forth32/dvk-fpga/board/tang/pict/ioboardb.png

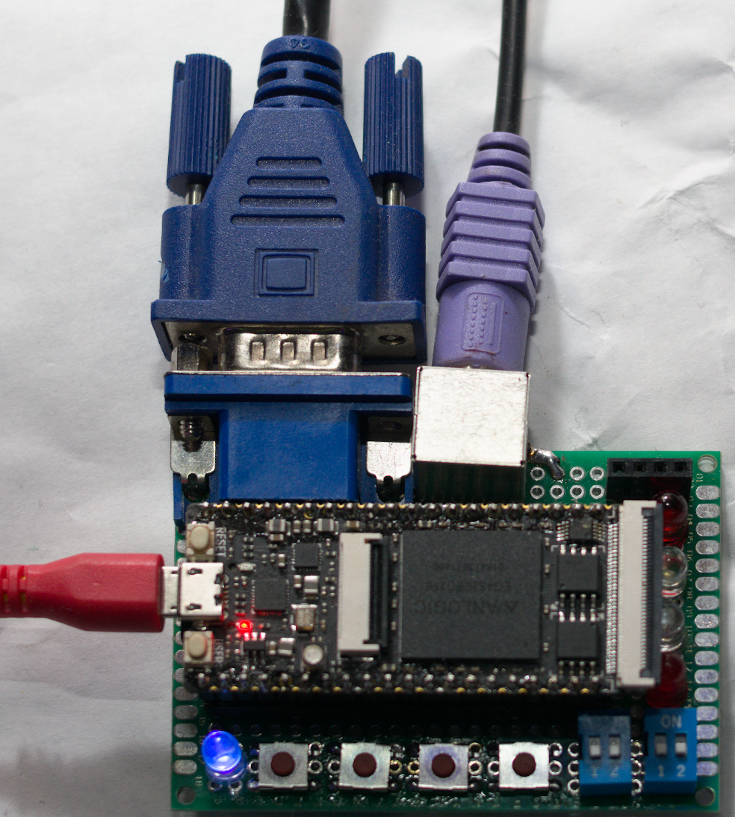
board/tang/pict/ioboardb.png
