forth32/dvk-fpga/board/tang/pict/ioboards.png

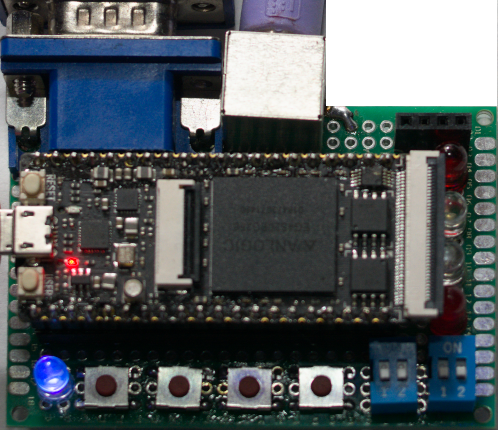
board/tang/pict/ioboards.png
