forth32/dvk-fpga/board/tang/pinout.ods

Led[0] | RK | R2
Led[1] | DW | P2
Led[2] | MY | N5
Led[3] | DX | C9
Led[4] | Timer | L12
sw[0] | disk0 | A4
sw[1] | disk1 | A3
sw[2] | console | C5
sw[3] | cpu speed | B6
bt[0] | reset | B10
bt[1] | halt | B15
bt[2] | term_rst | E16
bt[3] | timer | J11
 | PS2 Clk | T7
 | PS2 Data | R7
 | VGA R | M12
 | VGA G | R16
 | VGA B | N12
 | VGA HS | P12
 | VGA VS | N11
