forth32/dvk-fpga/board/QMTECH-E55/pinout.ods

QMTECH EP55 pinout
SDRAM
A0 | V2 |  | DQ0 | AA10
A1 | V1 |  | DQ1 | AB9
A2 | U2 |  | DQ2 | AA9
A3 | U1 |  | DQ3 | AB8
A4 | V3 |  | DQ4 | AA8
A5 | V4 |  | DQ5 | AB7
A6 | Y2 |  | DQ6 | AA7
A7 | AA1 |  | DQ7 | AB5
A8 | Y3 |  | DQ8 | Y7
A9 | V5 |  | DQ9 | W8
A10 | W1 |  | DQ10 | Y8
A11 | Y4 |  | DQ11 | V9
A12 | V6 |  | DQ12 | V10
BA0 | Y1 |  | DQ13 | Y10
BA1 | W2 |  | DQ14 | W10
CKE | W6 |  | DQ15 | V11
CLK | Y6 |  | CS | AA3
LDQM | AA5 |  | WE | AB4
UDQM | W7 |  | RAS | AB3
 |  |  | CAS | AA4
SD card
SD | SPI
DAT2 |  | AB16
DAT3 | CS | AA16
CMD | DI (MOSI) | AB15
CLK | SCLK | AA15
DAT0 | DO (MISO) | AB14
DAT1 |  | AA14
CD |  | AB13
UART
RxD | J2
TxD | J1
LED-дисплей
col0 | B5 |  | seg_A | C4
col1 | B3 |  | seg_B | B2
col2 | B6 |  | seg_C | A3
 |  |  | seg_D | C3
 |  |  | seg_E | A5
 |  |  | seg_F | B4
 |  |  | seg_G | B1
 |  |  | DP | A4
VGA
R0 | N20 |  | G0 | D22
R1 | B21 |  | G1 | E21
R2 | M20 |  | G2 | C22
R3 | N19 |  | G3 | D21
R4 | M19 |  | G4 | C21
B0 | H21 |  | G5 | B22
B1 | H22
B2 | F21 |  | HS | J21
B3 | F22 |  | VS | J22
B4 | E22
Кнопки
SW1 | AA13 |  | key0 | W13
SW2 | A10 |  | key1 | Y13
SW3 | B10
SW4 | A9
SW5 | B9
Светодиоды
LED1 | A8 |  | LED0 | E4
LED2 | B8
LED3 | A7
LED4 | B7
LED5 | A6
Тактовый генератор
clk50 | T2
