forth32/dvk-fpga/board/tang/pict/ioboard-rs232.png

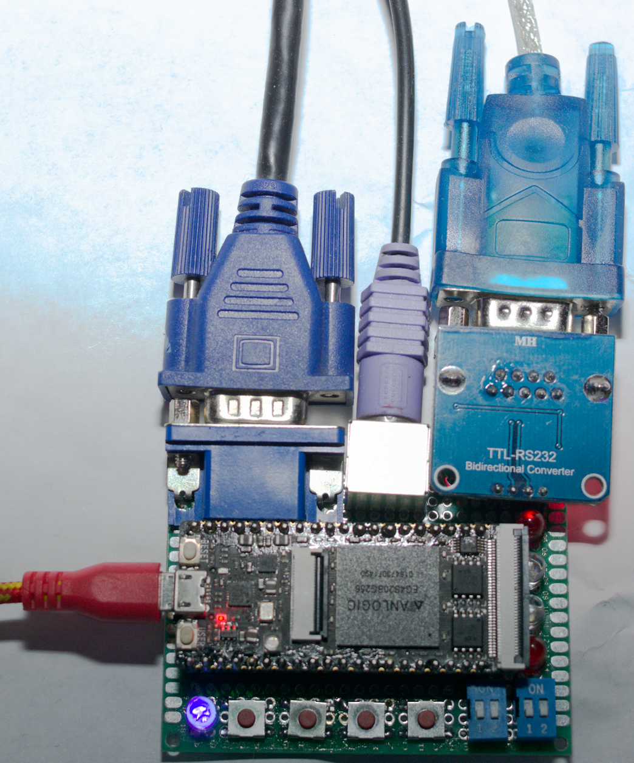
board/tang/pict/ioboard-rs232.png
