forth32/dvk-fpga/board/tang/pict/tang.jpg

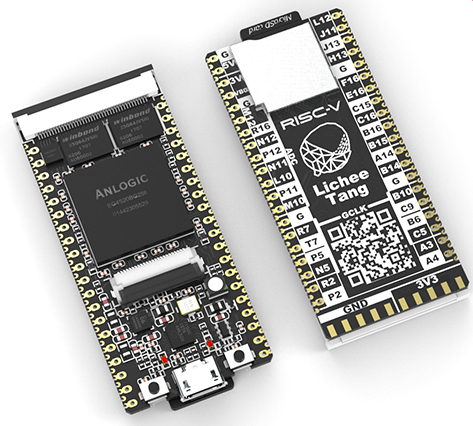
board/tang/pict/tang.jpg
