forth32/dvk-fpga/screenshot/basic.png

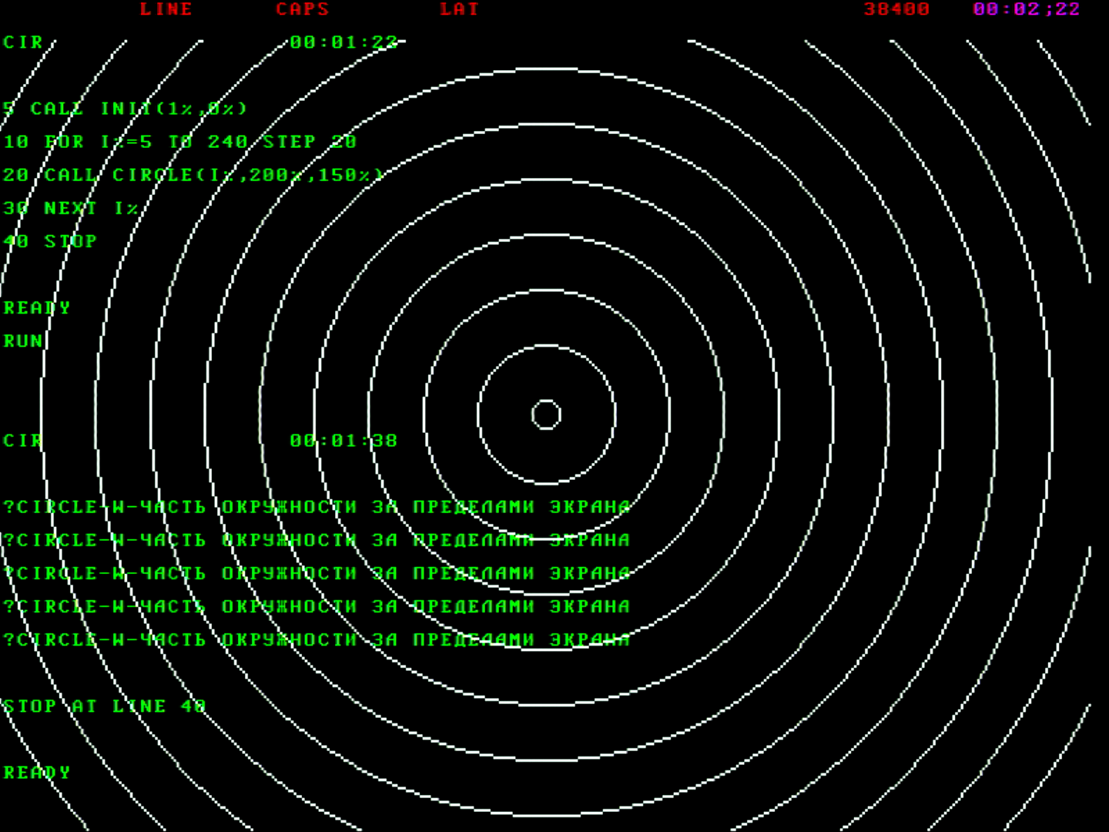
screenshot/basic.png
