forth32/dvk-fpga/screenshot/clock.png

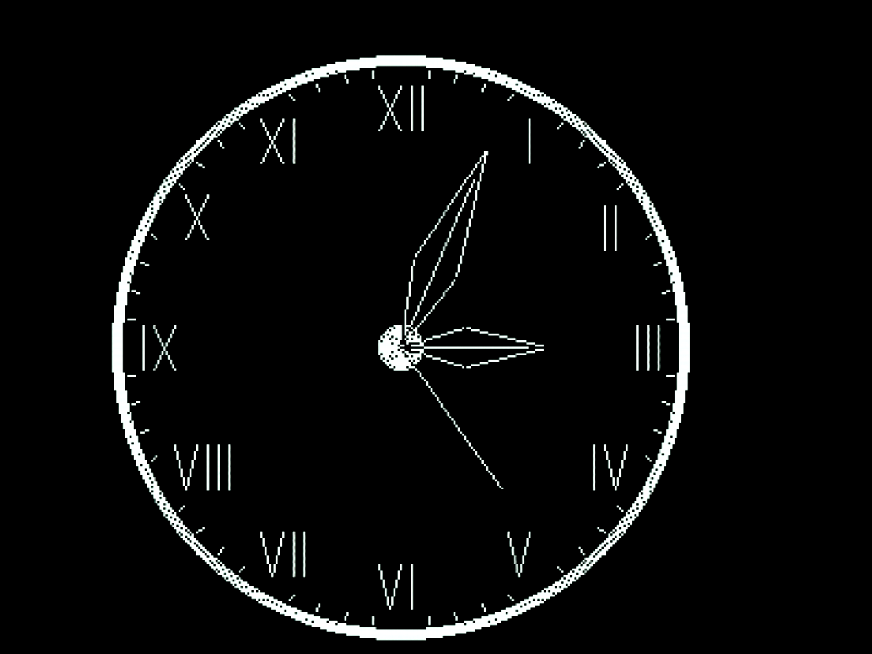
screenshot/clock.png
