forth32/dvk-fpga/screenshot/diger.png

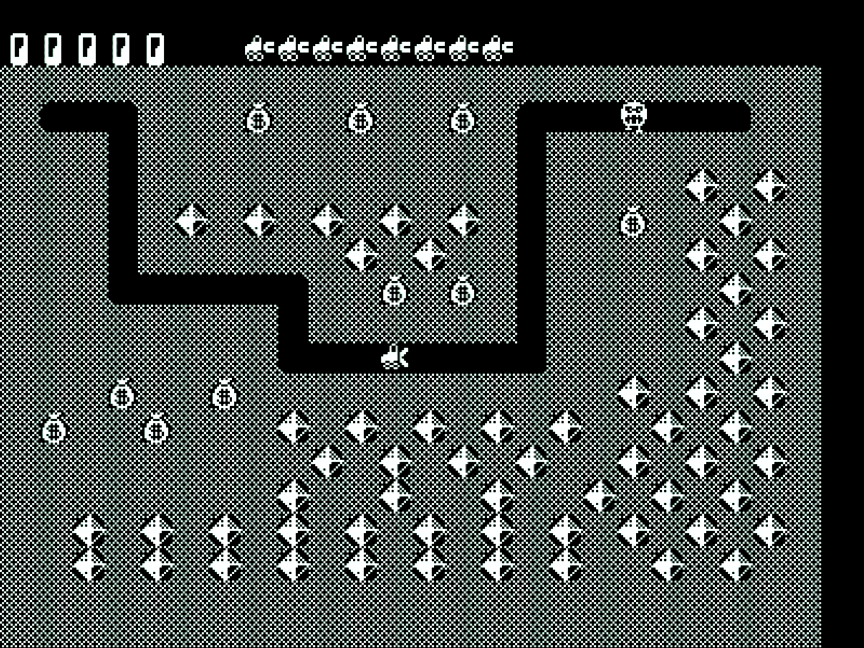
screenshot/diger.png
