forth32/dvk-fpga/screenshot/fmg.png

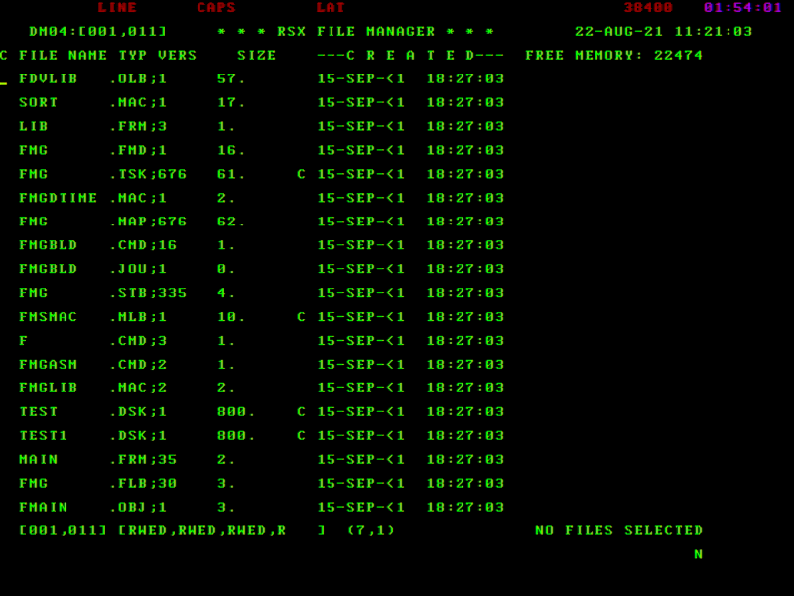
screenshot/fmg.png
