forth32/dvk-fpga/screenshot/ksmfont-rt11.png

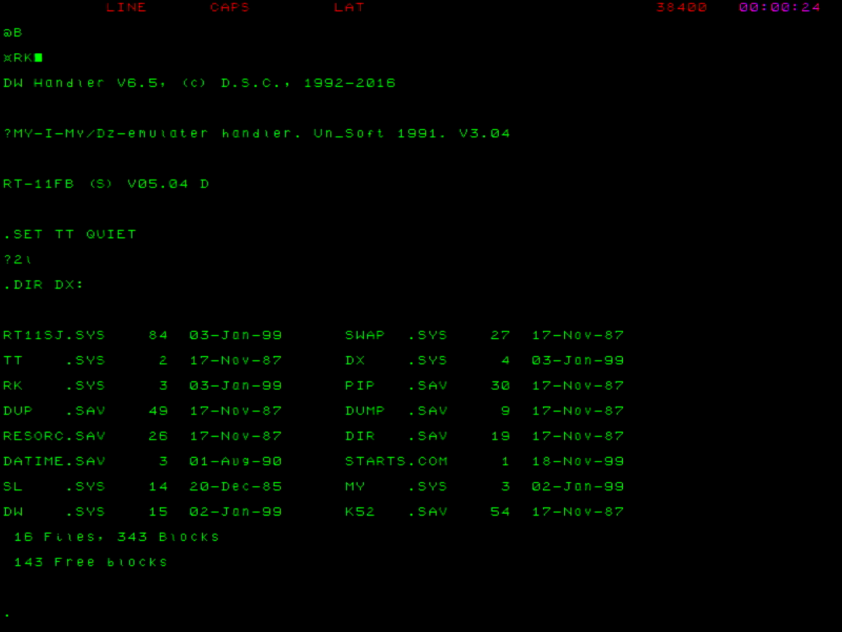
screenshot/ksmfont-rt11.png
