forth32/dvk-fpga/screenshot/land.png

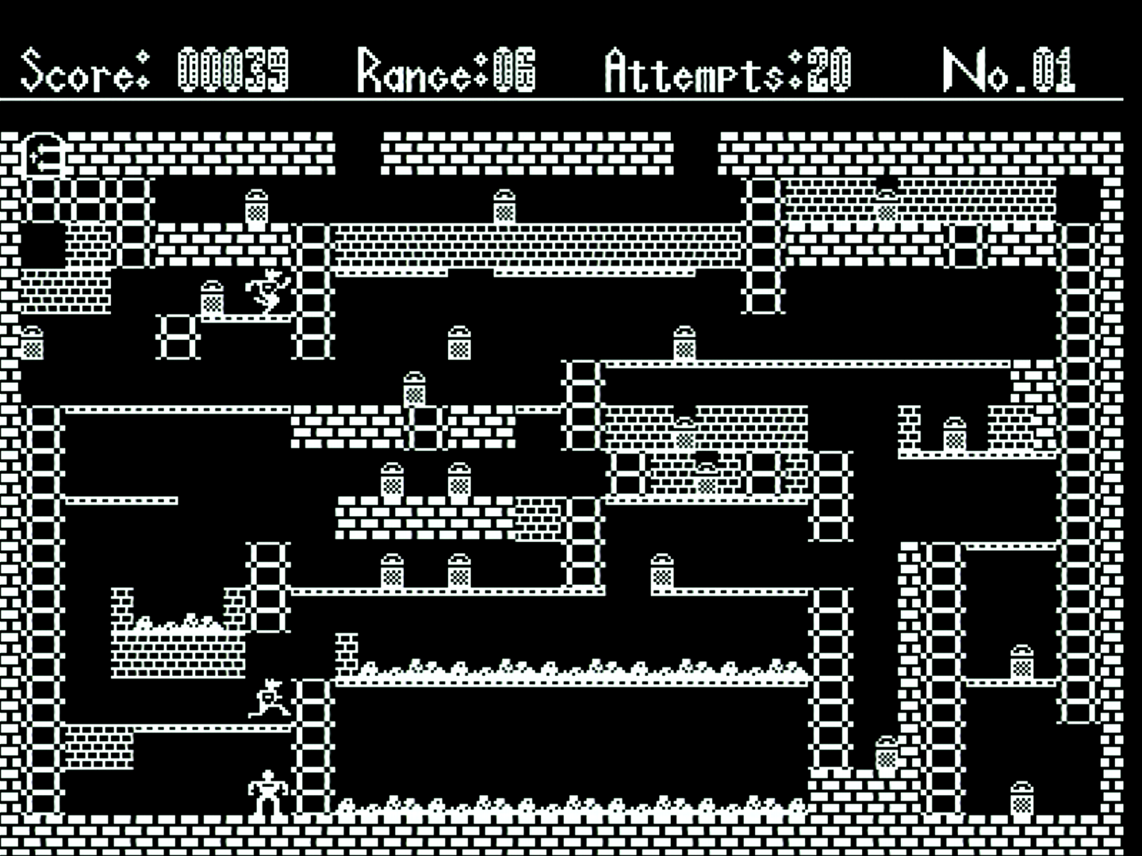
screenshot/land.png
