forth32/dvk-fpga/screenshot/ramtest.png

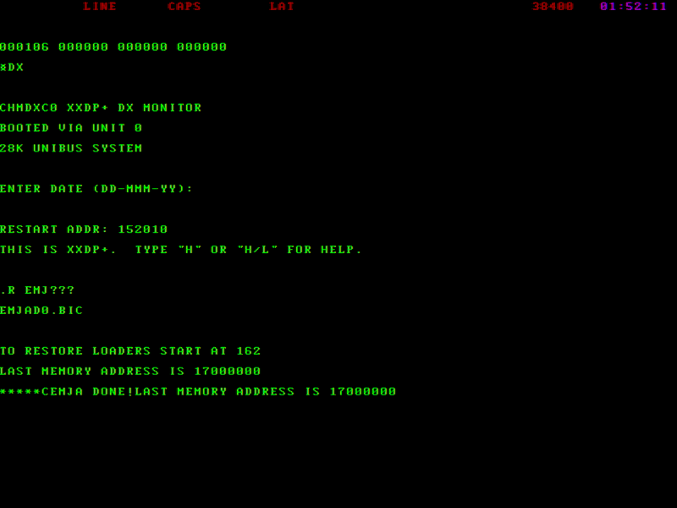
screenshot/ramtest.png
