forth32/dvk-fpga/screenshot/rsts10-mon1.png

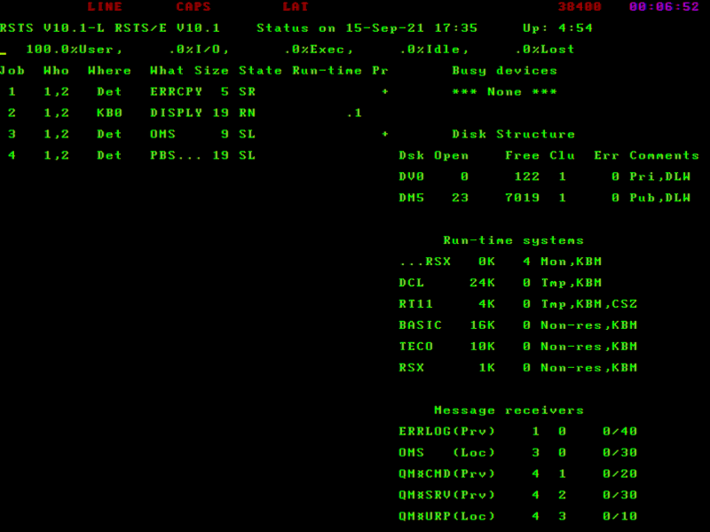
screenshot/rsts10-mon1.png
