forth32/dvk-fpga/screenshot/rsts10-mon2.png

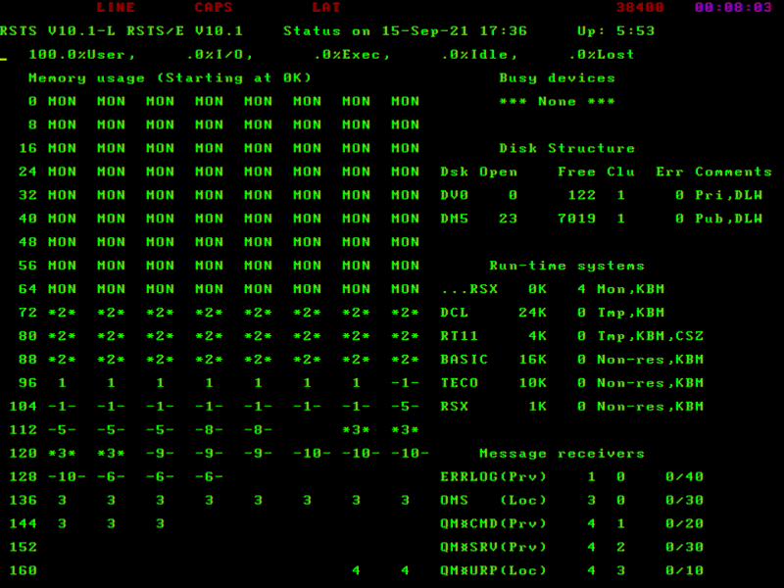
screenshot/rsts10-mon2.png
