forth32/dvk-fpga/screenshot/rsts-boot.png

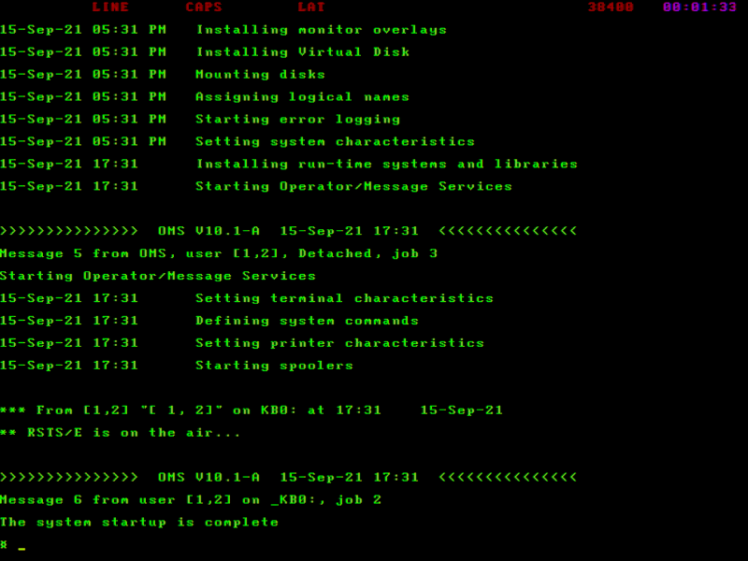
screenshot/rsts-boot.png
