forth32/dvk-fpga/screenshot/rsx11m-boot.png

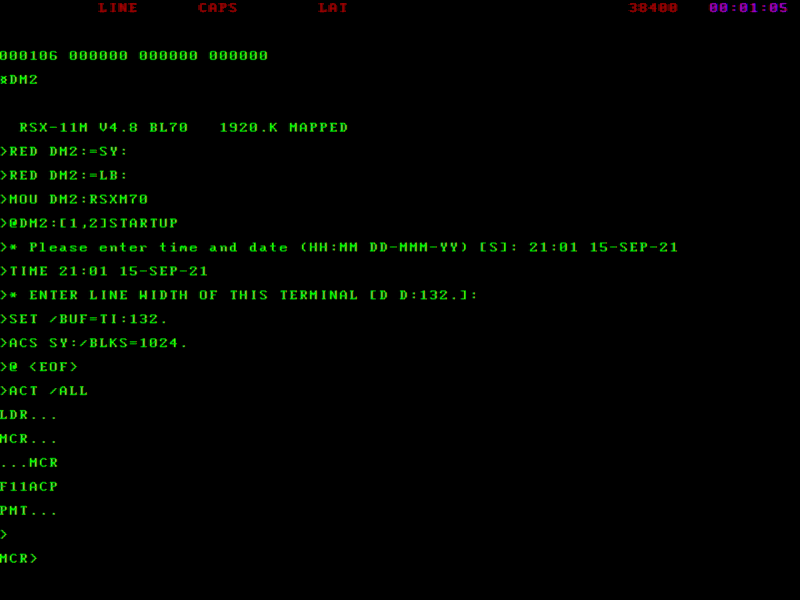
screenshot/rsx11m-boot.png
