forth32/dvk-fpga/screenshot/rsx11m-plus-boot.png

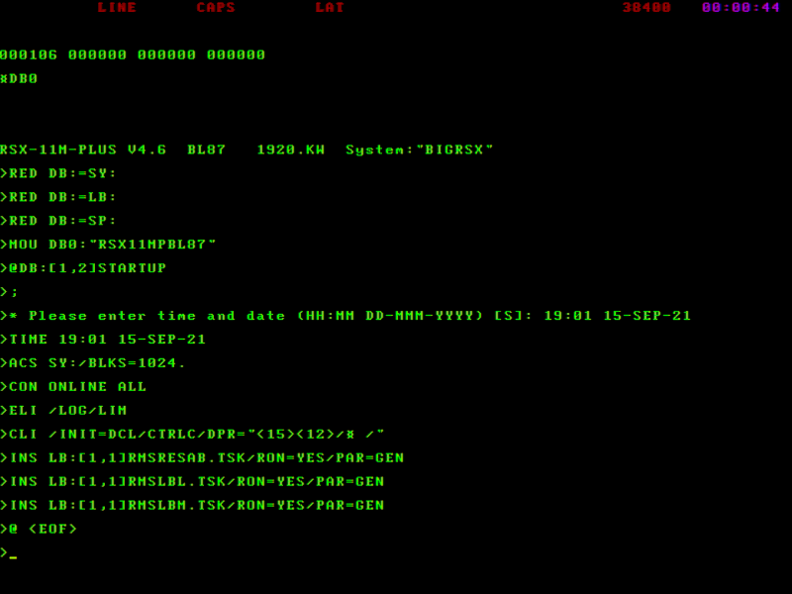
screenshot/rsx11m-plus-boot.png
