forth32/dvk-fpga/screenshot/rsx11m-plus-rmd.png

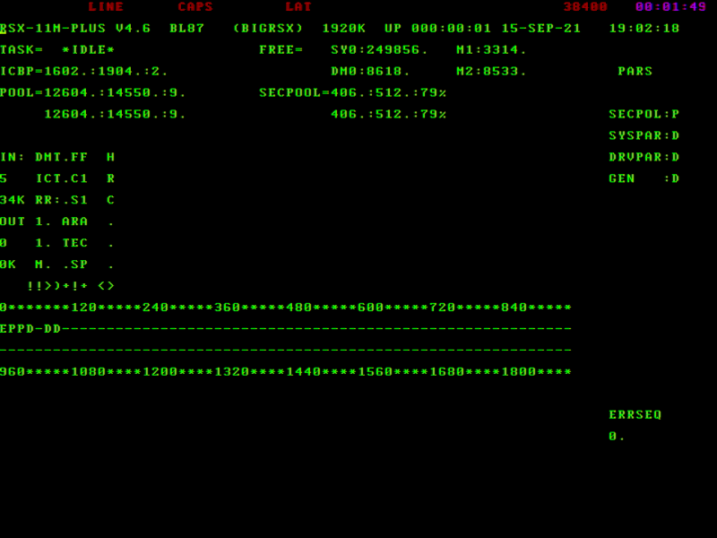
screenshot/rsx11m-plus-rmd.png
