forth32/dvk-fpga/screenshot/statusline.png

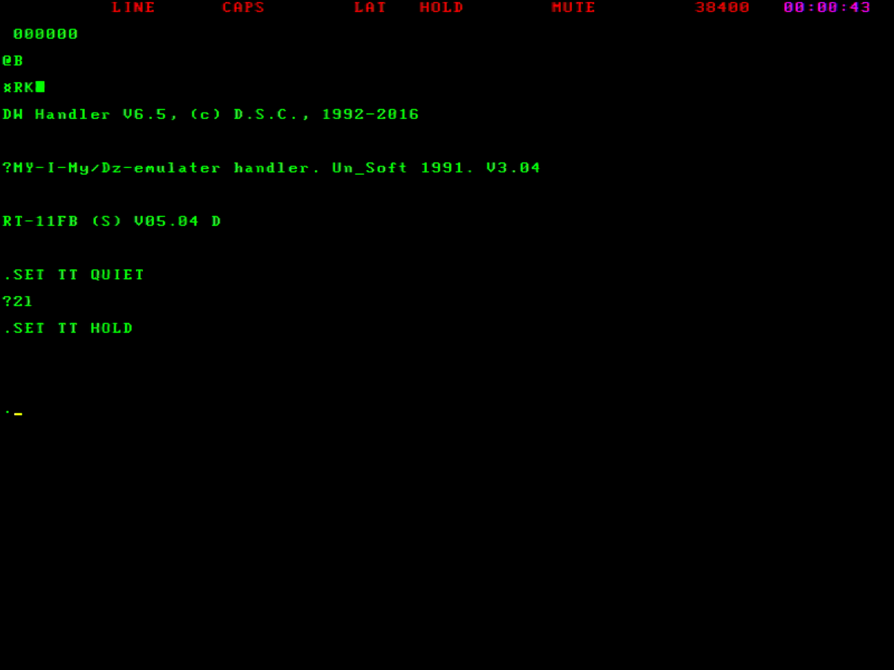
screenshot/statusline.png
