forth32/dvk-fpga/screenshot/ted.png

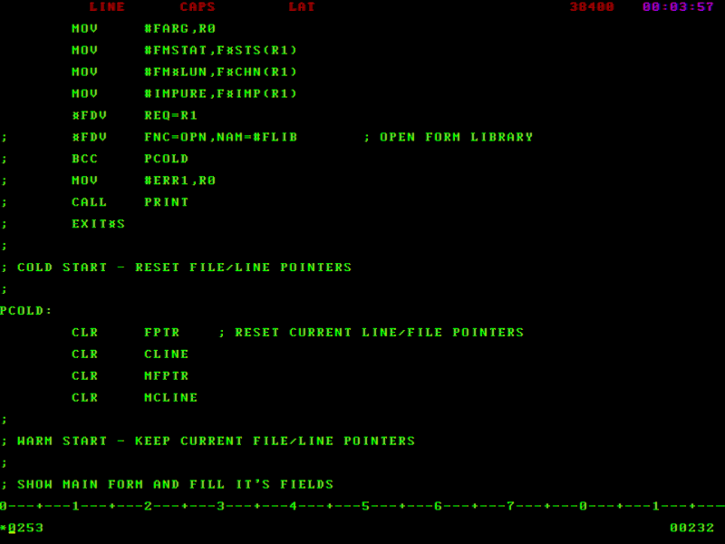
screenshot/ted.png
