forth32/dvk-fpga/screenshot/tmos1-ksmfont.png

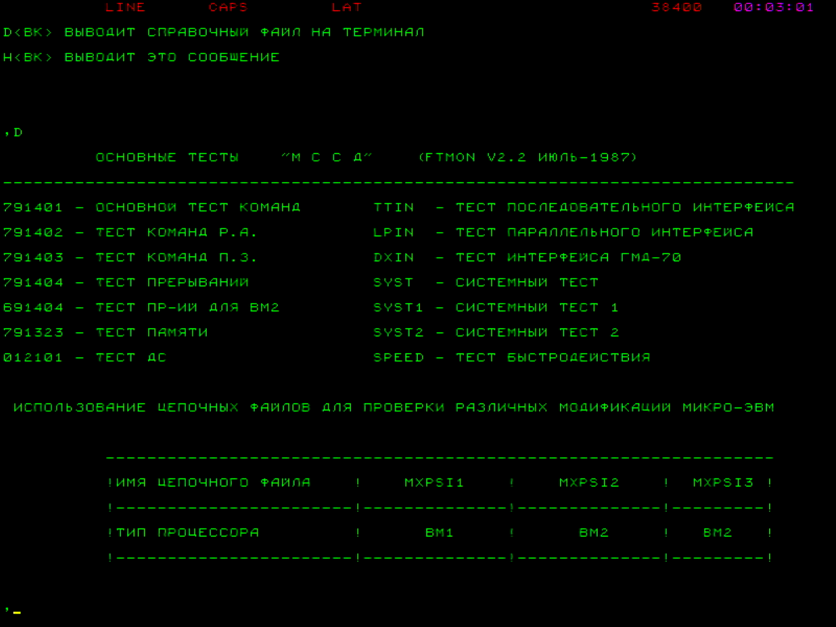
screenshot/tmos1-ksmfont.png
