forth32/dvk-fpga/screenshot/tmos.png

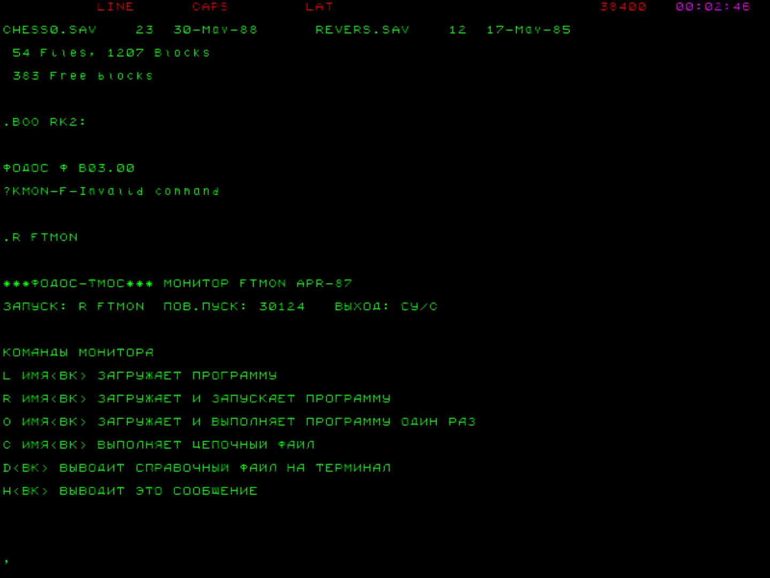
screenshot/tmos.png
