forth32/dvk-fpga/doc/main-manual.odt

FPGA-конструктор

советских ЭВМ

ДВК-1

ДВК-2

ДВК-3

ДВК-4

Электроника-60(-1)

Электроника-79

Описание проекта

# 1. Введение

Данная разработка является FPGA-конструктором, позволяющим из набора готовых модулей собрать FPGA-вариант старых советских pdp11-совместимых ЭВМ. Проект охватывает микро-ЭВМ серий ДВК-1, ДВК-2, ДВК-3, ДВК-4 и Электроника-60/60M, а также ЭВМ Электроника-79, являющихся архитектурными подобиями соответствующих ЭВМ серии pdp-11 фирмы DEC.

Изначально я был вынужден заняться этой разработкой для замены окончательно вышедшей из строя процессорной платы, стоящей в контроллере испытательного стенда в нашей лаборатории. Тут очень кстати великий VSLAV подарил миру FPGA-версию процессора 1801ВМ2, чем и спас наше оборудование. В процессе разработке оказалось проще сделать на FPGA весь контроллер, чем эмулировать асинхронную шину МПИ, в результате чего получилась ДВК-совместимая машина, управляющая нашим стендом. Эта разработка уже полгода работает у нас в лаборатории в достаточно напряженном режиме, и все явные баги более-менее выявлены и устранены.

Проект основан на всех процессорных ядрах, для которых VSLAV произвел реверс и создал рабочее HDL-описание, а также на универсальном синтетическом ядре PDP2011. Возможно, когда-нибудь список поддерживаемых процессоров будет расширен, все зависит от нашего великого цифрвого археолога.

# 2. Общая структура проекта

Все поддерживаемые проектом советские микро-ЭВМ были модульными, и представляли собой соединительную корзину, в которую устанавливались процессорная плата и несколько плат периферийных устройств. Данный проект имеет такую же структуру, содержит ряд готовых процессорных и периферийных плат, и позволяет добавлять также и пользовательские устройства. В этом проекте в качестве общей шины, вместо асинхронной МПИ, используется синхронная шина Wishbone.

В составе проекта имеются процессорные платы, основанных на имеющихся процессорных ядрах:

- К1801ВМ1
- К1801ВМ2
- К1801ВМ3
- М2 (LSI-11)
- М4 (LSI-11M)
- F11 (KDF11B)
- PDP2011 (pdp11/70)

Особенности этих плат рассматриваются в соответствующем разделе.

Также в проект входят модули периферийных устройств, из которых набирается конфигурация ЭВМ:

- Последовательный порт ИРПС, используемый для подключения консольного терминала (TT:), а также дополнительных терминалов, последовательных принтеров (LS:) и магистралей связи с другими ЭВМ (XL:). В конфигурацию по умолчанию входят два таких модуля.
- Параллельный порт ИРПР (LP:) для подключения параллельного принтера. Внешний интерфейс модуля использует протокол Centronics, поскольку настоящих ИРПР-принтеров уже не осталось в природе.
- Дисковый контроллер RK11 (RK:) с подключенными к нему 8 дисками RK05. Советский аналог — СМ5400.
- Дисковый контроллер RK611 (DM:) с подключенными к нему 8 дисками RK07. Советский аналог — СМ5408.
- Дисковый контроллер RH-11/RH-70 (DB:) с подключенными к нему 8 дисками RP06. Советский аналог — ЕС5067.
- Дисковый контроллер RX11 (DX:) с подключенными к нему двумя дисками RX01 (он же ГМД-70)
- Дисковый контроллер КМД (MY:) с подключенными к нему двумя дисководами НГМД-6121 (4 логических диска).
- Контроллер жесткого диска RD50C (DW:) с подключенным к нему HDD на 64М. Контроллер выполнен в стандарте ДВК, а не оригинальном дековском, и для работы требует драйвер DW именно от ДВК (штатный драйвер DW из поставки rt-11 работать не будет).
- Текстовый терминал КСМ (контроллер символьного монитора) с VGA-выходом, подключенный к консольному ИРПС. Скорости терминала и ИРПС аппаратно согласованы.
- Графический контроллер КГД (монхромный контроллер графического дисплея).
- Динамическая память SDRAM размером 4 Mбайт.
- ПЗУ размером 1К с эмулятором пульта и набором загрузчиков, соответствующий DEC M9312.
- Пользовательское ПЗУ размером 8К

Любой ненужный модуль можно легко выкинуть из конфигурации для экономии ресурсов FPGA. Некоторые модули могут работать только совместно (КГД не работает без КСМ). Кроме того, к общей шине можно подключать и другие самодельные модули, создавая нужную пользователю конфигурацию ЭВМ. Например, у меня в конфигурацию входят модули ЦАП, АЦП и дискретного ввода-вывода для подключения к стенду. Рекомендации по написанию таких модулей находятся в отдельном документе build-own-modules.

В полном составе плата является одноплатной версией соответствующей ЭВМ со встроенным терминалом. Вот пример экрана дисплея КСМ с загруженной RT-11:

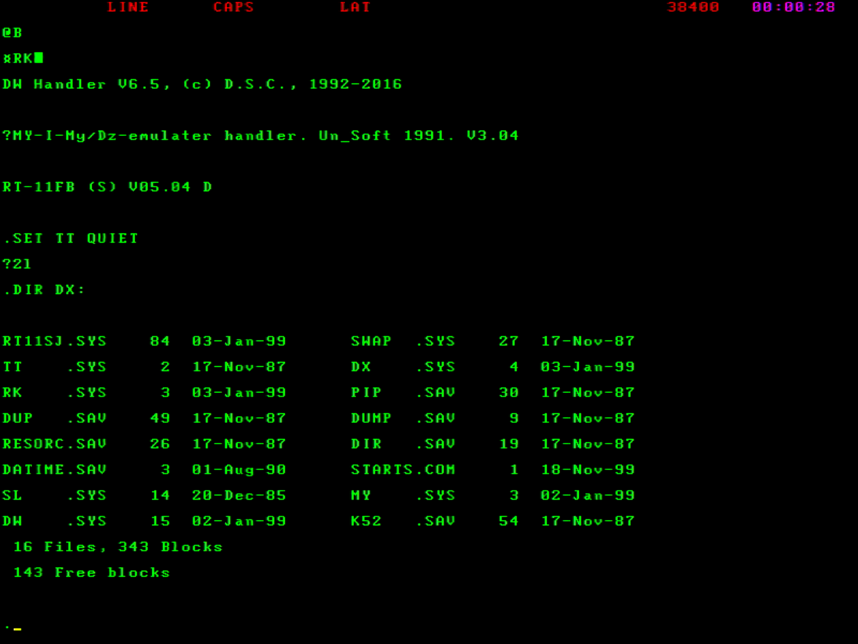
[picture p28: figure]

Поскольку быстродействие полученной ЭВМ гораздо выше прототипа, в схеме имеется возможность снизить тактовую частоту с помощью переключателя sw_cpuslow для работы с игрушками и другими интерактивными программами.

# 3. Используемые FPGA

Разработка сделана на основе FPGA серии Cyclone 4 фирмы Altera (увы, теперь это уже intel). В полном составе схема занимает чуть меньше 9000 ячеек и влезает в микросхему EP4CE10 при использовании процессоров с 16-битным адресом без MMU. Если выкинуть часть дисковых контроллеров и КГД, то схема поместится в самую младшую микросхему этой серии – EP4CE6. Варианты с MMU занимают более 15000 ячеек, и в младшие варианты Cyclone 4 уже не помещается.

Из аппаратных особенностей Cyclone в схеме используется только статическая память (altsyncram) и генератор тактовых сигналов PLL. Поэтому схема легко может быть портирована на Cyclone других серий и вообще куда угодно, лишь бы хватило ресурсов.

В проекте используются следующие модули статической памяти altsyncram:

- rom000 — ROM размером 4096*16 бит, предзагруженный ПЗУ 000 (rom/000.mif) — теневой монитор платы МС1201.01.
- rom055 — ROM размером 4096*16 бит, предзагруженный ПЗУ 055 (rom/055.mif) или 279 (rom/279.mif) — теневой монитор платы МС1201.02.
- rom134 — ROM размером 4096*16 бит, предзагруженный ПЗУ 134(rom/134.mif) - теневой монитор платы МС1201.03/04.
- boot_diag_rom - ROM размером 2048*16, предзагруженный ПЗУ загрузки/диагностики платы kdf11b (rom/f11/boot_diag_rom.mif).
- fontrom — ROM размером 32768*1 бит, предзагруженный файлом экранного шрифта ksm-firmware/font/font-main.mif или ksm-firmware/font/font-ksm.mif..
- vtmem — RAM размером 2048*16, предзагруженный терминальной микропрограммой ksm-firmware/terminal.mif
- kgdram — двухпортовая RAM размером 16384*8, являющаяся видеопамятью графического контроллера КГД. Второй порт этого модуля имеет 1-битную шину данных.
- sectorbuf — двухпортовая RAM размером 256*16, используется модулем SDSPI в качестве секторного буфера.
- bootrom — ROM размером 512*16 бит, содержащий эмулятор пульта и набор загрузчиков DEC M9312.
- userrom — ROM размером 4096*16 бит для хранения образа ПЗУ пользователя.

Если вы используете FPGA серии, отличный от Altera Cyclone, то описатели PLL и модулей памяти придется переделать или создать заново.

Для удобства все файлы, относящиеся к мегафункциям, помещены в каталог ip-components, отдельный для каждой FPGA-платы. При портировании проекта на другую плату эти мегафункции будут зависеть от конкретной примененной FPGA.

# 4. Структура дерева файлов проекта

В дереве проекта имеются следующие каталоги:

- boards/ - хранилище проектов для каждой поддерживаемой FPGA-платы.
- doc/ - документация проекта
- disk/ - утилиты для чтения-записи образов дисков и тестовый дисковый банк
- hdl/ - verilog-файлы основного проекта
- hdl/ksm/ - verilog-файлы модуля КСМ
- hdl/sdram_ip - контроллер SDRAM
- rom/ - файлы образов ПЗУ
- ksm-firmware/ - файлы, относящиеся к микропрограмме КСМ и экранные шрифты.
- screenshots/ - примеры текстовых и графических экранов

Головным модулем проекта является интерфейсный модуль, уникальный для каждой FPGA-платы. Этот модуль адаптирует ядро проекта к конкретной плате — определяет назначение переключателей и индикаторов, а также содержит в себе контроллер SDRAM, тактовый генератор PLL и схему управления VGA DAC.

Ниже интерфейсного модуля находится модуль topboard. Этот модуль является ядром проекта — соединительной корзиной, к которой подключается модуль процессора и набор периферийных устройств. Модуль представляет унифицированный внешний интерфейс, не зависящий от использованной платы FPGA. В проекте есть 2 варианта модуля — topboard16, для процессоров с 16-битной адресной шиной, и topboard22, для процессоров с 22-битной адресной шиной.

К внешним портам модуля подключаются:

- Тактовая частота - clk_p, clk_n, sdclk 12.5 МГц, clk50 50 МГц.
- Кнопки управления
- Переключатели конфигурации
- Индикаторные светодиоды
- Интерфейс для доступа к ОЗУ (SDRAM)
- SD-карта
- сигналы VGA-монитора
- PS/2 клавиатура
- BUZZER (пищалка)
- Линии дополнительного UART
- Линии Centronics для принтера

Конечно, далеко не все из этих портов обязательно куда-то подключать. Например, принтер вряд ли кто-то будет реально использовать. Конкретное подключение этих портов определяется интерфейсным модулем и зависит от примененной платы FPGA.

# 5. Настройка конфигурации создаваемой ЭВМ

В корне проекта лежит файл config.v, с помощью которого настраивается состав проекта. В конфигурацию включается одна из процессорных плат, а также набор необходимых периферийных устройств. Кроме того, с помощью файла конфигурации можно настроить параметры некоторых компонентов — начальные скорости последовательных портов, тип экранного шрифта, параметры видеосигнала и т.д. Более подробная информация содержится в описании соответствующих модулей, а также в комментариях внутри самого файла config.v.

Кроме глобальных настроек, можно также определять настройки конкретной процессорной платы — ее тактовую частоту, начальное состояние таймера, коэффициент замедления процессора, имя файла с образом ПЗУ, и т.д.

# 6. Внешние органы управления и индикации

К внешним портам схемы подключаются 4 кнопки, 3 переключателя и несколько светодиодов. В интерфейсе модуля topboard каждый из этих элементов имеет фиксированное символическое имя. Сопоставление их со светодиодами, кнопками и переключателями конкретной FPGA-платы производится на уровне интерфейсного модуля.

Назначение кнопок:

- bt_reset – кнопка общего сброса. Инициализирует все подсистемы, кроме терминального модуля.
- bt_halt – кнопка вызова пультового прерывания. При ее нажатии работа текущей программы прерывается, и ЭВМ переходит в пультовый режим. Вместо этой кнопки можно установить двухпозиционный переключатель (программа-пульт), как это сделано в оригинальных ЭВМ - тогда появится возможность пошагового прохождения программ. Для процессоров, не имеющих пультового режима, эта кнопка возобновляет работу программы после останова процессора по команде HALT. К таким на данный момент относится только процессор PDP2011.
- bt_terminal_rst – кнопка сброса терминального модуля, помогает при его зависании или просто для очистки экрана.
- bt_timer – включение-выключение таймерного прерывания. Каждое нажатие кнопки переключает режим таймера (вкл-выкл). Для конфигураций, в которых используется сетевой таймер KW-11L или LTC, эта кнопка не используется, а включение-выключение производится через регистр управления.

Назначение переключателей:

- sw_diskbank – эти переключатели выбирают дисковый банк на SD-карте (описан далее в разделе “дисковая подсистема”).
- sw_console – переназначение консольного порта. Если этот переключатель включен, то к консольному порту ИРПС 1 подключаются внешние линии (irps_txd, irps_rxd), а аппаратный терминал переключается на дополнительный порт ИРПС 2. Это может быть использовано, например, если нужно в качестве консоли использовать компьютер с запущенной на нем терминальной программой.
- sw_cpuslow — включение режима замедления процессора. При выключенном переключателе процессор работает на полной тактовой частоте. Если переключатель включен, то тактовая частота снижается до 4.5 МГц, что примерно соответствует тактовой частоте оригинальной платы. Этот режим необходим для игрушек и других слишком быстро работающих интерактивных программ. Плата МС1280 этот режим не поддерживает.

Назначение индикаторов:

- rk_led – обращение к диску RK
- dm_led - обращение к диску DM
- dw_led – обращение к диску DW
- dx_led – обращение к диску DX
- my_led – обращение к диску MY
- db_led – обращение к диску DB
- timer_led – индикация состояния таймера (светится – таймер вкл).

Для 22-битных процессорных плат добавляются еще 3 индикаторных линии - led1, led2, led3. Их назначение зависит от конкретной использованной процессорной платы и описывается в документации на нее.

В данном случае подразумевается, что:

- Кнопка в нажатом состоянии выдает 1, в отжатом 0
- Переключатель в отключенном положении выдает 0, во включенном – 1
- Светодиод светится при установке его порта в 0.

# 7. Интерфейсный модуль

Интерфейсный модуль производит адаптацию проекта к конкретной FPGA-плате. Он является посредником между соединительным модулем topboard и физическими портами FPGA. Кроме того, модуль содержит в себе PLL, контроллер SDRAM и схему управления цветовыми DAC интерфейса VGA.

Интерфейсный модуль разрабатывается индивидуально под каждую FPGA-плату. В дереве проекта уже имеются готовые модули для некоторых плат, их можно использовать как основу для создания собственного модуля при портировании на свою плату.

## 7.1. Контроллер SDRAM

Этот контроллер формирует блок оперативной памяти ЭВМ. Модуль должен обеспечивать 4 мегабайта ОЗУ, однако для полной реализации процессорных плат без диспетчера памяти достаточно 64К.

Реализация контроллера зависит от конкретной микросхемы SDRAM, стоящей на FPGA-плате. В проект входит один из вариантов контроллера, позволяющий работать с 16-битными микросхемами SDRAM емкостью до 16 МБ, организованными как 4 банка по 4Мб. Основной временной параметр — Cas Latency, установлен равным 2. Если SDRAM поддерживает только CL3, то следует исправить значение cas_latency в файле config.v. Но тогда на один цикл обращения к памяти будет уходить 12 тактов.

Если у вас на плате установлена микросхема SDRAM другого типа, например DDR2, то контроллер придется делать самостоятельно.

Модуль topboard обеспечивает унифицированный интерфейс для работы с памятью. Сигналы этого интерфейса в основном соответствуют стандартному набору сигналов wishbone-шины:

- sdram_reset — сигнал сброса. По этому сигналу контроллер производит реинициализацию микросхемы SDRAM
- sdram_stb — строб начала обмена с памятью
- sdram_we — высокий уровень этого сигнала сообщает контроллеру, что идет операция записи.
- sdram_sel[1:0] — маска, определяющая, какие именно байты (старший, младший или оба) будут записываться. При чтении эта маска игнорируется, читаются всегда оба байта.
- sdram_ack — ответ от контроллера (reply), подтверждающий окончание транзакции.
- sdram_adr[21:0] — шина адреса
- sdram_out[15:0] — входная шина данных (из хоста в память)
- sdram_dat[15:0] — выходная шина данных (из памяти к хосту)
- sdram_ready — выходной сигнал, формируемый контроллером по окончании процесса инициализации памяти.

Для всех контроллеров SDRAM, имеющихся в проекте, реализован режим удвоения тактовой частоты. Это означает, что тактовая частота памяти всегда ровно в 2 раза выше тактовой частоты процессора. Это позволяет увеличить производительность системы примерно на 80% без необходимости принятия мер по фильтрации сигналов от метастабильности.

## 7.2. Тактовый генератор PLL

PLL должна выдавать 4 тактовых сигнала:

1. clk_p прямая фаза (0°) - основной тактовый сигнал
2. clk_n инверсная фаза (180°) - дополнительный тактовый сигнал процессорного модуля.
3. sdclk 12.5 МГц прямая фаза (0°) - тактовый сигнал SD-контроллера и карты памяти.
4. sdram_clk прямая фаза (0°) - удвоенная частота сигнала clk_p.

Частота основного тактового сигнала зависит от процессорной платы и примененной FPGA, и задается в файле конфигурации. Соответственно, модуль PLL принимает 2 макроса — PLL_MUL и PLL_DIV, устанавливающих делитель и умножитель основной тактовой частоты. Для Cyclone 4 это делается так:

altpll_component.clk0_divide_by = `PLL_DIV,

altpll_component.clk0_duty_cycle = 50,

altpll_component.clk0_multiply_by = `PLL_MUL,

altpll_component.clk0_phase_shift = "0",

altpll_component.clk1_divide_by = `PLL_DIV,

altpll_component.clk1_duty_cycle = 50,

altpll_component.clk1_multiply_by = `PLL_MUL,

altpll_component.clk1_phase_shift = "5000",

altpll_component.clk2_divide_by = 4,

altpll_component.clk2_duty_cycle = 50,

altpll_component.clk2_multiply_by = 1,

altpll_component.clk2_phase_shift = "0"

Файл описания pll — ip-components/pll.v

Собственный генератор платы должен обеспечивать частоту 50 МГц, которая используется PLL для синтеза вышеуказанных трех сигналов, а также напрямую терминальным модулем КСМ для формирования видеосигнала VGA. Если ваша плата имеет генератор другой частоты, то 50 МГц также придется синтезировать с помощью PLL.

## 7.3. Схема управления цветами VGA DAC

Модуль topboard обеспечивает 3 однобитных сигнала, включающих соответствующий цвет: vgared, vgagreen, vgablue.

В зависимости от подключения разъема VGA на конкретной FPGA-плате требуется создание схемы, преобразующий эти однобитные цвета в многобитную шину, поступающую на вход каждого из видео-ЦАП, например:

// выбор яркости каждого цвета

assign vgag = (vgagreen == 1'b1) ? 6'b111111 : 6'b000000 ;

assign vgab = (vgablue == 1'b1) ? 5'b11111 : 5'b00000 ;

assign vgar = (vgared == 1'b1) ? 5'b11111 : 5'b00000 ;

Если на вашей плате разрядность ЦАП другая, эту схему необходимо поправить под ваши нужды. Если ЦАП вообще отсутствует и линии R, G, B разъема VGA подключены непосредственно к портам FPGA, то преобразователь вообще не требуется.

# 8. Соединительный модуль верхнего уровня.

Модуль topboard — это, по сути, соединительная панель (корзина), к которой подключаются остальные модули. Именно так были устроены и оригинальные ЭВМ — процессор и вся периферия находится на отдельных платах, а корзина обеспечивает их питанием и соединяет в общую шину МПИ.

В данном проекте соединительная плата topboard обеспечивает общую шину Wishbone, а также содержит ряд вспомогательных компонентов:

- Генератор системных сбросов (DCLO и ACLO)
- Схема формирования сигналов выбора каждого периферийного устройства (xxx_stb)
- Контролллер(ы) прерываний
- Арбитр DMA и коммутатор источника сигналов шины Wishbone.
- Арбитр доступа к SD-карте
- Формирователь сигналов управления видео-ЦАП VGA
- Коммутатор линий последовательных портов.
- ПЗУ с резидентной программой пользователя (отключаемое)

Состав включаемых в соединительную плату устройств определяется файлом конфигурации config.v. В конфигурацию обязательно включается одна (и только одна) процессорная плата и один последовательный порт (системная консоль). Все остальные компоненты являются необязательными и подключаются в схему при необходимости.

Соединительная плата обеспечивает унифицированный интерфейс, не зависящий от примененных FPGA. Согласованием с конкретной FPGA-платой занимается интерфейсный модуль, являющийся модулем верхнего уровня проекта.

## 8.1. ПЗУ пользователя.

Как и в оригинальных микро-ЭВМ, в этом проекте предусмотрено подключение ПЗУ пользователя в адресное пространство 140000-157777 вместо соответствующего банка ОЗУ. В ЭВМ ДВК-1 в этом ПЗУ штатно размещался интерпретатор бейсика или фокала, что позволяло использовать ЭВМ в полностью бездисковой конфигурации. В остальных машинах на процессорной плате предусмотрена пустая колодка для установки ПЗУ пользователя.

В этом проекте для фомирования этого ПЗУ предусмотрена мегафункция altsyncram с именем userrom. Для включения ПЗУ в конфигурацию в файле config.v надо раскомментировать строчку `define userrom, и указать имя mif-файла с загружаемым образом ПЗУ. В каталоге rom/ лежат готовые к использованию образы ПЗУ 013 (basic) и 058 (focal).

Возможность подключения ПЗУ пользователя доступна только для плат с 16-битным адресом.

## 8.2 Генератор сбросов

Этот модуль вырабатывает согласованную пару сигналов, предназначенных для сброса процессорного ядра — ACLO и DCLO. Входным сигналом, приводящим к сбросу, является кнопка сброса sw[0], а также сигнал готовности PLL и SDRAM — процессор запускается только после выхода PLL и динамической памяти в рабочий режим.

Кроме сигнала сброса процессора, модуль также формирует сигнал сброса динамической памяти. Этот сигнал формируется только на основе кнопки и готовности PLL.

## 8.3 Контроллер прерываний

Контроллер прерываний реализует механизм векторных прерываний процессора. По сигналу запроса IRQ, выданному одним из периферийных устройств, модуль выдает процессору сигнал векторного прерываний VM_VIRQ, затем выставляет на шину соответствующий устройству вектор прерывания, и передает прерывающему периферийному устройству сигнал подтверждения прерываний IACK.

Все адреса векторов передаются через входную шину IVEC, представляющую собой массив 16-разрядных чисел. В этот список можно дописывать и новые векторы, если в схему добавляются новые модули, требующие обслуживания прерывания. Параметр N модуля определяет количество обслуживаемых им векторов.

На плате topboard22 установлены 2 контроллера прерываний, поскольку процессоры с MMU поддерживают несколько входов прерываний разного приоритета. Используются прерывания приоритета 4 (менее приоритетный) для медленных устройств типа терминалов, и приоритета 5 для быстрых устройств типа дисков.

## 8.4. Арбитр DMA

Арбитр предназначен для обслуживания запросов прямого доступа к памяти (DMA), поступающих со стороны периферийных устройств.

Любое устройство на шине может взять управление шиной на себя, и производить обмен данными с памятью и другими периферийными устройствами без участия процессора. Для этого устройство выставляет запрос DMA_REQ. В ответ на это запрос арбитр дожидается окончания текущей транзакции на шине, после чего снимает сигнал CPU_GNT, запрещая тем самым процессору работать с шиной. Точнее говоря, этот сигнал отключает внутренний таймер шины в процессоре и бесконечно растягивает следующую транзакцию. После этого арбитр выдает запрашивающему устройству ответ DMA_ACK, по которому устройство берет на себя управление шиной. Шинные мультиплексоры отключают процессор от шины, и подключают вместо него запрашивающее устройство.

По окончании DMA-обмена устройство снимает сигнал DMA_REQ, процессор вновь подключается к шине и продолжает работу.

В схему арбитра также входит коммутатор сигналов шины Wishbone, подключающий шину к одному из устройств, запросивших DMA-обмен, или процессору, если нет запросов DMA.

Для 22-битных процессоров реализован режим Unibus Mapping, позволяющий unibus-устройствам, умеющим формировать только 18-битный DMA-адрес, работать с полной 22-битной адресной шиной. При этом адрес, а также строб доступа к памяти ram_stb, формируется модулем UMR, работающим в связке с диспетчером памяти процессора. Этот модуль, если он включен, транслирует 18-битный адрес, выставляемый на адресную шину устройством, в полный 22-битный адрес, на основе предварительно настроенных таблиц преобразования.

## 8.5 Арбитр SD-карты.

Арбитр SD-карты позволяет всем дисковым контроллерам использовать одну и ту же SD-карту для хранения дисковых массивов. При этом каждому контроллеру выделяется отдельный участок в пространстве блоков SD-карты.

Дисковый контроллер, желающий получить доступ к карте, выставляет запрос SDREQ. Арбитр проверяет, не занята ли карта обменом с другим контроллером, и, если карта свободна, подключает ее к запрашивающему доступ контроллеру, и сигнализирует об этом ответом SDACK. По окончании работы с картой контроллер снимает запрос SDREQ, арбитр отключает карту от контроллера и переходит в состояние ожидания очередного запроса. Если на момент поступления запроса карта занята другим контроллером, запрос ставится в очередь и будет обслужен сразу после освобождения карты.

В схеме существует один дисковый контроллер, к которому карта подключается по умолчанию, если нет других активных запросов. Этот контроллер производит инициализацию карты. Таким контроллером по умолчанию может быть объявлен любой из дисковых контроллеров.

## 8.6. Формирователь сигналов управления видео-ЦАП VGA

Как правило, на отладочных FPGA-платах, имеющих VGA-разъем, установлен ЦАП для каждого из цветовых сигналов. Обычно такой ЦАП имеет 4-5 разрядов, и нужен для управления яркостью каждого из цветов. Поскольку в данном проекте видеосигналы не используют градации яркости, на видео-ЦАП подаются фиксированные значения — 0 для темной точки и некоторая величина (обычно — максимальная, типа 5'b11111) для светлой точки.

Схема формирователя зависит от разрядности ЦАП на конкретной плате и может потребовать коррекции при адаптации проекта. Вот пример формирователя для 6-битного зеленого и 5-битных красного и синего сигналов:

assign vgag = (vgagreen == 1'b1) ? 6'b111111 : 6'b000000 ;

assign vgab = (vgablue == 1'b1) ? 5'b11111 : 5'b00000 ;

assign vgar = (vgared == 1'b1) ? 5'b11110 : 5'b00000 ;

Шины vgar, vgag, vgab — это выходные порты модуля topboard, подключаемые к видео-ЦАП на плате.

## 8.7. Коммутатор линий последовательных портов.

Это устройство управляет подключением выходных линий модулей ИРПС1 и ИРПС2. По умолчанию, ИРПС1 подключен к терминальному модулю КСМ, а ИРПС2 — к выходным портам платы irps_txd и irps_rxd. С помощью переключаетя sw_console есть возможность поменять эти сигналы местами — тогда ИРПС2 подключается к терминалу, а ИРПС1 — к внешним портам. Это нужно, например, для вывода консольного терминала на последовательный порт PC, чтобы использовать в качестве консоли запущенную на PC терминальную программу.

Кроме этого, данное устройство управляет скоростью последовательных портов. Скорость ИРПС, подключенной к терминалу КСМ, определяется самим модулем КСМ (и может изменяться кнопками F5/F6 клавиатуры КСМ). Скорость другого порта ИРПС фиксирована и задается в файле конфигурации config.v.

## 8.8. Особенности 22-битной соединительной платы.

Плата topboard22 предназначена для подключения процессоров, имеющих в своем составе диспетчер памяти MMU. При этом адресное пространство увеличивается до 4Мбайт, и распределяется следующим образом:

00000000 — 16777777 = ОЗУ

17000000 — 17757777 = область Unibus Mapping

17760000 — 17777777 = страница ввода-вывода

При отключенном MMU распределение адресного пространства такое же, как и у 16-битных процессоров: до 175777 ОЗУ, 176000-177777 страница ввода-вывода.

В отличие от 16-битных процессоров, здесь на шине формируются 2 отдельных строба — ram_stb для доступа к ОЗУ и bus_stb для доступа к странице ввода-вывода. Эти же сигналы формируют периферийные устройства, поддерживающие 22-битный DMA. Остальные устройства используют для этой цели механизм Unibus Mapping.

22-битная соединительная плата формирует дополнительные сигналы индикации — led1, led2, led3. Их назначение определяется конкретной исползуемой процессорной платой.

# 9. Процессорные платы.

В состав проекта включены процессорные платы:

Плата | Процессор | ЭВМ | Шина адреса, бит | EIS | FIS | FPP | MMU
МС1201.01 | К1801ВМ1 | ДВК-1, ДВК-2 | 16 | MUL
МС1201.02 | К1801ВМ2 | ДВК-3 | 16 | + | +
МС1201.03 | К1801ВМ3 | ДВК-3М,4 | 22 | + | | | +
МС1201.04 | К1801ВМ3 | ДВК-4 | 22 | + | | | +
МС1260 | М2 (LSI-11) | Электроника-60 | 16 | + | +
МС1280 | М4 (LSI-11M) | | 16 | + | +
KDF11B | F11 | Электроника-60-1, PDP11/23 | 22 | + | | + | +
PDP2011 | PDP 11/70 | Электроника-79, PDP11/70 | 22 | + | | + | +

В схему может быть включена только одна плата из всех возможных. Тип соединительной платы (16 или 22) в зависимости от типа процессора выбирается автоматически.

Каждая процессорная плата, кроме собственно процессорного ядра, также содержит некоторые вспомогательные компоненты:

- Интервальный таймер, вызывающий прерывания процессора с частотой 50 Гц.
- Схему управления таймером.
- Схему замедления процессора, позволяющую снизить производительность процессора до уровня оригинальной платы, не изменяя тактовую частоту общей шины.
- Теневое ПЗУ с отладочным монитором и набором загрузчиков.
- ПЗУ консольного пульта с набором загрузчиков.

Интервальный таймер генерирует импульс шириной в один период тактовой частоты шины, повторяющийся с частотой 50 Гц. Этот сигнал подается на вход таймерного прерывания процессора и используется для организации системных часов. Схема управления таймером позволяет включать и выключать эти прерывания кнопкой bt_timer (как и в оригинальных микроЭВМ — переключатель или кнопка «таймер»).

Для 22-битных процессоров на процессорной плате установлен полноценный сетевой таймер KW-11L или LTC, вызывающий прерывание приоритета 6. При этом кнопка ручного включения таймера не используется.

Кроме таймерного прерывания, предусмотрено прерывание пультового режима, вызываемое по кнопке bt_halt. В оригинальных микро-ЭВМ эту функцию выполнял переключатель «программа-пульт». По этому прерыванию прекращается работа основной программы, и управление передается встроенному в ПЗУ или микрокод процессора монитору-отладчику. Для плат, не имеющих пультового режима, эта кнопка возобновляет работу процессора после останова по инструкции HALT.

## 9.1. Плата МС1201.01

Эта плата основана на процессоре КР1801ВМ1. Процессор не поддерживает команд FIS, а из EIS поддерживает только команду MUL, из-за чего RT-11 ошибочно полагает наличие полной поддержки EIS.

Плата содержит 64Кб ОЗУ, разбитых на 8 банков, причем банк 7 исключен из адресного пространства пользователя (на его месте находится страница ввода-вывода)

На плате имеется специальный регистр начального пуска, содержимое младших двух бит которого определяет режим запуска ЭВМ. Возможен запуск с выходом в монитор-отладчик, автозагрузка с гибкого диска, или запуск программы из ПЗУ пользователя. Другие биты этого регистра управляют картой адресного пространства, и определяют начальный адрес запуска (адрес расположения ПЗУ монитора в адресном пространстве).

По умолчанию, после включения питания, прерывания от таймера разрешены, и нажатие кнопки сброса не изменяет состояние таймера.

ПЗУ монитора содержит единственный загрузчик с гибких дисков DX (ГМД-70). Загрузка возможна с любого из дисков DX0 или DX1 и производится командами D0 и D1. Загрузиться с остальных типов дисков можно только из-под уже загруженной с DX операционной системы, или введя загрузчик в память командами монитора.

На этой плате основывались микроЭВМ ДВК-1 и ДВК-2. В качестве ПЗУ с монитором использовалось ПЗУ 1801РЕ2-000. ДВК-1 штатно комплектовались дополнительным пользовательским ПЗУ с Бейсиком (1801РЕ2-013) или Фокалом (1801РЕ2-057). Образы всех этих ПЗУ лежат в каталоге rom/.

В отличие от ДВК-3, машины ДВК-1 или ДВК-2 комплектовались не контроллером КСМ, а аппаратным фрязинским терминалом 15ИЭ-00-013. Однако и КСМ, и фрязинский дисплей полностью совместимы с DEC VT52, и именно в этом режиме эксплуатировалось подавляющее большинство программного обеспечения. Те, кому нужен именно фрязинский дисплей, могут заменить контроллер КСМ на аппратный терминал https://github.com/forth32/vt52. При этом потеряется возможность использовать графический модуль КГД.

## 9.2. Плата МС1201.02

Эта плата основана на процессоре КР1801ВМ2. Процессор полностью поддерживает набор команд EIS, а команды FIS эмулирует с помощью подпрограмм теневого ПЗУ.

Как и предыдущая, эта плата содержит 64Кб ОЗУ, из которых пользователю доступны 56К.

Также имеется регистр начального пуска, но режим запуска определяется уже тремя битами, и, соответственно, имеется 8 режимов запуска. Процессор 1801ВМ2 имеет полноценную аппаратную поддержку теневого режима, поэтому специальных регистров для управления картой памяти не требуется. Режим процессора определяется сигналом SEL, в wishbone-ядре представленным в виде дополнительной адресной линии wb_adr[16].

По умолчанию, после включения питания, прерывания от таймера разрешены, и нажатие кнопки сброса не изменяет состояние таймера.

На плате штатно устанавливалось ПЗУ 1801РЕ2-055. Существует также обновленная версия этого ПЗУ — 279, имеющая расширенный набор команд и дополнительные загрузчики. Каждое из этих ПЗУ имеет в себе богатый набор загрузчиков и поддерживает загрузку с любого из имеющихся в проекте дисков (за исключением загрузчика MY, имеющегося только в ПЗУ 279). Загрузка системы производится командой B, в ответ на приглашение «¤» следует набрать имя и номер загружаемого устройства.

В обоих версиях ПЗУ содержится ошибка, в результате которой загрузка с диска RK становится невозможной. Суть этой ошибки в неправильной длине области, читаемой с диска при начальной загрузке. Когда вводится команда монтиора B RK, монитор копирует код начальной загрузки в память по адресу 1000 и передает туда управление. Этот загрузочный код запускает чтение диска RK, начиная с сектора 0, но читает не один 512-байтовый блок, а два — в этом и заключается ошибка. В результате код загрузчика, начиная с адрес 1000, затирается в режиме DMA данными сектора 1, и по окончании обмена с диском управление получает мусор вместо загрузочного кода. Я внес исправления в обе версии ПЗУ, и в каталоге rom лежат уже исправленные версии.

На этой плате основана микро-ЭВМ ДВК-3.

## 9.3. Плата МС1260

Эта плата основана на секционном процессоре М2 (его прототип — DEC LSI-11). Процессор этот имеет внешнее ПЗУ микрокода, и позволяет подключать дополнительный пользовательский микрокод. Монитор-отладчик также реализован на уровне микрокода, и дополнительные ПЗУ в адресном пространстве отсутствуют. Соответственно, нет ни теневого режима процессора, ни каких-либо переключений карты памяти. Процессор аппаратно поддерживает наборы команд EIS и FIS.

Как и на всех других платах, нижние 56Кб адресного пространства заняты модулем динамической памяти, а выше находится страница ввода-вывода.

Плата имеет 4 режима пуска, из которых практическую пользу имеет только один режим — запуск монитора-отладчика.

По умолчанию, после включения питания, прерывания от таймера запрещены, и нажатие кнопки сброса запрещает прерывания от таймера. Это сделано потому, что разрешенные таймерные прерывания вызывают сбой в загрузке операционной системы. Таймер можно включить после окончания загрузки ОС для работы системных часов.

Встроенный в микрокод монитор не имеет каких-либо загрузчиков, кроме перфоленточного, и загрузку с диска можно произвести только введя в память дамп загрузчика, используя команды монитора, или включив в конфигурацию ПЗУ эмулятора пульта/загрузчик М9312.

На этой плате основана микро-ЭВМ Электроника-60, которая, в основном, использовалась в различных управляющих системах. В качестве полноценной настольной ЭВМ она использовалась крайне редко, если вообще когда-либо использовалась.

## 9.4. Плата МС1280

Эта плата основана на секционном процессоре М4 (прототип — DEC LSI-11M). В отличие от всех предыдущих плат, это процессорное ядро работает на более низкой тактовой частоте — для Cyclone 4 не выше 50 Мгц. В остальном эта плата схемотехнически аналогична МС1260.

Какие ЭВМ собирались на этой плате — мне неизвестно.

## 9.5. Платы PDP2011, KDF11B, МС1201.03/04

Эти платы описываются в отдельных документах, лежащих в каталоге doc дерева проекта.

## 9.6. Загрузчик/консольный пульт М9312

Поскольку большинство процессорных плат в своем ПЗУ/микрокоде содержат достаточно убогий набор дисковых загрузчиков (или вообще их не имеют), в проект добавлено ПЗУ «загрузчик/консольный пульт». Такое ПЗУ встречается на очень многих машинах фирмы DEC, и на всех наших СМ ЭВМ. ПЗУ состоит из двух частей — эмулятор пульта по адресу 165000, и набор начальных загрузчиков по адресу 173000. Образы этих ПЗУ объединены в единый файл bootrom.mif.

В больших ЭВМ PDP-11 (и СМ ЭВМ) это ПЗУ получает управление сразу после запуска процессора (при нажатии кнопки ПУСК на пульте процессора). Так ведет себя процессор PDP2011.

В остальных случаях при старте процессора запускается теневой или микропрограммный монитор, а запуск эмулятора пульта делается вручную, передачей управления на адрес 165020:

@165020G

140001 141432 000776 137652

$

В ответ на приглашение «$» можно ввести одну из следующих команд:

L addr | Установить текущий адрес addr
E<пробел> | Вывести на экран значение ячейки по текущему адресу
D val | Записать значение val по текущему адресу

Практической пользы от этих команд немного, поскольку гораздо удобнее воспользоваться командами теневого/микропрограммного монитора. Но, кроме этих команд, эмулятор позволяет производить загрузку операционной системы со многих типов устройств. Для этого в ответ на приглашение «$» следует ввести имя и номер устройства, например:

@165020G

140001 130050 000776 000000

$DM3

?MY-I-My/Dz-emulater handler. Un_Soft 1991. V3.04

DW Handler V6.5, (c) D.S.C., 1992-2016

RT-11FB (S) V05.04 D

.SET TT QUIET

В данное время загрузчик поддерживает устройства DK, DM, DP, DB, DT, DX. Обратите внимание, что устройство RK05 здесь называется DK, а не RK, как в RT-11.

В отличие от теневого загрузчика платы МС1201.02, данный загрузчик позволяет производить загрузку с любого из 8 устройств, подключенных к контроллеру. Устройства DW и MY не поддерживаются, поскольку не входят в список стандартных устройств фирмы DEC.

ПЗУ М9312 работает только при отключенном таймере. Если в момент запуска консольного пульта таймер будет включен, то произойдет незапланированное прерывание по двойной ошибке шины.

Исходные тексты текущей версии эмулятора/загрузчика лежат в каталоге rom/m9312.

# 10. Дисковая подсистема

Все дисковые контроллеры хранят свои данные на SD-карте. Поддерживаются только SDHC-карты объемом до 64Гб. Карты SDSC для упрощения схемы не поддерживаются – таких карт теперь уже не делают и достать их проблематично. Следует учесть, что многие дешевые китайские SDHC-карты (продающиеся на алиэкспрессе за копейки) некорректно работают в режиме SPI. Некорректность выражается в полном зависании карты при первой же команде записи. Карта перестает реагировать на входящие команды, и вывести ее из этого состояния можно только снятием питания. При этом чтение с карты работает без всяких проблем. Фирменные карты – transcend, kingston, samsung итд, такого бага не имеют.

## 10.1. Распределение адресов на SD-карте

Карта распределения адресов блоков SD-карты под образы дисков, используемая в данном проекте, описана в файле card-layout.ods.

Все дисковые контроллеры разделяют одну и ту же карту. Набор из 8 дисков RK, одного диска DW, двух дисков DX, 4 дисков MY, 8 дисков DB и 8 дисков DM образует дисковый банк размером 2 Гб. Часть этого пространства для дисков не используется и пропадает ради упрощения формирователей адресов. Поскольку такой объем – мизер для современных карт, то дисковых банков на карте можно разместить несколько. В данной схеме поддерживаются 16 банков, переключаемые с помощью 4-битного переключателя sw_diskbank. Все 16 банков занимают 32Гб на карте. Разумеется, необязательно выводить все 4 бит на физический переключатель. Обычно достаточно 2 бит, что дает 4 банка. Но часть битов sw_diskbank можно использовать для задания смещения начала дискового массива на SD-карте, для случая, если на карте хранится какая-либо дополнительная информация.

Каждый модуль дискового контроллера имеет входную шину «start_offset», которая определяет, с какого абсолютного номера блока начинаются образы дисков данного типа. Изменяя это значение, можно перемещать массив дисков в любое место SD-карты. Можно сделать переключаемые банки для каждого типа дисков отдельно, можно даже вынести любой тип диска на отдельную SD-карту. Все определяется вашими потребностями. Главное не забывать, что начальный адрес массива дисков должен быть кратен сумме размеров образов дисков всех устройств, подключенных к данному контроллеру. Например, образ диска MY занимает на карте 2048 блоков, следовательно размер 4 дисков будет равен 8192 блока. Начальный адрес дискового массива должен быть кратен 8192.

Для записи образов дисков на SD-карту используется программа sd-store, а для извлечения образов с карты – программа sd-extract. Обе программы используют контейнеры DSK (посекторные образы дисков), которые распознаются эмулятором simh. Исходные тексты этих программ лежат в каталоге disk/. Карта распределения адресов блоков хранится в файле devtable.h.

Также, для облегчения начального запуска проекта, в каталоге disk лежит полный образ дискового банка в файле initdisk.img. Этот образ содержит в себе следующие ОС:

DM0 | RT-11 V5.5 полный дистрибутив
DM1 | XXDP V2.5
DM2 | RSX-11M V4.8 полный дистрибутив
DM3 | RSTS/E V10.1
DB0 | RSX-11M-PLUS V4.6 полный дистрибутив
DX0 | XXDP с базовым набором тестов PDP11/70
DX1 | RT-11 V5.04 минимальная
MY0 | RT-11 V5.01 с набором игр от ДВК
DK0 | RT-11 V5.04
DK1 | ФОДОС-ТМОС с набором тестов
DK2 | RAFOS+ v2.1
DW0 | RT-11 V5.04 D полный дистрибутив

В преставленных выше системах RT-11 имеется вариант драйвера DW, разбивающий HDD на 4 одинаковых диска по 16 Мб (можно при желании переразбить диск командой set dw part). На дисках RK0, DM0 и DW0 лежат исходные тексты драйвера DW.MAC и командный файл DWBLD.COM для сборки драйвера под конкретную систему. Также а этих дисках лежат исходные тексты драйвера MY. Системы RSX и RSTS/E не поддерживают устройства DW и MY.

Стартовый набор initdisk.img можно прямо записать на SD-карту с нулевого блока командой

dd if=initdisk.img of=/dev/sdx

где sdx – имя устройства SD-карты, например /dev/sdc. Установив записанную карту в плату, можно произвести загрузку системы c любого вышеперечисленного диска.

## 10.2. SDSPI

Для работы с картой памяти используется модуль SDSPI – контроллер SD-карты. За его основу взят одноименный модуль из проекта pdp2011, переписан с мерзкого VHDL на кошерный verilog и переделан под мои потребности. Модуль содержит в себе двухпортовый секторный буфер размером 512 байт с организацией 256*16, и умеет производить 2 простейших операции – прочитать блок с карты в буфер и записать блок из буфера на карту. Работа с буфером происходит на полной скорости общей шины (wb_clk), а операции ввода-вывода на SD-карту вообще шину не занимают и выполняются асинхронно по отношению к процессору. Это позволяет совместить ввод-вывод и работу основной программы, как и в реальной ДВК.

Модуль может работать в двух режимах — ведущего и ведомого. Ведущий контроллер получает доступ к карте по умолчанию, сразу после запуска. Он производит первичную инициализацию SD-карты. Ведущий SDSPI подключается только к одному дисковому контроллеру из всех. К остальным дисковым контроллерам подключается SDSPI в режиме ведомого — в этом режиме инициализация карты не производится. Режим работы sdspi каждого дискового контроллера задается через порт sdmode (0 — ведомый, 1 — ведущий).

Любой из дисков RK, DX, MY или DW также можно вынести на отдельную SD-карту. Для этого порту sdmode контроллера следует присвоить значение 1, а порты sdcard_cs, sdcard_mosi, sdcard_miso, sdcard_sclk подключить к соответствующим выводам отдельной sd-карты. Линии sdreq (запрос доступа к карте) и sdack (подтверждение доступа) в этом случае надо просто замкнуть друг на друга, оключив их от арбитра SD-карты, поскольку контроллер в этом случае управляет картой монопольно.

## 10.3. Модули дисковых контроллеров.

Каждый дисковый контроллер представлен отдельным модулем, подключаемым к общей шине wishbone и диспетчеру SD-карты (или реальной карте). Имеются следующие дисковые модули:

- rk11.v — контроллер дисков RK11 (RK:)
- rx01.v — контроллер 8-дюймового дисковода RX01 (DX:)
- fdd-my.v — контроллер 5-дюймового дисковода (MY:)
- dw.v — контроллер жесткого диска RD50C (DW:)
- rk611.v — контроллер дисков RK611 (DM:)
- rh70.v — контроллер дисков RH-11/RH-70 (DB:)

Любой из этих контроллеров можно безболезненно выкинуть из схемы за ненадобностью.

Сводная таблица дисковых контроллеров

| RK | DX | MY | DW | DM | DB
Емкость, блоков | 4872 | 475 | 1600 | 131072 | 53790 | 341088
Емкость, KB | 2436 | 237 | 800 | 65536 | 26895 | 170544
Размер на SD | 6144 | 4096 | 2048 | 131072 | 65536 | 393216
Число приводов | 8 | 2 | 4 | 1 | 8 | 8
Address | 177400-177416 | 177170-177172 | 172140-172142 | 174000-174026 | 177440-177476 | 176700-176776
Vector | 220 | 264 | 170 | 300 | 210 | 254
DMA | 18 | - | 22 | - | 18 | 18/22
CYL | 312 | 76 | 80 | 1024 | 815 | 815
HD | 2 | 1 | 2 | 8 | 3 | 19
SPT | 10 | 25 | 10 | 16 | 22 | 22
Размер сектора | 512 | 128 | 512 | 512 | 512 | 512

Пояснение к таблице.

- Емкость — это сколько логических блоков по 512 байт влезает на устройство
- Размер на SD — сколько виртуальный образ занимает места на SD-карте. Часть этого пространства может не использоваться и содержать мусор.
- Число приводов — сколько виртуальных приводов подключено к контроллеру.
- DMA — разрядность адреса DMA
- CYL — число цилиндров эмулируемого привода
- HD — число головок
- SPT — количество секторов на одну дорожку
- Размер сектора — размер физического сектора, обрабатываемого данным контроллером. Параметр SPT отражает количество на дорожку секторов именно этого размера. Операционные системы всегда используют логические блоки размером 512 байт, и именно в блоках такого размера вычисляется первый параметр, емкость диска.

Далее подробно описаны каждый из дисковых модулей.

### 10.3.1. Контроллер RK11/RK05 (RK/DK)

Этот модуль реализует контроллер DEC RK11 (RK: в rt-11), с подключенными к нему 8 дисками RK05 объемом 3 Мб. Советским аналогом данного устройства является СМ-5400. Данный дисковый контроллер является одним из самых быстрых – он использует DMA для чтения-записи дисковых буферов. Контроллер этот был реализован самым первым, и уже полгода трудится в нашей лаборатории в качестве рабочего диска.

Размер дискового блока RK05 – 512 байт, что прекрасно соответствует размеру блока SD-карты. Поэтому дисковые образы на SD-карте представляют собой посекторную копию реального диска – каждый логический номер блока LBN совпадает с физическим номером блока от начала образа. Эти образы можно напрямую использовать в simh, установив формат RAW (командой set RKn format=raw).

В реальной жизни диски СМ-5300 крайне редко подключали к ДВК и другим настольным компьютерам — чаще они встречались в составе больших ЭВМ, например СМ-4. Но этот диск — быстрый и удобный для реальной работы. Скорость обмена с этим диском такая же, как у дискеты MY (в данной реализации, конечно), а емкость — гораздо больше.

### 10.3.2. Контроллер RD50C (DW)

Контроллер RD50C (DW: в RT-11) обеспечивает интерфейс с жесткому диску объемом 64М – это максимальный объем, поддерживаемый драйвером DW. Оригинальный контроллер RD50C фирмы DEC был предназначен для работы в машинах DECpro-350, и использовал специфическую для этой машины систему прерываний. В варианте ДВК контроллер работает с обычной системой векторных прерываний, как все другие устройства, и именно в этом варианте реализован данный модуль. Поэтому фирменный драйвер DW.SYS из комплекта RT-11 не будет работать с этим контроллером – требуется драйвер, написанный именно под ДВК. Их много разных вариантов, можно использовать любой из них. Но следует учесть, что максимальный объем диска, поддерживаемого файловой системой RT-11 – 32Мб, поэтому все 64Мб виртуального жесткого диска можно использовать только если драйвер умеет разбивать диск на несколько разделов. Я использовал драйвер, который называет себя “DW Handler V6.5, (c) D.S.C” - он умеет разбивать HDD на 4 логических диска.

Обратите внимание, что с образом жесткого диска будет корректно работать только тот драйвер, под управлением которого жесткий диск был разбит на разделы. В отличие от мира IBM PC, здесь нет стандартных форматов разбивки диска, и таблица разделов чаще всего хранится не на диске, а в самом драйвере. При использовании чужого драйвера (или родного, но с другой настройкой разделов) результат непредсказуем — от потери доступа к данным и невозможности загрузки ОС до полного разрушения информации на диске. Поскольку на имеющихся в сети образах дискет часто попадается драйвер DW.SYS, будьте внимательны при загрузке с таких дискет.

В отличие от RK11, этот контроллер не умеет работать через DMA – чтение/запись буферов производится программно, по одному слову. Поэтому контроллер DW существенно медленнее контроллера RK. В нашем стенде диск DW используется только как общая свалка файлов, а вся основная работа идет только c дисками RK.

Размер сектора HDD – 512 байт, как и у сд-карты. Как и в случае RK11, логический номер блока виртуального HDD соответствует абсолютному номер блока от начала образа диска. Тем не менее, если диск разбит на несколько разделов, то работать в simh можно только с самым первым разделом диска – остальные будут недоступны, ибо ДВКшный драйвер DW.SYS не будет работать в simh. Под simh надо монтировать образ как MSCP-диск DU:, не забыв указать format=raw.

### 10.3.3. Контроллер RX11/RX01 (DX)

Модуль реализует контроллер RX11 с подключенными к нему двумя дисководами RX01. Нашим аналогом такого дисковода является ГМД-70. Конечно, времена 8-дюймовых дискет прошли уже четверть века назад, и дискет таких уже, наверное, в природе почти не осталось. Но этот контроллер был встроен в плату МС1201.02, и для полноты картины я реализовал и его. Практической пользы от него совсем немного, в основном он нужен для работы с попадающимися в сети образами DХ-дискет.

Контроллер этот так же как и DW не умеет работать через DMA. Что еще хуже, он не поддерживает словный обмен по шине – передача данных в/из буфера происходит побайтно, что в два раза замедляет процесс загрузки-выгрузки буфера. Размер сектора этого диска всего 128 байт, и логический блок RT-11 соответствует 4 секторам дискеты. Общий размер диска – 251 Кб, но дорожка 0 не используется системой для хранения данных.

Для упрощения схемы и экономии ресурсов FPGA я не стал уплотнять данные, и образ диска DX на SD-карте занимает 4Мб. При этом данные хранятся только в младших байтах блока SD-карты, и используется только половина каждого блока (128 слов, каждое из которых хранит 1 байт данных и 1 байт мусора). Геометрия диска – 76 дорожек и 25 секторов на дорожку, причем сектора имеют номер 1-26, а сектора 0 не существует. Но поскольку под хранение номера цилиндра отводится 7 бит, а номера сектора – 5 бит, то образ, лежащий на SD-карте, содержит 128 цилиндров и 32 дорожки. Неиспользуемые поля данных могут содержать что угодно – контроллер эту информацию игнорирует.

Поскольку образ диска на SD-карте лежит в довольно извратном формате, для извлечения посекторных образов DX-дисков и записи их обратно на карту в утилиты sd-store и sd-extract введено преобразование форматов. Утилита sd-extract выдает на выходе образ, подходящий для монтирования в simh к устройству rx. Утилита sd-store записывает такой образ на карту в формате, пригодном для использования контроллером.

### 10.3.4. Контроллер НГМД MY

Это, наверное, самый сложный и развитый контроллер флоппи-дисков из всех, применявшихся в ДВК. Это чисто советская разработка, не имеющая DEC-аналога. В фирменной документации контроллер называется громоздкой аббревиатурой «ЩИ3.057.136», но мне не припоминается, чтобы кто-нибудь в реальной жизни его так называл, все его называют просто MY по имени обслуживающего его драйвера MY.SYS.

Контроллер рассчитан на работу с двумя дисководами НГМД-6022 или 6121. Каждый дисковод — двухдисковый, 6022 поддерживает 40 дорожек (емкость дискеты 400 Кб), а 6121 — 80 дорожек (800 Кб). Дисковод имеет 2 головки. Для передачи данных контроллер использует DMA, что дает производительность не хуже чем у RK11. Контроллер MY формирует полный 22-битный адрес в режиме DMA и не требует поддержки Unibus Mapping со стороны процессора.

Оригинальный контроллер может работать с секторами размером 256, 512 и 1024 байта. Формат конкретного сектора хранится в его заголовке, записанным на дорожку дискеты перед полем данных. Поскольку никакой служебной инофрмации в DSK-контейнере не имеется, то данная реализация контроллера поддерживает только 512-байтные сектора (10 секторов на дорожку), чего более чем достаточно для работы с образами дискет от ДВК. Также имеются следующие функциональные отличия от реального контроллера:

- Команды «форматирование» и «чтение заголовков» не поддерживаются. Для виртуального диска на SD-карте эти операции не имеют смысла.
- Команды «чтение с меткой» и «запись с меткой» работают как обычные команды чтения-записи. Метки хранить негде, и вообще мне как-то не встречался софт, использующий работу с помеченными секторами.
- Контроллер эмулирует только 80-дорожечный дисковод. При этом образы 40-дорожечных дискет, записанные на SD-карту, будут корректно читаться и записываться, но создать пустой образ 40-дорожечной дискеты средствами контроллера нельзя.

В остальном поведение контроллера более-менее соответствует его реальному прототипу. Проблем с чтением, записью файлов, созданием файловой системы и загрузкой ОС не выявлено.

### 10.3.5. Контроллер RK611/RK07 (DM)

Контроллер RK611 (советский аналог — СМ5408) никогда не применялся в составе персональных dec-совместимых ЭВМ. Такой контроллер с дисками RK06/RK07 устанавливался на большие СМ ЭВМ — мне такой встречался на СМ-1600 и СМ-1420. Тем не менее, я включил этот контроллер в состав проекта. Из официально поддерживаемых системой RT-11 дисков RK07 самый большой — 53790 блоков (более 26 Мбайт). Диск DW, который формально может быть размером 64 Мб, официально RT-11 не поддерживается и требует отдельной сборки драйвера (которых много разных и несовместимых друг с другом). Поскольку размер устройства в RT-11 не может превышать 32Мб, то 8 дисков размером 26 Мб каждый является хорошим подспорьем для хранения файлопомойки.

В операционных системах эти диски называются DM:. Они поддерживаются практически всеми операционными системами, что позволяет, наконец, начать развлекаться с ОС RSX-11M. Существует 2 типа дисков — RK06 и RK07. Они отличаются только числом дорожек — у RK06 их в два раза меньше. Поэтому я не стал реализовывать поддержку RK06 — смысла нет реализовывать устройство с меньшей емкостью. Таким образом, мы имеем контроллер RK611 и 8 подключенных к нему дисков RK07.

В оригинальном RK611 имеется мощная встроенная диагностическая подсистема, позволяющая программно эмулировать работу дискового устройства, и даже тактирование контроллера формировать программно. Я, естественно, не стал все это реализовывать — это увеличило бы объем схемы раза в 3 без улучшения функциональности — этот диагностический режим используют только тестовые программы. Кроме того, я не стал реализовывать команды чтения/записи заголовков. Это потребовало бы аппаратной реализации буфера SILO, что бессмысленно — функции SILO выполняет секторный буфер SDSPI. Таким образом, форматирование дисков DM невозможно (не будут работать утилиты FORMAT.SAV и FMT.TSK), но оно и не требуется — у нас ведь не магнитный диск, а SD-карта.

Поскольку размер сектора диска — 512 байт, образ диска отлично ложится на SD-карту. Можно без всяких изменений использовать образы дисков от эмулятора simh.

### 10.3.6. Контроллер RH70/RH-11 + RP06 (DB)

Этот контроллер может быть представлен в двух вариантах — RH-11 и RH-70. Какой из вариантов будет включен в схему, определяется наличием конфигурационной переменной massbus в файле config.v. Если переменная определена, то включается вариант RH-70, если не определена - то RH-11.

RH-11 рассчитан на подключение к общей шине UNIBUS/QBUS, умеет работать только с 18-битным адресом, и для работы в системах, имеющих больше 256М ОЗУ, требует наличие аппаратуры UNIBUS Mappng.

RH-70 представляет реализацию шины MASSBUS, появившейся в PDP11/70, и поддерживает полный 22-битный адрес. Формально, в режиме massbus контроллер можно включать только с процессорной платой PDP2011, однако в реальной жизни системы RSX-11M(+) и RSTS/E корректно работают с контроллером RH-70 в любой процессорной конфигурации.

К контроллеру подключены 8 дисков RP06. Это самые большие пакетные диски из всей номенклатуры дисковых устройств, они имеют емкость чуть больше 160 Мб. Советским аналогом таких дисков были устройства ЕС-5067. В прошлой жизни мне такие вживую не попадались, самые большие диски из виденных мной были ЕС-5066 емкостью 100 МБ (это аналоги DEC RP05 и IBM 3330). Пакет таких дисков состоял из 12 блинов, и требовал немалой физической силы для его установки на привод. В перестроечные годы из таких дисков делали неплохие дециметровые антенны.

В операционных системах диски RP06 называются DB:. RT-11 не имеет драйверов для этого типа дисков, поэтому в 16-битные конфигурации включать этот контроллер бессмысленно. Остальные ОС прекрасно поддерживают эти диски, а емкости в 160Мб вполне достаточно для размещения даже самой прожорливой ОС RSX-11M-PLUS вместе с библиотекой DECUS. При желании, можно доработать контроллер для подержки дисков RP03/04 (DP:), которые поддерживаются и в RT-11, но смысла в этом особого нет.

Поскольку размер сектора диска — 512 байт, образ диска отлично ложится на SD-карту. Можно без всяких изменений использовать образы дисков от эмулятора simh.

## 10.4. Ручная загрузка операционной системы с дисков

Не все платы содержат в себе загрузчики со всех имеющихся дисковых устройств. Полный набор загрузчиков есть только в мониторе 279 платы МС1201.02. Монитор платы МС1201.01 умеет загружать систему только с дисков DX, а платы МС1260 и МС1280 вообще не содержат ни одного загрузчика.

Для загрузки с большинства дисков можно использовать эмулятор пульта/загрузчик М9312. Тем не менее можно, как в старые добрые времена, произвести загрузку с любого диска с помощью команд монитора, работающих с ячейками памяти. Для устройств, работающих в режиме DMA, достаточно ввести код команды в регистр CSR и параметры команды в некоторые другие регистры. Для устройств, использующих программный обмен, в ОЗУ вводится программа начальной загрузки и запускается на выполнение.

### 10.4.1 Загрузка с RK

Команды для загрузки с диска RK0:

@177406/000000 177400^

177404/000200 5 <CR>

@0G

Первая команда записывает счетчик слов. 177400 — это 1 сектор диска. Вторая команда запускает процесс чтения. Сектор читается с диска и размещается в ОЗУ с адреса 0. Третья команда передает туда управление.

### 10.4.2. Загрузка с диска MY

Дисковый контроллер MY имеет специализированную команду для загрузки ОС. Процесс загрузки:

@172140/000040 37 <LF>

172142/000000 <CR>

@0G

Первая команда переводит контроллер в режим загрузки, вторая — устанавливает номер загрузочного дисковода — 0. После выполнения этих двух команд в память с адреса 0 считывается загрузочный сектор. Третья команда передает туда управление.

# 11. Контроллер ИРПС

Контроллеры ИРПС реализуют линию связи в последовательном коде со скоростью от 1200 до 115200 бит/с. В проект входят два контроллера:

ИРПС1, по адресу 177560, является консольным терминалом, через который монитор и операционная система общаются с пользователем. Этот порт обязательно должен присутствовать в схеме. В данном проекте порт состыкован с терминалом КСМ, но это не обязательно — можно вывести его сигналы наружу и пользоваться внешним терминалом. Скорость порта ИРПС1 управляется модулем КСМ (если он есть), начальная скорость задается параметром TERMINAL_SPEED в файле конфигурации.

ИРПС2, по адресу 176500 — это дополнительный последовательный интерфейс, который можно использовать для многих целей. Можно подключить к нему дополнительный терминал (RT-11 умеет работать в многотерминальной конфигурации). Можно подключить принтер с последовательным портом — это гораздо проще, чем делать интерфейсный адаптер для centronics. В этом случае принтер будет работать через устройство LS: в RT-11. Также можно его использовать для передачи файлов между ЭВМ. В данной схеме этот интерфейс использует нестандартный вектор прерывания — 330-334 вместо 300-304. Это связано с тем, что вектор 300 занят контроллером HDD DW:. При генерации системы следует указать правильный адрес вектора для устройств LS, XL и дополнительного терминала.

Скорость ИРПС2 фиксирована и определяется параметром UART2SPEED в файле конфигурации.

Есть возможность поменять местами оба порта с помощью переключателя sw_console. Тогда ИРПС2 подключается к модулю КСМ, сигналы ИРПС1 выводятся наружу, а скорость ИРПС1 фиксируется.

# 12. Контроллер ИРПР

Этот модуль реализует половину интерфейса ИРПР – только передатчик. Оригинальный ИРПР, стоящий на плате МС1201, умеет еще и вводить данные по 16-битной шине, но я ни разу не видел, чтобы хоть кто-то этим пользовался. У всех этот порт использовался исключительно для подключения принтеров. В RT-11 порт обслуживается драйвером LP:.

Поскольку настоящие ИРПР-принтеры на сегодня вымерли как динозавры, внешний интерфейс модуля реализует протокол centronics, что в принципе позволяет подключить любой писюшный принтер с параллельным интерфейсом. Естественно, придется делать интерфейсную схему, преобразующую уровни FPGA 3.3v в стандартный для centronics 5V, и буферирующую выходные линии данных. Я глубоко сомневаюсь, что кто-то реально захочет подключить физический принтер, но модуль вполне работоспособен и пусть остается в проекте. Кому он не нужен – могут выкинуть его из схемы и сэкономить примерно 50 ячеек FPGA.

# 13. Терминальная подсистема

Набор видеоконтроллеров ЭВМ ДВК-3 представляет собой забавную смесь совсем древних и более современных технологий. Набор состоит из двух плат – текстового терминала КСМ и графического видеоконтроллера КГД. В данном проекте реализованы оба контроллера.

В оригинальной ЭВМ для отображения информации использовался монохромный видеомонитор МС6105, а для ввода – клавиатура МС7004. В данном проекте для отображения используется любой монитор с VGA-входом, для ввода – клавиатура PS/2. Контроллер использует видеорежим 800*600*75 Гц. Этот режим в обязательном порядке поддерживают все мониторы, и ЭЛТ, и современные LCD, даже 4К мониторы могут такое отобразить. Если у монитора нет VGA-входа, можно воспользоваться переходником VGA2HDMI – проверено, работает. Для мониторов, некорректно размещающих на экране картинку (сдвиг изображения за левый край) предусмотрена коррекция фазы строчного синхроимпульса, задаваемая в файле конфигурации.

## 13.1. Контроллер КСМ

Этот контроллер представляет собой полноценный алфавитно-цифровой терминал, примерно совместимый с DEC VT52. Контроллер устанавливается в корзину ДВК в виде полноразмерной платы, однако не использует шину МПИ – от корзины он получает только питание. Передача данных производится через последовательный порт, подключаемый перемычкой к разъему ИРПС платы МС1201. Такой способ подключения консоли оператора к ЭВМ использовался еще во времена телетайпов и пишущих машинок, и более характерен для больших ЭВМ, а не персональных. Плата КСМ поддерживает скорости обмена от 75 до 9600 бод. В данном проекте диапазон поддерживаемых скоростей изменен – поддерживаются скорости от 1200 до 115200 бод. Скорости ниже 1200 не имеют практического смысла, а скорости выше 9600 оригинальный контроллер, видимо, не мог поддерживать в силу низкой производительности.

Экран терминала состоит из 25 строк по 80 символов. Верхняя строка – служебная, туда выводится информация о настройках и режимах работы терминала. Остальные 24 строки содержат пользовательские данные. Это соответствует терминалу DEC VT52 – там тоже использовался экран 80*24.

### 13.1.1. Внутреннее устройство контроллера

Контроллер представляет собой полноценное микропроцессорное устройство. Оригинальный КСМ был построен на процессоре К580ВМ80А и нескольких БИС из серии 580. В контроллере имеется блок статической рабочей памяти емкостью 1К, ПЗУ с управляющей программой емкостью 2К, ПЗУ знакогенератора емкостью 2К и видеопамять емкостью 16К, выполненная на микросхемах DRAM К565РУ6. Видеопамять используется довольно бездарно – половина ее предназначена только для хранения признака наличия курсора в данном знакоместе. В остальной части видеопамяти организован буфер для хранения 2 страниц текста – 48 строк по 80 символов.

В данном проекте контроллер построен на процессорном ядре К1801ВМ2 от уважаемого VSLAV. Писать управляющую программу под систему команд PDP-11, да еще и с EIS, гораздо приятнее и проще, чем под убогий Intel 8080. Кроме процессорного ядра, в контроллер входит модуль RAM размером 4К, предназначенный для хранения управляющей программы и рабочих переменных, модуль ROM размером 4К для хранения шрифтов и двухпортовый модуль RAM размером 2К в качестве видеопамяти. Таким образом, общий размер используемой памяти существенно сокращен по сравнению с оригиналом.

### 13.1.2. Поддерживаемые режимы работы

Управляющая программа полностью поддерживает систему команд оригинального контроллера, в том числе режим HOLD SCREEN и нестандартные ESC-последовательности “раздвижка строки” и “раздвижка страницы”.

Поддерживается псевдографика, причем она отличается от оригинальной псевдографики DEC VT52 как по форме знаков, так и по их кодам (100-137 вместо 137-177).

Реализован автономный режим работы (локальная петля), включающийся кнопкой F10. В этом режиме вводимые с клавиатуры символы и команды сразу попадают на экран, а обмен по интерфейсу не производится. Этот режим можно использовать для проверки и отладки клавиатуры и дисплейного модуля. Такой режим имеется и у оригинального КСМ.

Реализована поддержка звукового сигнала (пищалки), как во всех терминалах DEC, а также в 15ИЭ-00-013. На плате КСМ пищалки нет, но многие программы, и сама ОС RT-11, пользуются звуковым сигналом (передавая код 007), а реализовать эту возможность совсем нетрудно. В управляющую программу добавлена возможность отключения звука кнопкой F9. Ну а кому звук совсем не нужен – просто никуда не подключайте порт buzzer.

Полудуплексный режим (локальное эхо) не реализован в силу полной бесполезности. Не реализована и смена формата кадра последовательного интерфейса – передача всегда идет в режиме 8 бит без контроля четности.

Так же не реализован режим автоматического переноса курсора на следующую строку. Этого режима нет в DEC VT52, и практической пользы от него мало. Наоборот, в этом режиме нарушается работа полноэкранных текстовых редакторов и других подобных программ. Но, при желании, доделать этот режим в управляющую программу совсем не сложно.

### 13.1.3. Кодировка символов.

Терминал работает в 7-битном режиме. Формат кадра последовательного порта 8-битный (8-N-1), но старший бит байта игнорируется. Поддерживаются 2 набора кодировок символов — КОИ7 Н0/1, и КОИ7 Н2.

В режиме КОИ7 Н0 (режим по умолчанию) терминал работает со стандартной таблицей ASCII, в точности как оригинальный VT52. При этом отображаются малые и большие латинские буквы. Из кодировки Н0 (LAT) можно переключиться в кодировку Н1 (RUS), при этом терминал отображает малые русские буквы вместо больших латинских, и большие русские вместо малых латинских. На экране может отображаться смесь символов обоих кодировок. Переключение между кодировками производится управляющими кодами 016 и 017.

В режиме КОИ7 Н2 терминал отображает только большие латинские и русские буквы, при этом русские буквы занимают место малых латинских стандартной таблицы ASCII. Такой режим использовали терминалы, эксплуатировавшиеся совместно с СМ ЭВМ, например СМ7209 или ВТА-2000-3. Переключение в этот режим и обрано в режим Н0/Н1 производится клавишей F11.

В режиме Н2 эксплуатация оригинальных ОС от DEC невозможна, ибо все сообщения выводятся в искаженном виде (знаменитое IНЖАЛИД ДЕЖИЦЕ). Но в этом режиме корректно будут работать адаптированные в СССР системы (РАФОС, например), а также многие написанные в те времена программы, использовавшие русский язык, к примеру, экранный редактор USED.

Неотображаемые символы из диапазона 00-37, не распознанные терминалом как управляющие команды, отображаются на экране в виде символов латинского алфавита с кодом 100-137, мигающих с частотой около 3 Гц. Эта особенность отображения имеется не только в оригинальном модуле КСМ, но и во многих терминалах, например 15ИЭ-00-013 и СМ7209. В оригинальном DEC VT52 этой особенности нет, и все нераспознанные управляющие коды игнорируются.

### 13.1.4. Формат экрана

Дисплейный блок КСМ работает в стандартном для всех таких терминалов разрешении 24 пользовательских строки по 80 символов. Самая верхняя строка экрана терминала — служебная строка. В эту строку выводятся буквенные индикаторы режимов работы красного цвета:

LINE | режим связи с ЭВМ.
LOCAL | автономный режим (локальная петля)
CAPS | включен CAPS LOCK.
ALT | включен альтернативный режим дополнительной клавиатуры.
KOI7 | включена кодировка КОИ7 Н2
LAT | включена кодировка Н0
RUS | включена кодировка Н1
HOLD | включен режим HOLD SCREEN
WAIT | терминал ждет команды Scroll для продолжения вывода
MUTE | звуковой сигнал отключен.

У правого края служебной строки отображается текущая скорость последовательного интерфейса, а также время, прошедшее с момента включения дисплея.

Строка состояния данного контроллера отличается внешним видом от соответствующей строки оригинального КСМ. В оригинале ключевые слова выводились русскими буквами, причем часть аббревиатур была малопонятна (типа ЗВЫВ или ДКЛ). Некоторые параметры отображались в виде еще более малопонятных битовых полей. Я считаю, что, например, HOLD выглядит более понятно, чем ЗВЫВ. Однако, если кому-то хочется поностальгировать именно со старым внешним видом строки, то исправить надписи в тексте управляющей программы совсем несложно.

Со строки 2 начинается собственно экран терминала. Пользовательские данные выводятся зеленым цветом. Выглядит все это так:


Модуль поддерживает 2 типа курсора — подчеркивание и блок размером со знакоместо. Форма курсора переключается клавишей F8. В случае блочного курсора символ, под которым он стоит, отображается инвертированным. Также курсор может быть мигающим или немигающим, этот режим переключается клавишей F7.

Курсор отображается желтым цветом.

### 13.1.5. Клавиатура.

Алфавитно-цифровое поле клавиатуры используется для ввода букв, цифр и символов. Раскладка букв и символов во всех режимах примерно соответствует стандартной раскладке АТ-клавиатуры (qwerty/йцукен) с небольшими отличиями, которые легко выявить опытным путем (лень рисовать картинку с раскладкой).

Поле цифровой дополнительной клавиатуры используется в точности так же, как на клавиатуре МС7004 — в стандартном режиме вводятся цифры, в альтернативном — управляющие коды. Клавиши - и + соответствуют стрелкам вверх-вниз. Клавиши Numlock, /, * соответствуют кодам PF1, PF2 и PF3 стандартной клавиатуры VT52 (и расположены в тех же местах). Отсутствующие клавиши влево-вправо перенесены на поле управления курсором, там же продублированы стрелки вверх-вниз.

Управляющие клавиши АТ-клавиатуры имеют следующие значения:

F5 | Уменьшение на одну ступень скорости последовательного интерфейса
F6 | Увеличение на одну ступень скорости последовательного интерфейса
F7 | Переключение формы курсора - блок/подчеркивание
F8 | Включение-отключение мигания курсора
F9 | Отключение-включение звукового сигнала.
F10 | Переключение режимов Line (связь с ЭВМ)/Local (автономный режим)
F11 | Включение/отключение кодировки КОИ7 Н2 (все большие буквы)
L-ALT | Переключение кодировки RUS (Н1) / LAT (Н0)
R-ALT | Ввод кода LF (ПС) — переход на новую строку
Scrollock | Вывод следующей строки в режиме HoldScreen (с shift - вывод страницы)
PgDn | Раздвижка экрана вниз
PgUp | Раздвижка экрана вверх
Home | Установка курсора в начало экрана
Ins | Раздвижка строки вправо

### 13.1.6. Шрифт.

Оригинальный контроллер КСМ отображает знакоместа формата 8*8. В данной разработке знакоместа имеют размер 8*12, что позволяет использовать более четкий и разборчивый шрифт.

В схему входит ROM размером 4К (созданный в статической памяти FPGA) с образом шрифта знакогенератора. Исходные образы шрифта лежат в ksm-firmware/font/font-*.bin. Раскладка кодов символов внутри файла шрифта:

00-1f (000-037) большие латинские буквы (для индикации управляющих кодов)

20-3f (040-077) цифры и обычные символы

40-5f (100-137) большие латинские буквы

60-7f (140-177) малые латинские буквы

80-9f (200-237) псевдографика

a0-bf (240-277) не используется

c0-df (300-337) малые русские буквы

e0-ff (340-377) большие русские буквы

К проекту приложены 2 шрифтовых файла.

font-main.bin — основной шрифт 8*12, в основном выдранный из какого-то древнего досовского русификатора. Большинство линий символов имеет толщину в 2 пикселя, и шрифт смотрится вполне достойно на современных TFT-мониторах.

font-ksm.bin — шрифт 8*8, выдранный из знакогенератора платы КСМ (терминал 15ИЭ использует такой же шрифт). При использовании этого шрифта экран выглядит в точности таким же, как экран КСМ. Этот шрифт я приложил для ностальгирующих по старым временам, а также для наглядного сравнения корявых древних шрифтов с современными.

Вот пример изображения, формируемого шрифтом КСМ:


Используемый шрифт подключается к мегафункции fontrom. Выбор шрифта производится в файле конфигурации config.v.

Также в каталоге ksm-firmware/font лежат некоторые утилиты для обработки шрифтовых файлов:

font2mif — преобразователь файл шрифта (bin) в формат mif для загрузки в FPGA.

fontlist — выводит на экран изображения всех шрифтов указанного bin-файла

fontextract — извлекает шрифт указанного или всех символов из bin-файла

fontreplace — заменяет указанный символ в bin-файле.

Извлеченный из двоичного файла образ символа представляет собой текстовый прямоугольник размеров 8*12 знаков, в котором пикселя, формирующие изображение, обозначаются символом O, остальные — точкой:

..OOO...

.OO.OO..

OO...OO.

OO...OO.

OO...OO.

OOOOOOO.

OO...OO.

OO...OO.

OO...OO.

Такая форма удобна для редактирования изображения символа. 2 нижние строки лучше не использовать для размещения изображения, поскольку на этих строках размещается курсор в режиме подчеркивания.

## 13.2. Контроллер КГД

КГД (Контроллер Грфического Дисплея) — это монохромный графический контроллер, выводящий на экран изображение размером 400*286. Контроллер подключается прямо к шине МПИ и представлен на ней четырьмя регистрами. Такой подход является более современным по сравнению с подключением через последовательный порт.

КГД не является полноценным видеоконтроллером — он не умеет формировать полный набор видеосигналов, и работает только в паре с модулем КСМ. Поскольку КСМ формирует изображение 800*600, то каждый графический пиксель занимает 2 точки по горизонтали и вертикали. При этом в верхней части экрана остается темное поле высотой в 28 точек. Видеоданные, формируемые текстовым и графическим контроллером, могут выводиться на экран одновременно, накладываясь друг на друга. Также, используя регистры КГД, можно запретить вывод текстовой или графической информации.

Контроллер содержит в себе двухпортовую видеопамять размером 16К, которая доступна через регистры адреса и данных. Видеопамять формируется как мегафункция 2-port altsyncram из внутренней памяти FPGA. Это накладывает серьезные ограничения на тип применяемой FPGA — младшая из серии Cyclone 4 микросхема EP4CE6 не содержит достаточного количества памяти.

Обратите внимание, что контроллер КГД занимает адреса памяти, зарезервированные по стандарту DEC для одного из локальных последовательных портов DL11. Поэтому при загрузке ос RSTS/E, в процессе начальной инициализации оборудования, ошибочно отключается текстовый экран и изображение пропадает. Поэтому для конфигураций, предусматривающих загрузку RSTS/E, контроллер КГД надо исключить из схемы.

## 13.3. Аппаратные особенности терминальной подсистемы

Модуль КСМ умеет управлять звуковым сигналом по коду 007 — этой возможности не было в оригинальном контроллере. Сигнал передается через порт buzzer и принимает значение 1, когда надо включить звук. Его можно прямо подавать на пъезопищалку со встроенным генератором звука. Либо создать таймер/делитель на частоту около 400 Гц и использовать его для генерации звука. Или вообще обойтись без звука, как в настоящем КСМ.

На экране изображение имеет следующие цвета:

- Строка состояния — красный цвет
- Часы — фиолетовый цвет
- Данные пользователя — зеленый цвет
- Графика КГД — белый цвет
- Курсор — желтый цвет.

Если вы хотите получить полностью монохромное изображение, как на древних мониторах, то сигналы vgared, vgagreen, vgablue, выходящие из модуля КСМ, а также сигнал vgavideo, выходящий из модуля КГД, надо объединить по схеме ИЛИ и подать на все 3 видео-ЦАП, настроив эти ЦАП на формирование нужного оттенка изображения. Так можно получить черно-зеленое, черно-желтое, черно-белое и любое другое монохромное изображение.

Линии клавиатуры PS/2 Clock и Data должны быть подтянуты к питанию 3.3v. Для этого можно включить внутренние подтягивающие резисторы в FPGA (опция weak pull-up resistor в assignments editor), или подпаять внешние резисторы 2-5к между каждой линией и 3.3v, если их нет на вашей плате.

Некоторые мониторы и устройства видеозахвата некорректно отображают картинку — она частично уходит за левый край экрана. В этом случае следует произвести коррекцию фазы строчного синхроимпульса. В файле config.v надо раскомментировать строчку

`define hsync_shift 11'd27

и указать, на сколько пикселей следует сдвинуть картинку (в этом примере — 27).
