forth32/dvk-fpga/(threads)

Thread 5 (2025-03-24):

Странное поведение КСМ

merclangrat, 2025-03-24:
Установил проект на плату AX4010 со следующими настройками: mc1201_02, KSM (KGD выключен, он по-моему не влезает в эту плату), скорость 9600. Остальные настройки по умолчанию.

Включаю, всё работает в целом очень хорошо. Но есть особенности, которые, похоже, ещё и зависят от версии RT-11 и/или её настроек (SET TT). Пока не разобрался, хотел поделиться, не баг ли.

- не всегда работает переключение RUS/LAT левым Alt. В разных системах:  где-то просто пищит, где-то выдаёт '^N', где-то нужно нажать L-Alt, потом Backspace. В последнем случае при переключении обратно на латиницу, левый Alt выдаёт в консоль "чо" - L-Alt потом Backspace переключает.
- отображение тоже "глючит", иногда появляются мигающие буквы при выводе на экран (при этом в эмуляторе Патрона всё нормально, почему я и подумал, баг это или что), строки переносятся.

Например, Тетрис в версиях RT-11 5.7 и 5.4 выглядит по-разному - в 5.4 часть строк почему-то перенесено (прикладываю фото). Это один и тот же Тетрис, запущенный с одного и того же диска (первая картинка - RT-11 5.7, вторая - 5.4)

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

Если запустить игру XONIX, там вообще на экране что-то странное, и у меня две версии игры. Обе показывают странное, а одна ещё требует нажать LAT чтобы начать игру. Понятно, что случай довольно особый - но похоже никак невозможно нажать "LAT", если включен латинский регистр.

Я могу попробовать сам переназначить RUS/LAT на две разные кнопки, но если это переключение само по себе не всегда работает...

PS: Вообще, не всегда понятно, какие кнопки каким соответствуют, всё же нужна, наверное, картинка с клавиатурой...

Maverick-Shark, 2025-04-07:
Hi,
It seems a RT-11 5.4 issue, not a core issue.

Regards,
Shark
