forth32/dvk-fpga/board/tang/sipeed-tang-primer-pins.pdf

1

# Sipeed Tang Primer pins

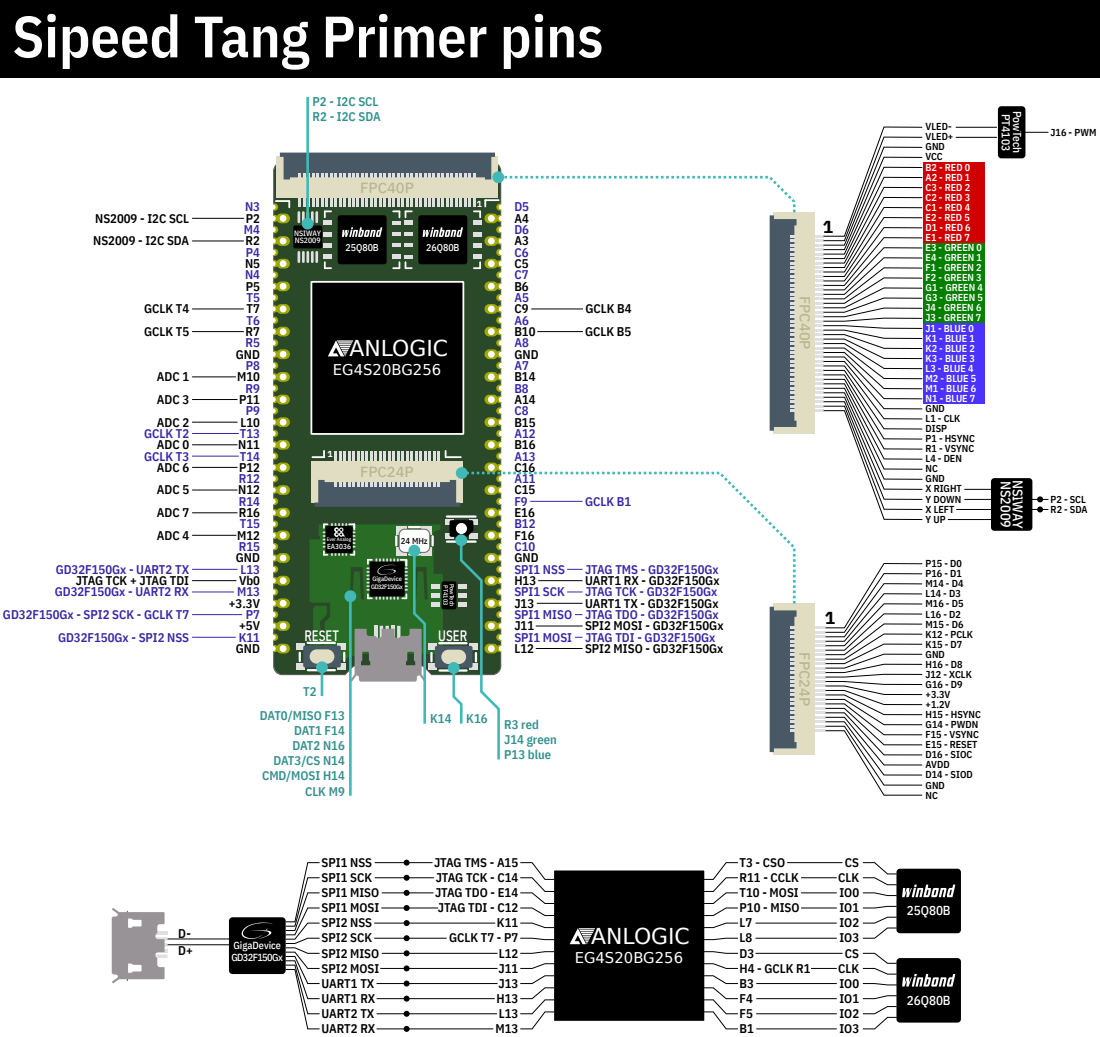
[picture p29: page 1]

GD32F150Gx - UART2 TX
JTAG TCK + JTAG TDI
GD32F150Gx - UART2 RX
