forth32/dvk-fpga/board/AX4010/config.v

//
//  Файл конфигурации собираемой ЭВМ
//
//======================================================================================================
// Тип процессорной платы. 
//
//  Плата       Процессор     ЭВМ              Эмулируемая шина
//-------------------------------------------------------------
//  МС1201.01   К1801ВМ1     ДВК-1,ДВК-2        QBUS/МПИ
//  МС1201.02   К1801ВМ2     ДВК-3              QBUS/МПИ
//  МС1201.04   К1801ВМ3     ДВК-4              QBUS/МПИ
//  МС1260      М2 (LSI-11)  Электроника-60     QBUS/МПИ
//  МС1280      М4 (LSI-11M)                    QBUS/МПИ
//  KDF-11      F-11         PDP11/23, Эл.60М   QBUS/МПИ
//  PDP2011     PDP-11/70    Электроника-79     UNIBUS
//------------------------------------------------------------
// Раскомментируйте одну из строк для включения выбранной платы в схему

//`define mc1201_01_board
`define mc1201_02_board
//`define mc1201_04_board
//`define mc1260_board
//`define mc1280_board
//`define kdf11_board
//`define pdp2011_board
 
//======================================================================================================
//
//  Включаемые компоненты
//  Закомментируйте ненужные модули, если хотите исключить их из схемы.
//

//`define KSM_module        // текстовый контроллер КСМ
//`define KGD_module        // графический контроллер КГД
//`define IRPS2_module      // второй последовательный порт ИРПС
//`define IRPR_module       // параллельный порт ИРПР
`define RK_module         // диск RK-11/RK05
`define DM_module         // диск RK611/RK07
//`define DB_module         // диск RH70/RP06
`define DX_module         // гибкий диск RX01
`define DW_module         // жесткий диск DW
`define MY_module         // гибкий диск двойной плотности MY
//`define bootrom_module    // монитор-загрузчик M9312. Для PDP11/70 включается в конфигурацию всегда.

//======================================================================================================
//
// Пзу пользователя в пространстве 140000-157776
// Доступно только для 16-битных процессорных модулей.
// Для включения ПЗУ в схему раскомментируйте строку, и укажите имя mif-файла, загружаемого в ПЗУ.
// Размер загружаемого дампа не должен превышать 8Кб
// Возможность включения ПЗУ доступна только для 16-битных процессоров без MMU.

//`define userrom "../../rom/013-basic.mif"
//`define userrom "../../rom/058-focal.mif"

//======================================================================================================
//
// Выбор файла шрифта текстового терминала КСМ
// Раскомментируйте одну из строк, указывающих на нужный файл шрифта

//   * font-main - шрифт 8*12, ровный и хорошо читаемый на LCD-мониторах
`define fontrom_file "../../ksm-firmware/font/font-main.mif"

//   * font-ksm - шрифт 8*8, из ПЗУ знакогенератора КСМ. С ним экран будет выглядеть в точности как оригинальный КСМ.
//     Шрифт довольно корявый, интересный только с исторической точки зрения.
//`define fontrom_file "../../ksm-firmware/font/font-ksm.mif"

//======================================================================================================
// Выбор начальных скоростей последовательных портов
// 
//  Индексы скорости последовательного порта:
//  0 - 1200
//  1 - 2400
//  2 - 4800
//  3 - 9600
//  4 - 19200
//  5 - 38400
//  6 - 57600
//  7 - 115200
// начальная скорость терминала
`define TERMINAL_SPEED 3'd5

// скорость второго последовательного интерфейса
`define UART2SPEED 3'd5

//======================================================================================================
//
//  Сдвиг фазы строчного синхроимпульса, выдаваемого модулем КСМ на VGA.
//  Если на вашем мониторе или устройстве видеозахвата картинка уезжает за левый край экрана, то раскомментируйте эту строку и
//  укажите величину горизонтального сдвига в пикселях.
//  Если картинка выглядит нормально без коррекции, оставьте строку закомметированной.
//
`define hsync_shift 11'd15

//======================================================================================================
//
// DRAM CAS Latency
// Этот параметр может принимать значение 2 или 3. 
// При CL=2 обмен идет быстрее, но не все типы DRAM его поддерживают.
`define cas_latency 2

//======================================================================================================
//
// Индивидуальные настройки процессорных плат
//--------------------------------------------------

`ifdef mc1280_board
//****************************************
//*   МС1280
//****************************************
 `define BOARD mc1280        // имя подключаемого модуля процессорной платы
 `define PLL_MUL 1           // умножитель PLL
 `define PLL_DIV 1           // делитель PLL
 
//-------------------------------------------------- 
`elsif mc1260_board
//****************************************
//*   МС1260
//****************************************
 `define BOARD mc1260        // имя подключаемого модуля процессорной платы
 `define PLL_MUL 1           // умножитель PLL
 `define PLL_DIV 1           // делитель PLL
 `define CPUSLOW 15          // число тактов, пропускаемых процессором в режиме замедления
 
//--------------------------------------------------
`elsif mc1201_02_board
//****************************************
//*   МС1201.02
//****************************************
 `define BOARD mc1201_02    // имя подключаемого модуля процессорной платы
 `define PLL_MUL 1         // умножитель PLL
 `define PLL_DIV 1         // делитель PLL
 `define CPUSLOW 15         // число тактов, пропускаемых процессором в режиме замедления
 `define timer_init 1'b1    // Начальное состояние таймера: 0 - выключен, 1 - включен

  // Выбор версии теневого ПЗУ - 055 или 279
  
  //`define mc1201_02_rom "../../rom/055.mif"
 `define mc1201_02_rom "../../rom/279.mif"

//--------------------------------------------------
`elsif mc1201_01_board
//****************************************
//*   МС1201.01
//****************************************
 `define BOARD mc1201_01     // имя подключаемого модуля процессорной платы
 `define PLL_MUL 3           // умножитель PLL
 `define PLL_DIV 2           // делитель PLL
 `define CPUSLOW 15          // число тактов, пропускаемых процессором в режиме замедления
 `define timer_init 1'b1     // Начальное состояние таймера: 0 - выключен, 1 - включен 

`elsif mc1201_04_board
//****************************************
//*  MC1201.04
//****************************************
 `define BOARD mc1201_04    // имя подключаемого модуля процессорной платы
 `define adr22              // признак 22-битной процессорной платы
 `define PLL_MUL 1          // умножитель PLL
 `define PLL_DIV 1          // делитель PLL
 `define CPUSLOW 125        // число тактов, пропускаемых процессором в режиме замедления
// `define massbus            // признак наличия шины MASSBUS с 22-битной адресацией DMA
 `define LTC                // признак наличия подсистемы управления таймером Line Time Clock (LTC)
 `define UMAP               // признак наличия подсистемы Unibus mapping.
                            // В режиме 256К ОЗУ подсистема отключается автоматически
// Определение объема памяти платы.
// Если закомментировать обе переменных, то включается полный объем 4М.
// `define RAM256              // ограничение объема памяти до 256К (18-битный адрес) МС1201.03
 `define RAM1M               // ограничение объема памяти до 1M (20-битный адрес) МС1201.04 
 
 // выбор версии теневого ПЗУ - 134 или 377. 
// `define vm3_rom "../../rom/377.mif"  
 `define vm3_rom "../../rom/134.mif" 
 
//--------------------------------------------------
`elsif kdf11_board
//****************************************
//*  KDF11
//****************************************
 `define BOARD kdf11         // имя подключаемого модуля процессорной платы
 `define adr22               // признак 22-битной процессорной платы
 `define PLL_MUL 1           // умножитель PLL
 `define PLL_DIV 1           // делитель PLL
 `define CPUSLOW 125         // число тактов, пропускаемых процессором в режиме замедления
 `define fpu_present 1'b1    // признак наличия FPP: 0-нет, 1-есть
// `define RAM256              // ограничение объема памяти до 256К (18-битный адрес)
 
//--------------------------------------------------
`elsif pdp2011_board
//****************************************
//*  PDP2011
//****************************************
 `define BOARD pdp2011       // имя подключаемого модуля процессорной платы
 `define adr22               // признак 22-битной процессорной платы
 `define PLL_MUL 1           // умножитель PLL
 `define PLL_DIV 1           // делитель PLL
 `define CPUSLOW 125         // число тактов, пропускаемых процессором в режиме замедления
 `define fpu_present 1'b1    // признак наличия FPP: 0-нет, 1-есть
 `define massbus             // признак наличия шины MASSBUS с 22-битной адресацией DMA
 
`endif  


//==========================================================================================================================================
//------------------ конец списка настраиваемых параметров -------------------------------------------------------------
//==========================================================================================================================================

// Далее подключаем файл вспомогательных определений
`include "../../hdl/common-config.v"
