forth32/dvk-fpga/hdl/pdp2011/wb_cpu2011.v

//======================================================================================================
//   Ядро процессора PDP2011
//======================================================================================================

// длительность программного сброса командой reset в тактах
`define initcycles_reset 100
// Время ожидание ответа шины в тактах
`define busdelay 50

module cpu2011 (

   // общая шина
   output reg [15:0] wbm_adr_o,   // шина виртуального адреса
   input      [15:0] wbm_dat_i,   // входная шина данных (bus -> cpu)
   output reg [15:0] wbm_dat_o,   // выходная шина данных (cpu -> bus)
   output reg        wbm_we_o,    // признак цикла записи на шину
   output reg [1:0]  wbm_sel_o,   // выбор байтов для записи
   output reg        wbm_stb_o,   // строб обмена по шине
   input             wbm_ack_i,   // подтверждение транзакции (REPLY)
   input clk,                     // тактовый синхросигнал
   input reset,                   // сброс процессора
   output reg init,               // выход сброса для всей периферии на шине

   // Информация от типе цикла шины   
   output reg cp,                 // 1 - обмен по шине происходит в предыдущем режиме процессора
   output reg ifetch,             // признак выборки инструкции
   output reg id,                 // 1 - обращение к данным

   // Векторные прерывания
   input [7:4]       virq,       // линии запросов прерываний
   input [8:0]       vector,     // ввод адреса вектора
   output reg [7:4]  vstb,       // строб запроса вектора 
   input             vack,       // подтверждение приема вектора
   input[15:0]       pirq,       // Регистр PIRQ, формирователь программных прерываний
    
    // линии прерываний от MMU
   input mmutrap,                // запрос прерывания от MMU по окончании обработки текущей инструкции
   output reg ack_mmutrap,       // подтверждение прерывания от MMU
   input mmuabort,               // запрос от MMU на отмену обработки текущей инструкции
   output reg ack_mmuabort,      // подтверждение отмены обработки инструкции

   // Индикаторы состояния процессора 
   output reg iwait,             // 1 - процессор стоит на команде wait и ждет прерывания
   output reg run,               // индикатор работы процессора
   
   // Сигналы ручного управления
   input  sw_cont,               // кнопка выхода из состояния HALT
   input cpuslow,                // Включение замедленного режима процессора
   
   // DMA
   input npr,                    // запрос DMA
   output reg npg,               // подтверждение DMA
   output oddabort,              // признак словного обращения по нечетному адресу
   
   // Флаги ошибок
   output reg illhalt,           // признак недопустимости инструкции HALT в текущем режиме процессора
   output     bus_timeout,       // флаг таймаута шины
   output ysv,                   // желтое состояние стека
   output rsv,                   // красное состояние стека
   input[15:0] cpu_stack_limit,  // значение нижней границы стека 
   output reg sr0_ic,            // sr0/mmr0 - флаг завершения декодирования инструкции
   output[15:0] sr1,             // sr1/mmr1 - адрес текущей инструкции
   output reg[15:0] sr2,         // sr2/MMR2 - информация об автоинкременте и автодекременте
   output reg dstfreference,     // 1 - финальная адресация приемника
   output dw8,                   // признак байтового обмена 
   
   // PSW
   input[15:0] psw_in,           // Ввод PSW , записываемого под адресу 177776
   input psw_in_we_even,         // Разрешение записи младшего байта PSW
   input psw_in_we_odd,          // Разрешение записи старшего байта PSW
   output[15:0] psw_out,         // Вывод PSW , читаемого под адресу 177776

   // конфигурация 
   input fpu_enable,             // Признак наличия FPU в схеме процессора
   input[15:0] startup_adr,      // Адрес старта по сбросу
   input[15:0] startup_psw       // Стартовое PSW
);
//*********************************************************
//*   Состояния секвенсора
//*********************************************************
parameter[7:0] sq_init = 0 ;
parameter[7:0] sq_ifetch = 1 ;
parameter[7:0] sq_idecode = 2 ;
parameter[7:0] sq_src0 = 3 ;
parameter[7:0] sq_src1 = 4 ;
parameter[7:0] sq_src1l = 5 ;
parameter[7:0] sq_src2 = 6 ;
parameter[7:0] sq_src2l = 7 ;
parameter[7:0] sq_src2w = 8 ;
parameter[7:0] sq_src3 = 9 ;
parameter[7:0] sq_src3l = 10 ;
parameter[7:0] sq_src3a = 11 ;
parameter[7:0] sq_src3al = 12 ;
parameter[7:0] sq_src4 = 13 ;
parameter[7:0] sq_src4l = 14 ;
parameter[7:0] sq_src4w = 15 ;
parameter[7:0] sq_src5 = 16 ;
parameter[7:0] sq_src5l = 17 ;
parameter[7:0] sq_src5a = 18 ;
parameter[7:0] sq_src5al = 19 ;
parameter[7:0] sq_src6 = 20 ;
parameter[7:0] sq_src6l = 21 ;
parameter[7:0] sq_src6a = 22 ;
parameter[7:0] sq_src6al = 23 ;
parameter[7:0] sq_src7 = 24 ;
parameter[7:0] sq_src7l = 25 ;
parameter[7:0] sq_src7a = 26 ;
parameter[7:0] sq_src7al = 27 ;
parameter[7:0] sq_src7b = 28 ;
parameter[7:0] sq_src7bl = 29 ;
parameter[7:0] sq_dst0 = 30 ;
parameter[7:0] sq_dst1 = 31 ;
parameter[7:0] sq_dst1l = 32 ;
parameter[7:0] sq_dst2 = 33 ;
parameter[7:0] sq_dst2l = 34 ;
parameter[7:0] sq_dst3 = 35 ;
parameter[7:0] sq_dst3l = 36 ;
parameter[7:0] sq_dst3a = 37 ;
parameter[7:0] sq_dst3al = 38 ;
parameter[7:0] sq_dst4 = 39 ;
parameter[7:0] sq_dst4l = 40 ;
parameter[7:0] sq_dst5 = 41 ;
parameter[7:0] sq_dst5l = 42 ;
parameter[7:0] sq_dst5a = 43 ;
parameter[7:0] sq_dst5al = 44 ;
parameter[7:0] sq_dst6 = 45 ;
parameter[7:0] sq_dst6l = 46 ;
parameter[7:0] sq_dst6a = 47 ;
parameter[7:0] sq_dst6al = 48 ;
parameter[7:0] sq_dst7 = 49 ;
parameter[7:0] sq_dst7l = 50 ;
parameter[7:0] sq_dst7a = 51 ;
parameter[7:0] sq_dst7al = 52 ;
parameter[7:0] sq_dst7b = 53 ;
parameter[7:0] sq_dst7bl = 54 ;
parameter[7:0] sq_sob = 55 ;
parameter[7:0] sq_jmp = 56 ;
parameter[7:0] sq_jsr = 57 ;
parameter[7:0] sq_jsra = 58 ;
parameter[7:0] sq_jsrb = 59 ;
parameter[7:0] sq_jsrc = 60 ;
parameter[7:0] sq_rts = 61 ;
parameter[7:0] sq_rtsa = 62 ;
parameter[7:0] sq_rtsal = 63 ;
parameter[7:0] sq_mark = 64 ;
parameter[7:0] sq_marka = 65 ;
parameter[7:0] sq_markb = 66 ;
parameter[7:0] sq_markbl = 67 ;
parameter[7:0] sq_mfp = 68 ;
parameter[7:0] sq_mfpa = 69 ;
parameter[7:0] sq_mtp = 70 ;
parameter[7:0] sq_mtpl = 71 ;
parameter[7:0] sq_mtpa = 72 ;
parameter[7:0] sq_dopr = 73 ;
parameter[7:0] sq_dopra = 74 ;
parameter[7:0] sq_doprb = 75 ;
parameter[7:0] sq_mul = 76 ;
parameter[7:0] sq_mula = 77 ;
parameter[7:0] sq_mulb = 78 ;
parameter[7:0] sq_div = 79 ;
parameter[7:0] sq_diva = 80 ;
parameter[7:0] sq_divb = 81 ;
parameter[7:0] sq_ash = 82 ;
parameter[7:0] sq_ashb = 83 ;
parameter[7:0] sq_ashc = 84 ;
parameter[7:0] sq_ashd = 85 ;
parameter[7:0] sq_ashe = 86 ;
parameter[7:0] sq_xor = 87 ;
parameter[7:0] sq_ldfps = 88 ;
parameter[7:0] sq_halt = 89 ;
parameter[7:0] sq_fptrap = 90 ;
parameter[7:0] sq_fpao = 91 ;
parameter[7:0] sq_fpso2 = 92 ;
parameter[7:0] sq_fpwr = 93 ;
parameter[7:0] sq_fpwr1 = 94 ;
parameter[7:0] sq_fpwr2 = 95 ;
parameter[7:0] sq_fpd0 = 96 ;
parameter[7:0] sq_fpir1 = 97 ;
parameter[7:0] sq_fpir2 = 98 ;
parameter[7:0] sq_fpiwr = 99 ;
parameter[7:0] sq_fpiww = 100 ;
parameter[7:0] sq_fpiw1 = 101 ;
parameter[7:0] sq_fpiw2 = 102 ;
parameter[7:0] sq_fpr1 = 103 ;
parameter[7:0] sq_fpr2 = 104 ;
parameter[7:0] sq_fpr3 = 105 ;
parameter[7:0] sq_fpr4 = 106 ;
parameter[7:0] sq_fpww = 107 ;
parameter[7:0] sq_fpw1 = 108 ;
parameter[7:0] sq_fpw2 = 109 ;
parameter[7:0] sq_fpw3 = 110 ;
parameter[7:0] sq_fpw4 = 111 ;
parameter[7:0] sq_fprun = 112 ;
parameter[7:0] sq_fprunao = 113 ;
parameter[7:0] sq_tstset = 114 ;
parameter[7:0] sq_wrtlck = 115 ;
parameter[7:0] sq_wrtlcka = 116 ;
parameter[7:0] sq_rsv = 117 ;
parameter[7:0] sq_trap = 118 ;
parameter[7:0] sq_trapa = 119 ;
parameter[7:0] sq_trapal = 120 ;
parameter[7:0] sq_trapb = 121 ;
parameter[7:0] sq_trapc = 122 ;
parameter[7:0] sq_trapw = 123 ;
parameter[7:0] sq_trapd = 124 ;
parameter[7:0] sq_trape = 125 ;
parameter[7:0] sq_trapf = 126 ;
parameter[7:0] sq_trapfl = 127 ;
parameter[7:0] sq_rti = 128 ;
parameter[7:0] sq_rtia = 129 ;
parameter[7:0] sq_rtial = 130 ;
parameter[7:0] sq_rtib = 131 ;
parameter[7:0] sq_rtibl = 132 ;
parameter[7:0] sq_illegalop = 133 ;
parameter[7:0] sq_mmuabort = 134 ;
parameter[7:0] sq_mmutrap = 135 ;
parameter[7:0] sq_stststore = 136 ;
parameter[7:0] sq_edf = 137 ;
parameter[7:0] sq_virq7 = 138 ;
parameter[7:0] sq_virq6 = 139 ;
parameter[7:0] sq_virq5 = 140 ;
parameter[7:0] sq_virq4 = 141 ;
parameter[7:0] sq_store_alu_p = 142 ;
parameter[7:0] sq_store_alu_w = 143 ;
parameter[7:0] sq_store_alu_r = 144 ;
parameter[7:0] sq_dma = 145 ;
parameter[7:0] sq_wbread = 146 ;
parameter[7:0] sq_wbread_wait = 147 ;
parameter[7:0] sq_wbwrite = 148 ;
parameter[7:0] sq_wbwrite_wait = 149 ;
parameter[7:0] sq_nxmabort = 150 ;
parameter[7:0] sq_fpir1l = 151;
parameter[7:0] sq_fpir2l = 152;
parameter[7:0] sq_fpr1l = 153;
parameter[7:0] sq_fpr2l = 154;
parameter[7:0] sq_fpr3l = 155;
parameter[7:0] sq_fpr4l = 156;
parameter[7:0] sq_fpiw1l = 157;
parameter[7:0] sq_fpw1l = 158;
parameter[7:0] sq_fpw2l = 159;
parameter[7:0] sq_fpw3l = 160;
parameter[7:0] sq_rsv1 = 161;

reg [15:0] datain;

// Регистры  состояния секвенсера   
reg[7:0] state;      // текущее состояние
reg[7:0] nextstate;  // состояние для возврата из субблока   
reg[7:0] dst_mode_processor; // обработчик режима адресации приемника
reg[7:0] src_mode_processor; // обработчик режима адресации источника


reg[15:0] ir;       // хранит очередную инструкцию, выбранную декодером из памяти
reg[15:0] ir_addr;  // адрес выбранной декодером инструкции
   
reg trap_flag;   
   
// Флажки характеристик декодируемой инструкции   

reg ir_sop;      // однооперандная инструкция
reg ir_dop;      // двухоперандная инструкция
reg ir_jmp;      // инструкция JMP
reg ir_jsr;      // инструкция JSR
reg ir_mfpi;     // инструкция MFPI
reg ir_mfpd;     // инструкция MFPD 
wire ir_mf;      // MFPI/MFPD
reg ir_mtpi;     // инструкция MTPI 
reg ir_mtpd;     // инструкция MTPD 
wire ir_mt;      // MTPI/MTPD
reg ir_rtt;      // инструкция RTT
reg ir_dopr;     // инструкция регистр-регистр
reg ir_fpsop1;   // однооперандная инструкция FPU типа 1
reg ir_fpsop2;   // однооперандная инструкция FPU типа 2 
reg ir_fpao;     // инструкция FPU  аккумулятор-операнд
reg ir_facdst;   // инструкция FPU  аккумулятор-операнд с передачией в CPU
reg ir_facsrc;   // инструкция FPU  аккумулятор-операнд с передачией из CPU 
reg ir_facfdst;  // инструкция FPU  аккумулятор-операнд с передачией в FPU
reg ir_facfsrc;  // инструкция FPU  аккумулятор-операнд с передачией из FPU 
wire ir_fpma48; 
reg ir_fpmai;    // инструкция FPU, формат данных- integer
reg ir_fpmaf;    // инструкция FPU, формат данных- float
reg ir_byte;     // признак байтового результата АЛУ
reg ir_store;    // Разрешение от АЛУ на запись результата
wire ir_srcr7;   // Истоник - регистр РС
wire ir_dstr7;   // Приемник - регистр РС
wire ir_dstm2r7; // Приемник или единстрвенный операнд - (R7)+
reg v_sop; 
reg v_dop; 
reg v_jmp; 
reg v_jsr; 
reg v_mfpi; 
reg v_mfpd; 
reg v_mtpi; 
reg v_mtpd; 
reg v_dopr; 
reg v_fpsop1; 
reg v_fpsop2; 
reg v_fpao; 

// хранилище вектора текущего прерывания
reg[8:0] trap_vector; 

// psw
reg[15:0] temp_psw; 
reg[15:0] psw; 
wire[15:8] pswmf; 
reg[15:0] psw_delayedupdate; 
reg psw_delayedupdate_even; 
reg psw_delayedupdate_odd; 
reg spl_psw_update;
// pc
reg[15:0] r7; 

// Интерфейс к АЛУ
reg[15:0] alu_input;             // вход АЛУ для однооперандных инструкций или второй операнд двухоперандных инструкций
reg[15:0] alus_input;            // вход АЛУ для первого операнда двухоперандных инструкций
reg[15:0] alut_input;            // вход EIS АЛУ для второго операнда
reg[15:0] alu_output;            // выход АЛУ - результат обработки
wire[15:0] alu_output_signext;   // байтовый выход АЛУ с расширенным на старший байт знаком
reg[3:0] alu_psw;                // обновленное PSW после обработки операндов в АЛУ

// Шины регистрового файла
reg[5:0] rbus_waddr;           // адрес записи в регистровом файле
reg[15:0] rbus_d;              // входная шина регистрового файла   
wire[15:0] rbus_o;             // выходная шина регистрового файла
reg rbus_we;                   // разрешение записи в регистровый файл
reg[2:0] rbus_ix;              // регистр-источник текущей инструкции
reg[1:0] rbus_cpu_mode;        // текущий режим работы процессора
reg rbus_cpu_psw11;            // выбор набора регистров
wire[15:0] rbus_data;          // содержимое выбранного регистра
wire[15:0] rbus_data_m2; 
wire[15:0] rbus_data_mv;       // Содержимое регистра после автодекремента --
wire[15:0] rbus_data_pv;       // Содержимое регистра после автоинкремента ++
reg rsv_flag;
reg [15:0] prev_sp;

// SR1/MMR1
wire[7:0] sr1_dst;    // описатель приемника
wire[7:0] sr1_src;    // описатель источника
reg[4:0] sr1_dstd;    // размер автоинкремента приемника       
reg[4:0] sr1_srcd;    // размер автоинкремента источника
wire[4:0] sr1_p2;     // инкремент +2
wire[4:0] sr1_pv;     // инкремент, специфичный для инструкции
wire[4:0] sr1_m2;     // декремент -2
wire[4:0] sr1_mv;     // декремент, специфичный для инструкции

// Флаги текущего/предыдущего режима
wire cp_req; 
wire cp_mf; 
wire cp_mt; 
reg cp_latch;

// Признаки режима инструкций/данных
wire id_current;
reg id_latch;

// Элементы формирователя игнала чтения rd
wire rd_select;    // Сигнал RD, определяемый состоянием секвенсера
wire rs_mt;        // сигналы подавления чтения
wire rs_jj; 

// Вычисляемые адреса операндов
reg[15:0] dest_addr;        // вычисленный адрес записи результата
reg[15:0] addr_indirect;    // вычисленный адрес при косвенной адресации
reg finalreference; 

// Регистры АЛУ EIS-инструкций
reg[15:0] eis_output; 
reg[15:0] eis_output32; 
reg[15:0] eis_temp; 
reg[31:0] eis_temp1; 
reg[31:0] eis_temp2; 
reg[4:0] eis_sequencer; 
reg[3:0] eis_psw; 
reg eis_flag1; 
reg eis_flag2; 
integer initcycles; 

// Сигналы контроля уровня стека
reg yellow_stack_event; 
reg yellow_stack_latch; 
wire yellow_stack_event_trigger; 
wire yellow_stack_immediate_states; 
reg yellow_trap_inhibit; 
reg red_stack_trap; 
wire red_stack_trap_trigger; 
wire red_stack_immediate_states; 
wire stack_check_states; 

reg trap_force_kernel;

// Регистры АЛУ FPP
reg[15:0] fps; 
reg[3:0] fec; 
reg[15:0] fea; 

reg[63:0] falu_input; 
reg[63:0] falus_input; 
reg[63:0] falu_output; 
reg[63:0] falu_output2; 
reg[3:0] falu_fps; 
reg falu_load; 
reg falu_done; 
reg falu_flag1; 
reg[3:0] falu_fsm; 
reg[9:0] falu_ccw; 
reg[7:0] falu_state; 
reg[58:0] falu_work1; 
reg[58:0] falu_work2; 
reg falu_pending_clear; 
reg falu_pending_fic; 
reg falu_pending_fiu; 
reg falu_pending_fiv; 
reg falu_pending_divz; 

// Состоояния АЛУ плавающей точки
parameter[3:0] falu_idle = 0; 
parameter[3:0] falu_align = 1; 
parameter[3:0] falu_mult = 2; 
parameter[3:0] falu_div = 3; 
parameter[3:0] falu_addsub = 4; 
parameter[3:0] falu_shift = 5; 
parameter[3:0] falu_shift2 = 6; 
parameter[3:0] falu_shifte = 7; 
parameter[3:0] falu_norm = 8; 
parameter[3:0] falu_rt = 9; 
parameter[3:0] falu_rtc = 10; 
parameter[3:0] falu_sep = 11; 
parameter[3:0] falu_sep2 = 12; 
parameter[3:0] falu_sep3 = 13; 
parameter[3:0] falu_zres = 14; 
parameter[3:0] falu_res = 15; 

// Регистры блока FPU
reg[2:0] fbus_raddr; 
reg[2:0] fbus_waddr; 
reg[63:0] fbus_d; 
wire[63:0] fbus_o; 
reg fbus_we; 
reg fbus_fd; 

// флаги таймаута шины
reg nxmabort;
reg nxmabort_pend;
reg [5:0] bus_timer;  // таймер шинных транзакций

assign bus_timeout=nxmabort;

// Таймер замедления процессора
reg [6:0] cpudelay;
   
//********************************************************
//*   Блок регистров процессора , шина RBUS
//********************************************************
   cpuregs cpuregs0 (
      //       режим cpu      набор регистров   #регистра
      .raddr({rbus_cpu_mode, rbus_cpu_psw11,    rbus_ix}),  // адрес чтения 
      .waddr(rbus_waddr),  // адрес записи
      .d(rbus_d),          // данные для записи
      .o(rbus_o),          // выходные данные чтения
      .we(rbus_we),        // разрешение записи
      .clk(clk)            // тактовый сигнал
   ); 
   
//********************************************************
//*   Блок регистров FPU, шина FBUS
//********************************************************
   fpuregs fpuregs0 (
      .raddr(fbus_raddr),  // адрес чтения 
      .waddr(fbus_waddr),  // адрес записи
      .d(fbus_d),          // входная шина данных
      .o(fbus_o),          // выходная шина данных
      .fpmode(fbus_fd), 
      .we(fbus_we), 
      .clk(clk)
   );
   
//********************************************************
//*    Подсистема контроля границы стека
//********************************************************
   
//  Состояния, в которых желтая граница стека возникает по адресам 0-376
assign yellow_stack_immediate_states = (state == sq_dst4)     // -(R)
                                     | (state == sq_jsra)     // Запись в стек при вызове подпрограммы
                                     | (state == sq_trapc)    // Запись PSW при прерывании
                                     | (state == sq_trapd);   // Запись PC при прерывании

//  Состояния, в которых производится проверка желтой и красной границы через регистр SL
assign stack_check_states =             (state == sq_dst1)     // (R)
                                      | (state == sq_dst2)     // (R)+
                                      | (state == sq_dst4)     // -(R)
                                      | (state == sq_jsra)     //  JSR - запись SP в стек
                                      | (state == sq_trapc)    // прерывание, запись PSW в стек
                                      | (state == sq_trapd) ;  // прерывание, запись PC в стек

// Детектор желтой границы стека                                                                  
assign yellow_stack_event_trigger = 
            (rbus_ix == 3'b110)                    // адресация через SP 
            & (psw[15:14] == 2'b00)                // режим KERNEL
            & (yellow_trap_inhibit == 1'b0)        // предотвращение повторного прерывания
            & (red_stack_trap == 1'b0)             // красная граница не достигнута
            & (red_stack_trap_trigger == 1'b0) 
            &(
            // Стек попадает в область 0-377
             (yellow_stack_immediate_states & (rbus_data_m2[15:8] == 8'b00000000))    
            // Стек опустился ниже верхнего значения границы
          |  (stack_check_states & ({cpu_stack_limit[15:8], 8'b11111110} > rbus_data_m2)));
            
assign ysv = yellow_stack_event_trigger ;

// Состояния, в которых детектор срабатываеит при ошибках нечетной адресации или таймауте шины
// В этих состояниях регистр SL не учитывается и прерывание происходит всегда
assign red_stack_immediate_states = (state == sq_trapc)    // прерывание, запись PSW в стек
                                  | (state == sq_trapd);   // прерывание, запись PС в стек
                                              
assign red_stack_trap_trigger = 
                                // Ошибки записи в стек в момент входа в прерывание 
                                (red_stack_immediate_states & (oddabort | nxmabort)) |
                                // Уход стека ниже нижней границы SL
                                (stack_check_states   
                                & rbus_ix == 3'b110            // SP
                                & psw[15:14] == 2'b00          // KERNEL
                                & red_stack_trap == 1'b0       // прерывание еще не произошло
                                &  (oddabort | nxmabort |              // ошибки таймаута шины или нечетной адресации
                                   ({cpu_stack_limit[15:8], 8'b11100000} > (rbus_data_m2)) |   // стек уехал ниже нижней границы, определяемой SL
                                   (rbus_data[15:1] == 15'o77777)));   // стек уехал на страницу ввода-вывода

assign rsv = red_stack_trap_trigger ;

//-------------------------------------------------------------
// dw8 : признак байтового доступа к шине
assign dw8 = finalreference & ir_byte;
                     
// флаг CP - адрес относится к предыдущему режиму
  // mfpi/mfpd - чтение
assign cp_mf = finalreference & (state != sq_store_alu_w) & (ir_mfpi | ir_mfpd) ;
  // mtpi/mtpd - запись
assign cp_mt = (state == sq_store_alu_w) & (ir_mtpi | ir_mtpd );
assign cp_req = cp_mf | cp_mt ;

// rs - подавление строба чтения в некоторых состояниях:
assign rs_mt = ((ir_mtpi == 1'b1 | ir_mtpd == 1'b1) 
               & finalreference == 1'b1 
               & state != sq_store_alu_w)    // не в состоянии store_alu_w
               ? 1'b1 : 1'b0 ;
assign rs_jj = ((ir_jmp == 1'b1 | ir_jsr == 1'b1) // подавление в командах переходов
               & finalreference == 1'b1) 
               ? 1'b1 : 1'b0 ;
               
wire rd_inhibit = (rs_mt | rs_jj // подавление RD сигналами rs
                   | iwait);     // также в состоянии wait чтение не производится

// Формирования флагов - индикаторов использования R7 в качестве операнда
assign ir_dstm2r7 = (ir[5:0] == 6'b010111) ? 1'b0 : 1'b1 ;  // (R7)+
assign ir_srcr7 = (ir[8:6] == 3'b111) ? 1'b0 : 1'b1 ;       // R7 - источник
assign ir_dstr7 = (ir[2:0] == 3'b111) ? 1'b0 : 1'b1 ;       // R7 - приемник

// Формирование прзнака I/D текущей инструкции
assign id_current = (state == sq_idecode) ? 1'b0 : 
                   (state == sq_ifetch) ? 1'b0 : 
                   (state == sq_dst1) ? ir_dstr7 : 
                   (state == sq_dst2) ? ir_dstr7 : 
                   (state == sq_dst3) ? ir_dstr7 : 
                   (state == sq_dst3a) ? 1'b1 : 
                   (state == sq_dst4) ? ir_dstr7 : 
                   (state == sq_dst5) ? ir_dstr7 : 
                   (state == sq_dst5a) ? 1'b1 : 
                   (state == sq_dst6) ? 1'b0 : 
                   (state == sq_dst6a) ? 1'b1 : 
                   (state == sq_dst7) ? 1'b0 : 
                   (state == sq_dst7a) ? 1'b1 : 
                   (state == sq_dst7b) ? 1'b1 : 
                   (state == sq_src1) ? ir_srcr7 : 
                   (state == sq_src2) ? ir_srcr7 : 
                   (state == sq_src3) ? ir_srcr7 : 
                   (state == sq_src3a) ? 1'b1 : 
                   (state == sq_src4) ? ir_srcr7 : 
                   (state == sq_src5) ? ir_srcr7 : 
                   (state == sq_src5a) ? 1'b1 : 
                   (state == sq_src6) ? 1'b0 : 
                   (state == sq_src6a) ? 1'b1 : 
                   (state == sq_src7) ? 1'b0 : 
                   (state == sq_src7a) ? 1'b1 : 
                   (state == sq_src7b) ? 1'b1 : 
                   (state == sq_fpir1) ? ir_dstm2r7 : 
                   (state == sq_fpir2) ? 1'b1 : 
                   (state == sq_fpiw1) ? ir_dstm2r7 : 
                   (state == sq_fpiw2) ? 1'b1 : 
                   (state == sq_fpr1) ? ir_dstm2r7 : 
                   (state == sq_fpr2 || state == sq_fpr3 || state == sq_fpr4) ? 1'b1 : 
                   (state == sq_fpw1) ? ir_dstm2r7 : 
                   (state == sq_fpw2 || state == sq_fpw3 || state == sq_fpw4) ? 1'b1 : 
                   (state == sq_stststore) ? 1'b1 : 
                   (state == sq_mfpa) ? 1'b1 : 
                   (state == sq_mtp) ? 1'b1 : 
                   (state == sq_trapa) ? 1'b1 : 
                   (state == sq_trapb) ? 1'b1 : 
                   (state == sq_trapc) ? 1'b1 : 
                   (state == sq_trapw) ? 1'b1 : 
                   (state == sq_trapd) ? 1'b1 : 
                   (state == sq_trapf) ? 1'b1 : 
                   (state == sq_jsrb) ? 1'b1 : 
                   (state == sq_rtsa) ? 1'b1 : 
                   (state == sq_mark) ? 1'b0 : 
                   (state == sq_marka) ? 1'b0 : 
                   (state == sq_rtia) ? 1'b1 : 
                   (state == sq_rtib) ? 1'b1 : 
                   (state == sq_store_alu_w) ? ir_dstm2r7 : 
                                            1'b0 ; 

// выходное PSW - передается в блок MMU
assign psw_out = {rbus_cpu_mode, pswmf[13:8], psw[7:0]} ;
assign pswmf[15:11] = psw[15:11];
assign pswmf[10:8] = 3'b000 ;

// Выходная шина данных RBUS - интерфейс к регистровому файлу
assign rbus_data = (rbus_ix == 3'b111) ? r7 : rbus_o ; // R7 хранится в отдельном регистре, остальное - в регистровом файле

// Вычисление значений автоинкремента/автодекремента
assign ir_fpma48 = (((fps[7]) == 1'b1 & ir[11:8] != 4'b1111) | ((fps[7]) == 1'b0 & ir[11:8] == 4'b1111)) ? 1'b1 : 1'b0 ;
assign rbus_data_m2 = rbus_data - 16'd2 ;

// Содержимое регистра после автодекремента - с учетом разрядности обрабатываемых операндов
assign rbus_data_mv = (ir_fpmaf == 1'b1 & ir_fpma48 == 1'b1 & rbus_ix != 3'b111) ? rbus_data-16'd8 : 
                      (ir_fpmaf == 1'b1 & ir_fpma48 == 1'b0 & rbus_ix != 3'b111) ? rbus_data-16'd4 : 
                      (ir_fpmai == 1'b1 & (fps[6]) == 1'b1 & rbus_ix != 3'b111) ? rbus_data-16'd4 : 
                      (ir_byte == 1'b1 & rbus_ix[2:1] != 2'b11) ? rbus_data-16'd1 : 
                                                                            rbus_data-16'd2 ;

// Содержимое регистра после автоинкремента - с учетом разрядности обрабатываемых операндов
assign rbus_data_pv = (ir_fpmaf == 1'b1 & ir_fpma48 == 1'b1 & rbus_ix != 3'b111) ? rbus_data+16'd8 : 
                      (ir_fpmaf == 1'b1 & ir_fpma48 == 1'b0 & rbus_ix != 3'b111) ? rbus_data+16'd4 : 
                      (ir_fpmai == 1'b1 & (fps[6]) == 1'b1 & rbus_ix != 3'b111) ? rbus_data+16'd4 : 
                      (ir_byte == 1'b1 & rbus_ix[2:1] != 2'b11) ? rbus_data+16'd1 :       // байтовая адресация - кроме SP и РС
                                                                         rbus_data+16'd2 ;  // все остальные случаи - словная адресация
                                                                         
// Сборка регистра SR1/MMR1

assign ir_mf = ir_mfpi | ir_mfpd;    // инструкции чтения из пространства предыдущего режима
assign ir_mt = ir_mtpi | ir_mtpd;    // инструкции записи в пространство предыдущего режима

assign sr1_dst = ((sr1_dstd != 5'b00000)) ? {sr1_dstd, ir[2:0]} : 8'b00000000 ;

assign sr1_src = ((ir_mt | ir_mf | ir_jsr) & (sr1_srcd != 5'b00000)) ? {sr1_srcd, 3'b110} : 
                 ((sr1_srcd != 5'b00000) & & ir_dop) ? {sr1_srcd, ir[8:6]} : 
                                                                            8'b00000000 ;
                                                                                    
assign sr1 = ((ir_dop | ir_jsr) & sr1_srcd != 5'b00000) ? {sr1_dst, sr1_src} : 
             (sr1_dstd == 5'b00000) ? {sr1_dst, sr1_src} : 
                                      {sr1_src, sr1_dst} ;
                                     
assign sr1_p2 = 5'o2;   // добавка автоинкремента на 2
// вычисление значения автоинкремента в зависимости от формата инструкции   
assign sr1_pv = (ir_fpmaf & ir_fpma48 & (rbus_ix != 3'b111)) ? 5'd8 :  
                (ir_fpmaf & ir_fpma48 & (rbus_ix != 3'b111)) ? 5'd4 : 
                (ir_fpmai & (fps[6] == 1'b1) & (rbus_ix != 3'b111)) ? 5'd4 : 
                (ir_byte  & (rbus_ix[2:1] != 2'b11)) ? 5'o1 : 
                                                       5'o2 ;
                                                              
assign sr1_m2 = 5'b11110 ; // добавка автодекремента на 2

// вычисление значения автодекремента в зависимости от формата инструкции   
assign sr1_mv = (ir_fpmaf == 1'b1 & ir_fpma48 == 1'b1 & rbus_ix != 3'b111) ? 5'b11000 :   // -8
                (ir_fpmaf == 1'b1 & ir_fpma48 == 1'b0 & rbus_ix != 3'b111) ? 5'b11100 :   // -4
                (ir_fpmai == 1'b1 & (fps[6]) == 1'b1 & rbus_ix != 3'b111) ? 5'b11100 :    // -4
                (ir_byte == 1'b1 & rbus_ix[2:1] != 2'b11) ?                 5'b11111 :    // -1
                                                                               5'b11110 ;    // -2
// Признак нечетного адреса при словном обмене                    
assign oddabort = ~dw8 & wbm_adr_o[0] & wbm_stb_o; 
                                                                             
//*******************************************************                                                                           
//*  Потактовая обработка состояний процессора
//*******************************************************                                                                             
   always @(posedge clk)   begin
      if (reset == 1'b1) begin
      //*********************************************
      //*   Сброс системы
      //*********************************************
         r7 <= startup_adr ;                    // Засылаем стартовый адрес в R7
         psw <= startup_psw ;                  // Начальное PSW
         rbus_cpu_mode <= startup_psw[15:14] ; // Начальный режим работы процессора - psw[15:14]
         rbus_cpu_psw11 <= startup_psw[11] ;   // Начальный набор регистров - psw[11]
         ir_rtt <= 1'b0 ; 
         wbm_stb_o <= 1'b0;
         iwait <= 1'b0 ;  // снимаем флаг ожидания  подтверждения прерывания
         finalreference <= 1'b0;
         // Снятие сигналов подтверждения прерывания
         vstb[7] <= 1'b0 ; 
         vstb[6] <= 1'b0 ; 
         vstb[5] <= 1'b0 ; 
         vstb[4] <= 1'b0 ; 
         npg <= 1'b0 ; 
         // Очистка флагов контроля стековых границ
         red_stack_trap <= 1'b0 ; 
         yellow_stack_event <= 1'b0 ; 
         yellow_stack_latch <= 1'b0 ; 
         // Регистры FP-11
         fps <= 16'h0000;   // регистр состояния
         fea <= 16'h0000;   // регистр адреса ошибки
         fec <= 4'b0000 ;   // регистр кода ошибки
         falu_load <= 1'b0 ; 
         psw_delayedupdate_even <= 1'b0 ;
         psw_delayedupdate_odd <= 1'b0 ; 
         spl_psw_update <= 1'b0;
         cpudelay <= 7'd`CPUSLOW;  // счетчик замедления процессора         
         state <= sq_init ; // Начальное состояние секвенсера
         initcycles <= 7 ;     // Число тактов задержки перед снятием сброса - ширина выходного импульса сброса шины
         init <= 1'b1 ;        // выставляем сигнал сброса шины
         rbus_waddr <= 6'b000000 ; // Начальный адрес в регистровом файле  - R0 набора 0
         rbus_d <= 16'd70;     // тип процессора - 11/70
         rbus_we <= 1'b1 ;     // Записываем тип процессора в регистр 0 набора 0
         dst_mode_processor <= sq_store_alu_r;
         src_mode_processor <= sq_store_alu_r;
         run <= 1'b1;           // признак запуска секвенсара команд
         nxmabort <= 1'b0;
         nxmabort_pend <= 1'b0;
         dstfreference <= 1'b0;
         trap_flag <= 1'b0;
         id_latch <= 1'b0;
         id <= 1'b0;
         cp <= 1'b0;
         cp_latch <= 1'b0;
         rsv_flag <= 1'b0;
         trap_force_kernel <= 1'b0;
      end
      
      else begin
      //***********************************************************
      //* Начальные состояния сигналов  в каждом такте секвенсора
      //*********************************************************** 
         id_latch <= id_current;
         cp_latch <= cp_req;
         rbus_we <= 1'b0 ;        // Снимаем флаг записи в основной регистровый файл
         fbus_we <= 1'b0 ;        // Снимаем флаг записи в регистровый файл FP-11
         ifetch <= 1'b0 ;         // Снимаем флаг выбора инструкции
         // Снятие флагов подтверждения прерывания от MMU
         ack_mmuabort <= 1'b0 ;   
         ack_mmutrap <= 1'b0 ; 
         // Снятие флага ошибки исполнения HALT в режимах, отлиных от KERNEL
         illhalt <= 1'b0 ; 
         falu_pending_clear <= 1'b0 ; 

         // Обработка триггеров запроса прерывания от схем контроля границ стека
         if (yellow_stack_event_trigger == 1'b1)    yellow_stack_event <= 1'b1 ; // Желтая граница
         if (red_stack_trap_trigger & ~trap_force_kernel)  begin
            // Красная граница
            red_stack_trap <= 1'b1 ; // установка флага прерывания
            state <= sq_rsv ;     // переключаем секвенсер  на обработку этого прерывания
         end
         
         // Обработка запросов прерывания по ошибке от MMU, с отменой обработки текущей инструкции
         else if (mmuabort == 1'b1)  begin
            wbm_stb_o <= 1'b0;    // снимаем строб шины
            wbm_we_o <= 1'b0;     // снимаем признак записи
            state <= sq_mmuabort ;  // переходим к обработке прерывания
            ack_mmuabort <= 1'b1 ;     // устанавливаем признак обработки прерывания
         end
         
         else if (nxmabort == 1'b1)  begin
            trap_vector <= 9'o004 ;    // Выставляем вектор 4
            state <= sq_trap ;      // переходим к обычной обработке прерывания
            nxmabort <= 1'b0;
            nxmabort_pend <= 1'b0;
         end
         
      //********************************************************************************
      //*  Рабочие состояния секвенсера - если не было условий внутренних прерываний
      //********************************************************************************
         else   begin
            case (state)
               //*********************************************************         
               //  Состояние после сброса
               //  Любая выполняемая инструкция сразу прерывается на любом этапе выполнения
               //*********************************************************         
               sq_init :
                        begin
                           // Таймаут сброса закончен
                           if (initcycles == 0)  begin
                              state <= sq_ifetch ;  // переходим к выборке первой инструкции 
                              init <= 1'b0 ;           // снимаем сигнал сброса с шины
                           end
                           // таймер сигнала сброса шины
                           else begin
                              init <= 1'b1 ;           // выставляем сигнал сброса шины
                              initcycles <= initcycles-1'b1 ;  // выдержка перед снятием сброса
                           end 
                        end
               //*********************************************************         
               // Подготовка к выборке очередной инструкции из памяти
               //*********************************************************         
               sq_ifetch :
                         // Пропуск тактов в режиме замедления процессора
                         if (cpuslow & (|cpudelay != 1'b0)) cpudelay <= cpudelay-1'b1;
                         else begin
                           cpudelay <= 7'd`CPUSLOW ;  
                           rbus_we <= 1'b0;
                           rbus_cpu_mode <= pswmf[15:14] ; // Установка текущего режима работы процессора из PSW
                           rbus_cpu_psw11 <= pswmf[11] ;   // Выбор текущего набора регистров по биту 11 PSW
                           red_stack_trap <= 1'b0 ;        // снимаем флаг красной границы стека
                           yellow_trap_inhibit <= 1'b0 ;  //  снимаем флаг подавления подвторного определения желтой границы
                           yellow_stack_event <= 1'b0;    // снимаем флаг события желтой границы - при выборке новой инструкции становится неактуальным
                           dstfreference <= 1'b0;         // снимаем флаг доступа к операнду-приемнику
                           id <= 1'b0;                    // ID=0 - идет выболрка инструкции
                           
                           // Обновление PSW
                           if (spl_psw_update) begin
                                 psw[7:5] <= psw_delayedupdate[7:5]; 
                                 spl_psw_update <= 1'b0;
                           end      
                           
                           if (psw_delayedupdate_even | psw_delayedupdate_odd) begin
                                 // Обновление PSW - малдший байт
                                 if (psw_delayedupdate_even == 1'b1) begin
                                       psw[7:5] <= psw_delayedupdate[7:5] ; // Обновление приоритета процессора
                                       psw[3:0] <= psw_delayedupdate[3:0] ; // обновление флагов
                                 end 
                                 
                                 // Обновление PSW - старший байт
                                 if (psw_delayedupdate_odd == 1'b1)  begin
                                       psw[15:8] <= psw_delayedupdate[15:8] ; 
                                       rbus_cpu_mode <= psw_delayedupdate[15:14] ; // новый режим процессора
                                 end 
                                 // Снимаем флаг запроса обновления
                                 psw_delayedupdate_even <= 1'b0 ; 
                                 psw_delayedupdate_odd <= 1'b0 ; 
                                 state <= sq_ifetch;
                           end                            
                           
                           // Обработка DMA-запрсов
                           else if (npr == 1'b1)  begin
                              state <= sq_dma ;         // переходим в состояние ожидания завершения DMA
                           end
                           
                           // Поиск источника прерываний
                           //-----------------------------------------
                           // Обработка ошибок MMU
                           else if (mmutrap == 1'b1)  begin
                              state <= sq_mmutrap ;     // переходим к прерыванию по вектору 150
                              ack_mmutrap <= 1'b1 ;        // подтверждаем прием прерывания
                           end
                           
                           // Обработка желтой границы стека
                           else if (yellow_stack_latch)  begin
                              yellow_stack_latch <= 1'b0 ;  // снимаем флаг 
                              yellow_trap_inhibit <= 1'b1 ;  // предотвращаем повторную установку флага
                              trap_vector <= 9'o004;       // вектор 4
                              state <= sq_trap ;        // переходим к обработке вектора
                           end
                           
                           // Обработка прерываний от FPU
                           else if (falu_pending_fic | falu_pending_fiu | falu_pending_fiv | falu_pending_divz ) state <= sq_fptrap ; 

                           // Обработка маскируемых векторных прерываний  и PIRQ
                                                       
                           // Обработка программных прерываний PIRQ 7
                           else if ((pirq[15] == 1'b1) & (psw[7:5] < 3'b111)) begin
                                 trap_vector <= 9'o240; 
                                 state <= sq_trap ; 
                           end
                           
                           // Обработка векторных прерываний уровня 7
                           else if (virq[7] == 1'b1 & (psw[7:5]) < (3'b111))  begin
                              state <= sq_virq7 ; // переходим в состояния обработки векторных прерываний, приоритет 7
                           end
                           
                           // Обработка программных прерываний PIRQ 6                           
                           else if ((pirq[14] == 1'b1) & (psw[7:5] < 3'b110)) begin
                                 trap_vector <= 9'o240; 
                                 state <= sq_trap ; 
                           end
                           
                           // Обработка векторных прерываний уровня 6
                           else if (virq[6] == 1'b1 & (psw[7:5]) < (3'b110)) begin
                              state <= sq_virq6 ;
                           end

                           // Обработка программных прерываний PIRQ 5
                           else if ((pirq[13] == 1'b1) & (psw[7:5] < 3'b101)) begin
                                trap_vector <= 9'o240; 
                                state <= sq_trap ; 
                           end
                           
                           // Обработка векторных прерываний уровня 5
                           else if (virq[5] == 1'b1 & (psw[7:5]) < (3'b101))  begin
                              state <= sq_virq5 ; 
                           end
                           
                           // Обработка программных прерываний PIRQ 4
                           else if ((pirq[12] == 1'b1) & (psw[7:5] < 3'b100)) begin
                                trap_vector <= 9'o240; 
                                state <= sq_trap ; 
                           end
                           
                           // Обработка векторных прерываний уровня 4
                           else if (virq[4] == 1'b1 & (psw[7:5]) < (3'b100))  begin
                              state <= sq_virq4 ; 
                           end
                           
                           // Обработка программных прерываний PIRQ 3
                           else if ((pirq[11] == 1'b1) & (psw[7:5] < 3'b011)) begin
                                trap_vector <= 9'o240; 
                                state <= sq_trap ; 
                           end
                           
                           // Обработка программных прерываний PIRQ 2
                           else if ((pirq[10] == 1'b1) & (psw[7:5] < 3'b010)) begin
                                trap_vector <= 9'o240; 
                                state <= sq_trap ; 
                           end
                           
                           // Обработка программных прерываний PIRQ 1
                           else if ((pirq[9] == 1'b1) & (psw[7:5] < 3'b001)) begin
                                trap_vector <= 9'o240; 
                                state <= sq_trap ; 
                           end
                           
                           // Обработка прерываний по биту Т
                           else if ((psw[4]) == 1'b1 & ir_rtt == 1'b0 & iwait == 1'b0)  begin
                              // если поднят бит Т, и не выполнялась RTT, и мы не ждем прерывания
                              trap_vector <= 9'o014;   // вектор 14
                              state <= sq_trap ; 
                           end
                           // Активных прерываний нет - начинаем выборку инструкции
                           else begin
                              run <= 1'b1 ;            // признак запуска секвенсера
                              // сброс компонентов SR/MMR
                              sr1_srcd <= 5'b00000 ; // источник
                              sr1_dstd <= 5'b00000 ; // приемник
                              sr0_ic <= 1'b1 ;       // IC - флаг завершения инструкции
                              sr2 <= r7 ;            // SR2 - адрес текущей инструкции
                              if (iwait == 1'b0)  begin
                                 // Если не выполняется инструкция wait
                                 ifetch <= 1'b1 ;         // Поднимаем признак выборки инструкции
                                 nextstate <= sq_idecode ; // Переходим к выборке инструкции
                                 state <= sq_wbread_wait;
                                 wbm_adr_o <= r7;
                                 bus_timer <= 6'd`busdelay;   // взводим таймер ожидания
                                 wbm_stb_o <= 1'b1;
                                 wbm_we_o <= 1'b0;
                                 wbm_sel_o <= 2'b11;
                                 state <= sq_wbread_wait;
                              end
                           end 
                           
                        end
               //*********************************************************         
               //* Выборка и декодирование инструкции
               //*********************************************************         
               //*  addr=r7
               //*  rd+
               sq_idecode :  begin
                        if (nxmabort_pend == 1'b1)  begin
                                trap_vector <= 9'o004 ;    // Выставляем вектор 4
                                state <= sq_trap ;      // переходим к обычной обработке прерывания
                                nxmabort <= 1'b0;
                                nxmabort_pend <= 1'b0;
                        end
                        else begin
                           r7 <= r7+16'd2 ;       // Инкремент PC - инструкцию выбираем по PC+2
                           ir <= datain ;     // Выбираем инструкцию из памяти и помещаем в регистр ir
                           ir_addr <= r7 ;    // сохраняем адрес инструкции
                           sr0_ic <= 1'b0 ;   // признак незавершенности инструкции
                           ir_fpmaf <= 1'b0 ; // not a fp 4- or 8-byte memory access
                           ir_fpmai <= 1'b0 ; // not a fp integer mode memory access
                           
                           // Сброс флагов типов инструкций
                           ir_sop <= 1'b0 ; 
                           ir_dop <= 1'b0 ; 
                           ir_jmp <= 1'b0 ; 
                           ir_jsr <= 1'b0 ; 
                           ir_mfpi <= 1'b0 ;
                           ir_mfpd <= 1'b0 ;
                           ir_mtpi <= 1'b0 ;
                           ir_mtpd <= 1'b0 ;
                           ir_dopr <= 1'b0 ;
                           ir_fpsop1 <= 1'b0 ;
                           ir_fpsop2 <= 1'b0 ;
                           ir_fpao <= 1'b0 ; 
                           ir_facdst <= 1'b0 ;
                           ir_facsrc <= 1'b0 ;
                           ir_facfdst <= 1'b0 ;
                           ir_facfsrc <= 1'b0 ;
                           ir_rtt <= 1'b0 ; 
                           
                           fbus_fd <= fps[7] ; // fpu-флаг FPS 
                           
                           falu_pending_clear <= 1'b1 ; // Очистка запроса прерывания от FPU
                           
                           state <= sq_illegalop ;   // по умолчанию следующее состояние - неправильная инструкция
                           
                           // * Установка флагов характеристик выбранной инструкции
                           
                           // Флаг однооперандной инструкции
                           if (datain[14:9] == 7'b0000101               // один операнд, слово или байт (x05xxx)
                              | datain[14:8] == 8'b00001100             // один операнд, слово или байт (x06xxx), первая половина диапазона инструкций
                              | datain[15:6] == 10'b0000000011          // swab
                              | (datain[15:6] == 10'b0000110111 ))      // sxt
                             v_sop = 1'b1; 
                           else v_sop = 1'b0; 
                           
                           // Флаг двухоперандной инструкции
                           if (datain[14:12] != 3'b000 & datain[14:12] != 3'b111)  v_dop = 1'b1; 
                           else  v_dop = 1'b0;
                           
                           // jmp
                           if (datain[15:6] == 10'b0000000001)     v_jmp = 1'b1; 
                           else v_jmp = 1'b0; 

                           // jsr
                           if (datain[15:9] == 7'b0000100)         v_jsr = 1'b1; 
                           else   v_jsr = 1'b0; 

                           // mfpi
                           if (datain[15:6] == 10'b0000110101)  v_mfpi = 1'b1; 
                           else     v_mfpi = 1'b0; 
                           // mfpd
                           if (datain[15:6] == 10'b1000110101)  v_mfpd = 1'b1; 
                           else                      v_mfpd = 1'b0; 
                           // mtpi
                           if (datain[15:6] == 10'b0000110110)  v_mtpi = 1'b1; 
                           else                              v_mtpi = 1'b0; 
                           // mtpd
                           if (datain[15:6] == 10'b1000110110)  v_mtpd = 1'b1; 
                           else                              v_mtpd = 1'b0; 
                           // двухоперандная с регистром - eis и команда xor
                              // mul, div, ash, ashc
                              // xor
                           if ((datain[15:11] == 5'b01110) | (datain[15:9] == 7'b0111100))    v_dopr = 1'b1; 
                           else   v_dopr = 1'b0; 
                           
                           // fpu, однооперандная группы 1 - не использующие аккумулятор
                           // dfps, stfps, stst
                           if (datain[15:8] == 8'b11110000 & datain[7:6] != 2'b00 & fpu_enable == 1)  v_fpsop1 = 1'b1; 
                           else    v_fpsop1 = 1'b0; 

                           // fpu, однооперандная группы 2 - использующие аккумулятор
                           // lr(f/d), tst(f/d), abs(f/d), neg(f/d)
                           if (datain[15:8] == 8'b11110001 & fpu_enable == 1)    v_fpsop2 = 1'b1; 
                           else                              v_fpsop2 = 1'b0; 

                           // fpu, двухоперандные с аккумулятором
                           if (datain[15:12] == 4'b1111 & datain[11:9] != 3'b000 & fpu_enable == 1)  v_fpao = 1'b1; 
                           else           v_fpao = 1'b0; 

                           //
                           // Копирование флагов в регистры хранения
                           //
                           if (v_sop == 1'b1)  ir_sop <= 1'b1 ; 
                           if (v_dop == 1'b1)  ir_dop <= 1'b1 ; 
                           if (v_jmp == 1'b1)  ir_jmp <= 1'b1 ; 
                           if (v_jsr == 1'b1)  ir_jsr <= 1'b1 ; 
                           if (v_mfpi == 1'b1) ir_mfpi <= 1'b1 ; 
                           if (v_mfpd == 1'b1) ir_mfpd <= 1'b1 ; 
                           if (v_mtpi == 1'b1) ir_mtpi <= 1'b1 ; 
                           if (v_mtpd == 1'b1) ir_mtpd <= 1'b1 ; 
                           if (v_dopr == 1'b1) ir_dopr <= 1'b1 ; 
                           if (v_fpsop1 == 1'b1)  ir_fpsop1 <= 1'b1 ; 
                           if (v_fpsop2 == 1'b1)  begin
                              ir_fpsop2 <= 1'b1 ; 
                              ir_fpmaf <= 1'b1 ; 
                           end 
                           if (v_fpao == 1'b1) begin
                              ir_fpao <= 1'b1 ; 
                              ir_facdst <= 1'b0 ; 
                              ir_facsrc <= 1'b0 ; 
                              ir_facfdst <= 1'b0 ; 
                              ir_facfsrc <= 1'b0 ; 
                              if (datain[11:9] == 3'b101)  begin
                                 // stexp, stc(f|d)(i|l)
                                 ir_facdst <= 1'b1 ; 
                                    // stc(f|d)(i|l)
                                 if ((datain[8]) == 1'b1)  ir_fpmai <= 1'b1 ; // Требуется доступ к 2 или 4 байтам памяти
                              end
                                 // ldexp
                              else if (datain[11:8] == 4'b1101) ir_facsrc <= 1'b1 ; 
                              else if (datain[11:8] == 4'b1110) begin
                                 // ldc(i|l)(f|d)
                                 ir_facsrc <= 1'b1 ; 
                                 ir_fpmai <= 1'b1 ; // Требуется доступ к 2 или 4 байтам памяти
                              end
                              else if (datain[11:8] == 4'b1000) begin
                                 // st(f|d)
                                 ir_facfdst <= 1'b1 ; 
                                 ir_fpmaf <= 1'b1 ; // Требуется доступ к 4 или 8 байтам памяти
                              end
                              else if (datain[11:8] == 4'b1100) begin
                                 // stc(f|d)
                                 ir_facfdst <= 1'b1 ; 
                                 ir_fpmaf <= 1'b1 ; // Требуется доступ к 4 или 8 байтам памяти
                              end
                              else begin
                                 // Для всех fp-команд, не попавших в одну из вышеопределенных категорий
                                 ir_facfsrc <= 1'b1 ; 
                                 ir_fpmaf <= 1'b1 ; // Требуется доступ к 4 или 8 байтам памяти
                              end 
                           end 
                           
                           //*********************************************************************
                           //*  Обработка групп инструкций:
                           //*   - однооперандных
                           //*   - двухоперандных
                           //*   - JMP, JSR, MFPI, MFPD, MTPI, MTPD
                           //*   - EIS-инструкций и команды XOR
                           //*   - fp-инструкций, работающих с шиной
                           //*********************************************************************
                           if (v_sop == 1'b1    | v_dop == 1'b1    | v_jmp == 1'b1 
                             | v_jsr == 1'b1    | v_mfpi == 1'b1   | v_dopr == 1'b1 
                             | v_mfpd == 1'b1   | v_mtpi == 1'b1   | v_mtpd == 1'b1 
                             | v_fpsop1 == 1'b1 | v_fpsop2 == 1'b1 | v_fpao == 1'b1)  begin
                             
                              case (datain[5:3])
                                 //  Определение режимов адресации операнда - приемника или единственного
                                 //  установка соответствующего обработчика
                                 3'b000 : src_mode_processor <= sq_dst0 ;   // R
                                 3'b001 : src_mode_processor <= sq_dst1 ;   // @R   
                                 3'b010 : src_mode_processor <= sq_dst2 ;   // (R)+
                                 3'b011 : src_mode_processor <= sq_dst3 ;   // @(R)+
                                 3'b100 : src_mode_processor <= sq_dst4 ;   // -(R)
                                 3'b101 : src_mode_processor <= sq_dst5 ;   // @-(R)
                                 3'b110 : src_mode_processor <= sq_dst6 ;   // X(R) (индексный)
                                 3'b111 : src_mode_processor <= sq_dst7 ;   // @X(R) (косвенно-индексный)
                              endcase 
                              
                              // Установка обработчика регистра-приемника для АЛУ
                              if (datain[5:3] == 3'b000)  dst_mode_processor <= sq_store_alu_r ; // приемник - регистр
                              else                        dst_mode_processor <= sq_store_alu_p ; // все остальные способы адресации приемника
                              
                              //*********************************************************************
                              // дальнейшая обработка двухоперандных инструкций
                              //*********************************************************************
                              if (v_dop == 1'b1)   begin  
                                 // определение режима адресации источника
                                 case (datain[11:9])
                                    3'b000 :            // R
                                             begin
                                                rbus_ix <= datain[8:6] ;   // # регистра-источника
                                                state <= sq_src0 ;      
                                             end
                                    3'b001 :            // @R
                                             begin
                                                rbus_ix <= datain[8:6] ; 
                                                state <= sq_src1 ; 
                                             end
                                    3'b010 :            // (R)+
                                             begin
                                                rbus_ix <= datain[8:6] ; 
                                                state <= sq_src2 ; 
                                             end
                                    3'b011 :            // @(R)+
                                             begin
                                                rbus_ix <= datain[8:6] ; 
                                                state <= sq_src3 ; 
                                             end
                                    3'b100 :            // -(R)
                                             begin
                                                rbus_ix <= datain[8:6] ; 
                                                state <= sq_src4 ; 
                                             end
                                    3'b101 :            // @-(R)
                                             begin
                                                rbus_ix <= datain[8:6] ; 
                                                state <= sq_src5 ; 
                                             end
                                    3'b110 :            // X(R)
                                             begin
                                                rbus_ix <= datain[8:6] ; 
                                                state <= sq_src6 ; 
                                             end
                                    3'b111 :            // @X(R)
                                             begin
                                                rbus_ix <= datain[8:6] ; 
                                                state <= sq_src7 ; 
                                             end
                                 endcase 
                              end
                              else  begin
                              //*********************************************************************
                              //* Обработка однооперандных и безоперандных инструкций
                              //*********************************************************************
                                 // определение режима адресации операнда
                                 case (datain[5:3])
                                    3'b000 :  // R
                                             begin
                                                if ((v_jmp|v_jsr) == 1'b1) state <= sq_illegalop ; // JMP при регистровой адресации недопустим - трап 10 
                                                
                                                // mfpi/mfpd
                                                else if (v_mfpi == 1'b1 | v_mfpd == 1'b1)  begin
                                                   if (datain[2:0] == 3'b110)  rbus_cpu_mode <= psw[13:12] ; // получаем текущий режим процессора
                                                   rbus_ix <= datain[2:0] ;   // выделяем номер регистра
                                                   state <= sq_dst0 ;    // уходим на обработку приемника (R)
                                                end
                                                
                                                // mtpi/mtpd
                                                else if (v_mtpi == 1'b1 | v_mtpd == 1'b1)  begin
                                                   // в регистровом режиме - просто читаем регистр
                                                   rbus_ix <= 3'b110 ; // SP
                                                   state <= sq_mtp ; 
                                                end
                                                
                                                else if (fpu_enable == 1 & v_fpao == 1'b1)begin
                                                   if (datain[11:9] != 3'b101 & datain[11:8] != 4'b1101 & datain[11:8] != 4'b1110) begin
                                                      if (datain[2:1] == 2'b11)  begin
                                                         // ac6 and ac7 do not exist
                                                         fec <= 4'b0010 ; 
                                                         state <= sq_fptrap ; 
                                                      end
                                                      else begin
                                                         // stexp, stc(f/d)(i/l)
                                                         // ldexp
                                                         // ldc(i/l)(f/d)
                                                         if ({datain[11], datain[9:8]} == 3'b100)  fbus_raddr <= {1'b0, datain[7:6]} ; 
                                                         else                                      fbus_raddr <= datain[2:0] ; 
                                                         state <= sq_fpao ; 
                                                      end 
                                                   end
                                                   else  begin
                                                      fbus_raddr <= {1'b0, datain[7:6]} ; // ldexp, ldc(i/l)(f/d), stexp, stc(f/d)(i/l) get ac
                                                      rbus_ix <= datain[2:0] ; 
                                                      state <= sq_dst0 ; 
                                                   end 
                                                end
                                                
                                                else if (fpu_enable == 1 & v_fpsop2 == 1'b1) begin
                                                   if (datain[2:1] == 2'b11)  begin
                                                      // Регистров AC6 и 7 не существует - трап при попытке работы с ними
                                                      fec <= 4'b0010 ; 
                                                      state <= sq_fptrap ; 
                                                   end
                                                   else begin
                                                      fbus_raddr <= datain[2:0] ; 
                                                      state <= sq_fpso2 ; 
                                                   end 
                                                end
                                                
                                                else begin
                                                   rbus_ix <= datain[2:0] ; // выбираем номер регистр-приемника
                                                   state <= sq_dst0 ; 
                                                end 
                                             end
                                    3'b001 :   // @R
                                             begin
                                                state <= sq_dst1 ; 
                                                rbus_ix <= datain[2:0] ; 
                                             end
                                    3'b010 :   // (R)+
                                             begin
                                                state <= sq_dst2 ; 
                                                rbus_ix <= datain[2:0] ; 
                                             end
                                    3'b011 :   // @(R)+
                                             begin
                                                state <= sq_dst3 ; 
                                                rbus_ix <= datain[2:0] ; 
                                             end
                                    3'b100 :   // -(R)
                                             begin
                                                state <= sq_dst4 ; 
                                                rbus_ix <= datain[2:0] ; 
                                             end
                                    3'b101 :   // @-(R)
                                             begin
                                                state <= sq_dst5 ; 
                                                rbus_ix <= datain[2:0] ; 
                                             end
                                    3'b110 :   // X(R)
                                             begin
                                                state <= sq_dst6 ; 
                                                rbus_ix <= datain[2:0] ; 
                                             end
                                    3'b111 :   // @X(R)
                                             begin
                                                state <= sq_dst7 ; 
                                                rbus_ix <= datain[2:0] ; 
                                             end
                                 endcase 
                                 // для однооперандных инструкций - определяем обработчик результата
                                 if (v_sop == 1'b1)  begin
                                    if (datain[5:3] == 3'b000)   dst_mode_processor <= sq_store_alu_r ;   // регистр
                                    else                         dst_mode_processor <= sq_store_alu_p ;   // память
                                 end
                                 
                                 else if (v_jmp == 1'b1)         dst_mode_processor <= sq_jmp ; 
                                 else if (v_jsr == 1'b1)         dst_mode_processor <= sq_jsr ; 
                                 else if (v_mfpi == 1'b1 | v_mfpd == 1'b1) dst_mode_processor <= sq_mfp ; 
                                 else if (v_mtpi == 1'b1 | v_mtpd == 1'b1)  begin
                                    rbus_ix <= 3'b110 ; 
                                    state <= sq_mtp ; 
                                 end
                                 else if (v_dopr == 1'b1)       dst_mode_processor <= sq_dopr ; 
                                 
                                 else if (fpu_enable == 1 & v_fpsop1 == 1'b1)   begin
                                    case (datain[7:6])
                                       2'b01 :
                                                   // ldfps
                                                   dst_mode_processor <= sq_ldfps ; 
                                       2'b10 :
                                                begin
                                                   // stfps
                                                   if (datain[5:3] == 3'b000)  dst_mode_processor <= sq_store_alu_r ; 
                                                   else                        dst_mode_processor <= sq_store_alu_p ; 
                                                end
                                       2'b11 :
                                                begin
                                                   // stst
                                                   if (datain[5:3] == 3'b000)  dst_mode_processor <= sq_store_alu_r ; 
                                                   else                        dst_mode_processor <= sq_store_alu_p ; 
                                                end
                                    endcase 
                                 end
                                 else if (fpu_enable == 1 & v_fpsop2 == 1'b1)  dst_mode_processor <= sq_fpso2 ; // clr(f|d),tst(f|d),abs(f|d),neg(f|d)
                                 else if (fpu_enable == 1 & v_fpao == 1'b1)  begin
                                    dst_mode_processor <= sq_fpao ; 
                                       // ldexp
                                       // stexp
                                       // st(f|d), stc(f|d)(d|f)
                                       // stc(f|d)(i|l)
                                    if (datain[11:8] == 4'b1101 | datain[11:8] == 4'b1010 | {datain[11], datain[9:8]} == 3'b100 | datain[11:8] == 4'b1011) 
                                       fbus_raddr <= {1'b0, datain[7:6]} ; // st(f|d), stc(f|d)(d|f), ldexp, stexp
                                 end
                                 else  dst_mode_processor <= sq_illegalop ; 
                              end 
                           end 
                           
                           if (datain[14:11] == 4'b0000)  begin
                              if ((datain[15]) == 1'b0 & datain[10:8] == 3'b000)  begin
                                 if (datain[7:0] == 8'b00000000)  begin
                                    // HALT
                                    if (pswmf[15:14] != 2'b00 )  begin
                                       // в режимах, отличных от kernel, команда вызывает трап 4
                                       illhalt <= 1'b1 ; 
                                       trap_vector <= 9'o004; 
                                       state <= sq_trap ; 
                                    end
                                    else  begin
                                       // в режиме kernel - отключаем секвенсор
                                       run <= 1'b0 ; 
                                       state <= sq_halt ; 
                                    end
                                 end 
                                 if (datain[7:0] == 8'b00000001)   begin
                                    // wait
                                    iwait <= 1'b1 ; 
                                    state <= sq_ifetch ; 
                                 end 
                                 if (datain[7:0] == 8'b00000010)   begin
                                    // rti
                                    state <= sq_rti ; 
                                    rbus_ix <= 3'b110 ; 
                                 end 
                                 if (datain[7:0] == 8'b00000011)  begin
                                    // bpt
                                    trap_vector <= 9'o014 ; // bpt, vector = 014
                                    state <= sq_trap ; 
                                 end 
                                 if (datain[7:0] == 8'b00000100)  begin
                                    // IOT
                                    trap_vector <= 9'o020; // iot, vector = 020
                                    state <= sq_trap ; 
                                 end 
                                 if (datain[7:0] == 8'b00000101) begin
                                    // RESET
                                    if (pswmf[15:14] == 2'b00) begin
                                       initcycles <= `initcycles_reset ; 
                                       state <= sq_init ; 
                                    end
                                    else  state <= sq_ifetch ; // Не в kernel эта команда игнорируется
                                 end 
                                 if (datain[7:0] == 8'b00000110)   begin
                                    // RTT
                                    state <= sq_rti ; 
                                    rbus_ix <= 3'b110 ; 
                                    ir_rtt <= 1'b1 ; 
                                 end 
                                 if (datain[7:3] == 5'b10000) begin
                                    // RTS
                                    state <= sq_rts ; 
                                    rbus_ix <= 3'b110 ; 
                                 end 
                                 if (datain[7:3] == 5'b10011)  begin
                                    // SPL
                                    if (pswmf[15:14] == 2'b00)  begin
                                       psw_delayedupdate[7:5] <= datain[2:0] ; 
                                       spl_psw_update <= 1'b1;
                                    end   
                                    state <= sq_ifetch ; 
                                 end 
                                 if (datain[7:4] == 4'b1010)   begin
                                    // clear cc
                                    psw[3:0] <= psw[3:0] & (~datain[3:0]) ; 
                                    state <= sq_ifetch ; 
                                 end 
                                 if (datain[7:4] == 4'b1011)  begin
                                    // set cc
                                    psw[3:0] <= psw[3:0] | datain[3:0] ; 
                                    state <= sq_ifetch ; 
                                 end 
                              end
                              else begin
                                 // Команды относительных переходов.
                                 state <= sq_ifetch ; 
                                 case ({datain[15], datain[10:8]})
                                    // Вычисление адреса перехода
                                    4'b0001 :
                                                // br
                                                r7 <= r7+16'd2 + ({datain[7], datain[7], datain[7], datain[7], datain[7], datain[7], datain[7], datain[7:0], 1'b0}) ; 
                                    4'b0010 :
                                                // bne
                                                if ((psw[2]) == 1'b0)  r7 <= r7+16'd2 + ({datain[7], datain[7], datain[7], datain[7], datain[7], datain[7], datain[7], datain[7:0], 1'b0}) ; 
                                    4'b0011 :
                                                // beq
                                                if ((psw[2]) == 1'b1)  r7 <= r7+16'd2 + ({datain[7], datain[7], datain[7], datain[7], datain[7], datain[7], datain[7], datain[7:0], 1'b0}) ; 
                                    4'b0100 :
                                                // bge
                                                if (psw[3] == psw[1])  r7 <= r7+16'd2 + ({datain[7], datain[7], datain[7], datain[7], datain[7], datain[7], datain[7], datain[7:0], 1'b0}) ; 
                                    4'b0101 :
                                                // blt
                                                if (psw[3] != psw[1])  r7 <= r7+16'd2 + ({datain[7], datain[7], datain[7], datain[7], datain[7], datain[7], datain[7], datain[7:0], 1'b0}) ; 
                                    4'b0110 :
                                                // bgt
                                                if ((psw[2]) == 1'b0 & psw[3] == psw[1]) r7 <= r7+16'd2 + ({datain[7], datain[7], datain[7], datain[7], datain[7], datain[7], datain[7], datain[7:0], 1'b0}) ; 
                                    4'b0111 :
                                                // ble
                                                if ((psw[2]) == 1'b1 | psw[3] != psw[1])  r7 <= r7+16'd2 + ({datain[7], datain[7], datain[7], datain[7], datain[7], datain[7], datain[7], datain[7:0], 1'b0}) ; 
                                    4'b1000 :
                                                // bpl
                                                if ((psw[3]) == 1'b0)  r7 <= r7+16'd2 + ({datain[7], datain[7], datain[7], datain[7], datain[7], datain[7], datain[7], datain[7:0], 1'b0}) ; 
                                    4'b1001 :
                                                // bmi
                                                if ((psw[3]) == 1'b1)  r7 <= r7+16'd2 + ({datain[7], datain[7], datain[7], datain[7], datain[7], datain[7], datain[7], datain[7:0], 1'b0}) ; 
                                    4'b1010 :
                                                // bhi
                                                if ((psw[2]) == 1'b0 & (psw[0]) == 1'b0)  r7 <= r7+16'd2 + ({datain[7], datain[7], datain[7], datain[7], datain[7], datain[7], datain[7], datain[7:0], 1'b0}) ; 
                                    4'b1011 :
                                                // blos
                                                if ((psw[2]) == 1'b1 | (psw[0]) == 1'b1)  r7 <= r7+16'd2 + ({datain[7], datain[7], datain[7], datain[7], datain[7], datain[7], datain[7], datain[7:0], 1'b0}) ; 
                                    4'b1100 :
                                                // bvc
                                                if ((psw[1]) == 1'b0)  r7 <= r7+16'd2 + ({datain[7], datain[7], datain[7], datain[7], datain[7], datain[7], datain[7], datain[7:0], 1'b0}) ; 
                                    4'b1101 :
                                                // bvs
                                                if ((psw[1]) == 1'b1)  r7 <= r7+16'd2 + ({datain[7], datain[7], datain[7], datain[7], datain[7], datain[7], datain[7], datain[7:0], 1'b0}) ; 
                                    4'b1110 :
                                                // bhis
                                                if ((psw[0]) == 1'b0)  r7 <= r7+16'd2 + ({datain[7], datain[7], datain[7], datain[7], datain[7], datain[7], datain[7], datain[7:0], 1'b0}) ; 
                                    4'b1111 :
                                                // blo
                                                if ((psw[0]) == 1'b1)  r7 <= r7+16'd2 + ({datain[7], datain[7], datain[7], datain[7], datain[7], datain[7], datain[7], datain[7:0], 1'b0}) ; 
                                 endcase 
                              end 
                           end 
                           if (datain[15:9] == 7'b1000100)  begin
                              // trap, emt
                              if ((datain[8]) == 1'b0)    trap_vector <= 9'o030; // emt, vector = 030
                              else                        trap_vector <= 9'o034; // trap, vector = 034
                              state <= sq_trap ; 
                           end 
                           
                           if (datain[15:9] == 7'b0111111)  begin
                              // sob
                              rbus_ix <= datain[8:6] ; 
                              state <= sq_sob ; 
                           end 
                           
                           if (datain[15:6] == 10'b0000110100)  begin
                              // mark
                              rbus_waddr <= {pswmf[15:14], 4'b0110} ; 
                              rbus_d <= r7+16'd2 + ({datain[5:0], 1'b0}) ; 
                              rbus_we <= 1'b1 ; 
                              rbus_ix <= 3'b101 ; 
                              state <= sq_mark ; 
                           end 
                           
                           if (fpu_enable == 1 & datain[15:6] == 10'b1111000000)  begin
                              // Команды FPP
                              case (datain[5:0])
                                 6'b000000 :
                                          begin
                                             // cfcc
                                             psw[3:0] <= fps[3:0] ; 
                                             state <= sq_ifetch ; 
                                          end
                                 6'b000001 :
                                          begin
                                             // setf
                                             fps[7] <= 1'b0 ; 
                                             state <= sq_ifetch ; 
                                          end
                                 6'b000010 :
                                          begin
                                             // seti
                                             fps[6] <= 1'b0 ; 
                                             state <= sq_ifetch ; 
                                          end
                                 6'b001001 :
                                          begin
                                             // setd
                                             fps[7] <= 1'b1 ; 
                                             state <= sq_ifetch ; 
                                          end
                                 6'b001010 :
                                          begin
                                             // setl
                                             fps[6] <= 1'b1 ; 
                                             state <= sq_ifetch ; 
                                          end
                                 default :
                                          begin
                                                if (datain[5:3] == 3'b000)  state <= sq_ifetch ; 
                                                else  begin
                                                   fec <= 4'b0010 ;
                                                   state <= sq_fptrap ; 
                                                end 
                                          end
                              endcase 
                           end 
                        end
                     end   
               //*****************************************************
               // halt : остановка секвенсера до сигнала CONT
               //*****************************************************
               sq_halt :
                        begin
                           if (sw_cont == 1'b0) run <= 1'b0 ; // отключаем секвенсер
                           else begin
                             // кнопка CONT нажата
                             run <= 1'b1;         // включаем секвенсер
                             state <= sq_ifetch;  // запускаем выборку команд
                           end  
                        end   
               //*****************************************************
               // неправильный код операции
               //*****************************************************
               sq_illegalop :
                        begin
                           // неправильный КОП для FP-команд
                           if (fpu_enable == 1 & ir[15:12] == 4'b1111)   begin
                              fec <= 4'b0010 ; 
                              state <= sq_fptrap ;  
                           end
                           
                           // остальные ошибки команд
                           else   begin
                              trap_vector <= 9'o010; // недопустимая инструкция, трап 10
                              state <= sq_trap ; 
                           end 
                        end
               //*****************************************************
               // jmp 
               //*****************************************************
               sq_jmp :
                        begin
                           r7 <= dest_addr ;    // просто записываем в R7 новый адрес
                           state <= sq_ifetch ; // и продолжаем выборку команд
                        end
               //*****************************************************
               // npg : подтверждение DMA
               //*****************************************************
               sq_dma :
                        begin
                           run <= 1'b0 ;    // останавливаем секвенсор 
                           if (npr == 1'b0)  begin
                              // запрос DMA снят
                              state <= sq_ifetch ; // включаем секвенсор и переходим к следующей инструкции
                              npg <= 1'b0 ;  // снимаем сигнал подтверждения
                           end
                           else   npg <= 1'b1 ;  // выставляем сигнал подтверждени
                        end
               //*******************************************************************
               // mmuabort : mmu требует прекратить обработку текущей инструкции
               //*******************************************************************
               sq_mmuabort:
                        begin
                           wbm_stb_o <= 1'b0;    // снимаем строб шины
                           wbm_we_o <= 1'b0;     // снимаем признак записи
                           finalreference <= 1'b0;
                           dstfreference <= 1'b0;
                           sr0_ic <= 1'b0;
                           cp <= 1'b0;
                           if (trap_flag == 1'b1) begin
                              psw <= temp_psw;
                              sr2 <= r7;
                              trap_flag <= 1'b0;
                           end   
                           if (mmuabort == 1'b0)  begin  // ждем снятия сигнала прерывания со стороны MMU
                              ack_mmuabort <= 1'b0 ; // снимаем сигнал подтверждения 
                              trap_vector <= 9'o250; // прерывание по вектору 250
                              state <= sq_trap ; 
                           end 
                        end
               //*****************************************************************************
               // mmutrap : mmu требует запрос прерывания по окончании текущей инструкции
               //*****************************************************************************
               sq_mmutrap :
                        begin
                           if (mmutrap == 1'b0)  begin
                              ack_mmutrap <= 1'b0 ; 
                              trap_vector <= 9'o250; // mmu, vector = 250
                              state <= sq_trap ; 
                           end 
                        end
               //*****************************************************         
               // Запрос векторного прерывания уровня 7
               //*****************************************************         
               sq_virq7 :
                        begin
                              // проверяем, не снят ли запрос прерывания
                              if (virq[7] == 1'b0) begin
                                 state <= sq_ifetch;
                                 vstb[7] <= 1'b0;
                              end   
                              // если не снят, поднимаем строб запроса вектора
                              else vstb[7] <= 1'b1;    
                              
                              // получение вектора прерывания
                              if (virq[7] == 1'b1) trap_vector <= vector ;  // получаем вектор прерывания
                              // получено подтверждение
                              if (vack == 1'b1) begin
                                vstb[7] <= 1'b0;             // 
                                state <= sq_trap ;  // переходим к обработке прерывания
                                sr2 <= {7'b0000000, vector} ; // записываем вектор в SR2
                                sr0_ic <= 1'b0 ; // снимаем флаг завершения выполнения инструкции
                             end 
                        end
               //*****************************************************         
               // Запрос векторного прерывания уровня 6
               //*****************************************************         
               sq_virq6 :
                        begin
                              // проверяем, не снят ли запрос прерывания
                              if (virq[6] == 1'b0) begin
                                 state <= sq_ifetch;
                                 vstb[6] <= 1'b0;
                              end   
                              // если не снят, поднимаем строб запроса вектора
                              else vstb[6] <= 1'b1;    
                              
                              // получение вектора прерывания
                              if (virq[6] == 1'b1) trap_vector <= vector ;  // получаем вектор прерывания
                              // получено подтверждение
                              if (vack == 1'b1) begin
                                vstb[6] <= 1'b0;             // 
                                state <= sq_trap ;  // переходим к обработке прерывания
                                sr2 <= {7'b0000000, vector} ; // записываем вектор в SR2
                                sr0_ic <= 1'b0 ; // снимаем флаг завершения выполнения инструкции
                             end 
                        end
               //*****************************************************         
               // Запрос векторного прерывания уровня 5
               //*****************************************************         
               sq_virq5 :
                        begin
                              // проверяем, не снят ли запрос прерывания
                              if (virq[5] == 1'b0)  begin
                                 state <= sq_ifetch;
                                 vstb[5] <= 1'b0;
                              end   
                              // если не снят, поднимаем строб запроса вектора
                              else vstb[5] <= 1'b1;    
                              
                              // получение вектора прерывания
                              if (virq[5] == 1'b1) trap_vector <= vector ;  // получаем вектор прерывания
                              // получено подтверждение
                              if (vack == 1'b1) begin
                                vstb[5] <= 1'b0;             // 
                                state <= sq_trap ;  // переходим к обработке прерывания
                                sr2 <= {7'b0000000, vector} ; // записываем вектор в SR2
                                sr0_ic <= 1'b0 ; // снимаем флаг завершения выполнения инструкции
                             end 
                        end
               //*****************************************************         
               // Запрос векторного прерывания уровня 4
               //*****************************************************         
               sq_virq4 :
                        begin
                              // проверяем, не снят ли запрос прерывания
                              if (virq[4] == 1'b0) begin
                                 state <= sq_ifetch;
                                 vstb[4] <= 1'b0;
                              end   
                              // если не снят, поднимаем строб запроса вектора
                              else vstb[4] <= 1'b1;    
                              
                              // получение вектора прерывания
                              if (virq[4] == 1'b1) trap_vector <= vector ;  // получаем вектор прерывания
                              // получено подтверждение
                              if (vack == 1'b1) begin
                                vstb[4] <= 1'b0;             // 
                                state <= sq_trap ;  // переходим к обработке прерывания
                                sr2 <= {7'b0000000, vector} ; // записываем вектор в SR2
                                sr0_ic <= 1'b0 ; // снимаем флаг завершения выполнения инструкции
                             end 
                        end
               //*****************************************************         
               // Обработка прерываний FPU
               //*****************************************************         
               sq_fptrap :
                        begin
                           if (falu_pending_fic == 1'b1)  fec <= 4'b0110 ; 
                           if (falu_pending_fiu == 1'b1)  fec <= 4'b1010 ; 
                           if (falu_pending_fiv == 1'b1)  fec <= 4'b1000 ; 
                           if (falu_pending_divz == 1'b1) fec <= 4'b0100 ; 
                           fea <= ir_addr ; 
                           fps[15] <= 1'b1 ; 
                           if ((fps[14]) == 1'b0)  begin
                              trap_vector <= 9'o244; // вектор 244
                              state <= sq_trap ;  // переходим к обработке прерывания
                           end
                           else  begin
                              // ждем очистки флагов ожидания прерывания
                              if (falu_pending_fic == 1'b0 & 
                                  falu_pending_fiu == 1'b0 & 
                                  falu_pending_fiv == 1'b0 & 
                                  falu_pending_divz == 1'b0) state <= sq_ifetch ; 
                           end 
                           falu_pending_clear <= 1'b1 ; 
                        end
               //*****************************************************         
               // Ошибка контроля границ стека - красное состояние
               //*****************************************************         
               sq_rsv :
                        begin 
                              rbus_ix <= 3'o6;
                              state <= sq_rsv1;
                              rsv_flag <= 1'b1;
                        end
                  
               sq_rsv1:      
                        begin 
                              prev_sp <= rbus_o;
                              psw <= temp_psw ; 
                              rbus_waddr <= {2'b00, 4'b0110} ;  // SP режима kernel
                              rbus_d <= 16'h0004;               // устанавливаем в 4
                              rbus_we <= 1'b1 ;                 // поднимаем бит записи
                              trap_vector <= 9'o004;            // вектор 4
                              state <= sq_trap ;             // уходим в обработку прерывания
                              trap_flag <= 1'b0;
                              trap_force_kernel <= 1'b1;
                        end
                              
               //*****************************************************         
               // Обработка векторных прерываний - подготовка
               //*****************************************************
               sq_trap :
                        begin
                           // если это - повторное прерывание, произошло при обработке предыдущего
                           if (trap_flag == 1'b1) state <= sq_rsv;
                           else begin
                              trap_flag <= 1'b1;
                              finalreference <= 1'b0;                        
                              iwait <= 1'b0;
                              temp_psw <= psw ;     // сохранияем PSW
                              psw[15:14] <= 2'b00 ; // устанавливаем режим kernel
                              psw[13:12] <= pswmf[15:14] ; // устанавливаем биты предыдущиего режима
                              rbus_cpu_mode <= 2'b00 ; // переходим в режим kernel
                              state <= sq_trapa ; 
                           end   
                        end
               //**********************************************************      
               //*  Обработка векторных прерываний -  чтение PSW из вектора
               //*  и формирование рабочего PSW
               //*  Адрес на шине - вектор+2
               //**********************************************************
               //*  addr = trap_vector+2 - вектор+2
               //*  RD+
               sq_trapa : 
                        begin
                           rbus_we <= 1'b0;
                           wbm_adr_o <= trap_vector+16'd2;
                           nextstate <= sq_trapal;
                           state <= sq_wbread;
                        end

               sq_trapal :
                        begin
                           nxmabort <= nxmabort_pend;
                           rbus_ix <= 3'b110 ;    // регистр SP
                           if (trap_force_kernel | red_stack_trap)  rbus_cpu_mode <= 2'b00 ; 
                           else                                     rbus_cpu_mode <= datain[15:14] ; 
                           if (~trap_force_kernel) psw[15:14] <= datain[15:14] ;  // подавляем смену режима при красной ошибке стека
                           psw[11:0] <= datain[11:0] ; 
                           state <= sq_trapb ; 
                        end
               //******************************************************************      
               //*  Обработка векторных прерываний - запись в стек старого PSW
               //******************************************************************
               //*  addr = rbus_data-2 - SP-2
               //*  dataout=temp_psw
               //*  WR+
               sq_trapb :  
                       begin
                           wbm_adr_o <= rbus_data-16'd2;
                           wbm_dat_o <= temp_psw;
                           state <= sq_wbwrite;
                           nextstate <= sq_trapc ; 
                       end    
               //**********************************************************      
               //* Обработка векторных прерываний - декремент SP
               //**********************************************************
               sq_trapc :
                        begin
                           nxmabort <= nxmabort_pend;
                           if (red_stack_trap == 1'b1)  rbus_waddr <= {2'b00, 4'b0110} ; 
                           else                         rbus_waddr <= {pswmf[15:14], 4'b0110} ; 
                           rbus_d <= rbus_data-16'd2 ;    // sp-2
                           rbus_we <= 1'b1 ;          // включаем запись - обновляем SP
                           state <= sq_trapw;      
                        end
               //**********************************************************      
               //*  Обработка векторных прерываний - запись PC в стек
               //*  Адрес на шине - значение предыдущего SP-4
               //************************************************************************
               //*  addr = rbus_data-2 - SP-2
               //*  dataout=R7
               //*  WR+
               sq_trapw :
                        begin
                           wbm_adr_o <= rbus_data-16'd4;    
                           wbm_dat_o <= r7;
                           state <= sq_wbwrite;
                           nextstate <= sq_trapd ; 
                        end   
               //************************************************************************
               //* Обработка векторных прерываний -  декремент SP и установка режима ядра
               //* Чтение адреса обработчика из вектора
               //************************************************************************
               //*  addr = trap_vector - вектор, адрес перехода к обработчику прерывания
               //*  RD+
               sq_trapd :
                        begin
                           nxmabort <= nxmabort_pend;
                           if (red_stack_trap == 1'b1) rbus_waddr <= {2'b00, 4'b0110} ;           // обработка красной ошибки стека - используем стек ядра
                           else                        rbus_waddr <= {pswmf[15:14], 4'b0110} ;    // иначе - стек текущего режима
                           rbus_d <= rbus_data-16'd2 ;  // установка SP-2
                           rbus_we <= 1'b1 ; 
                           rbus_cpu_mode <= 2'b00 ; // устанавливаем режим KERNEL
                           wbm_adr_o <= trap_vector; // адрес вектора прерывания
                           state <= sq_wbread;
                           nextstate <= sq_trapf;
                        end
               //******************************************************************
               //* Обработка векторных прерываний - переход на адрес обработчика
               //******************************************************************
               sq_trapf :
                        begin
                           nxmabort <= nxmabort_pend;
                           trap_force_kernel <= 1'b0;
                           r7 <= datain ;         // новый PC
                           state <= sq_ifetch ;   // с этого РС начинаем выбирать команды
                           trap_flag <= 1'b0;
                           if (rsv_flag) begin
                             rsv_flag <= 1'b0;
                             rbus_waddr <= {2'b00, 4'b0110} ;  // SP режима kernel
                             rbus_d <= prev_sp;               // возвращаем старый SP
                             rbus_we <= 1'b1 ;                 // поднимаем бит записи
                           end  
                        end
               //**********************************************************
               //*  RTI - возврат из прерывания - инкремент SP
               //**********************************************************
               sq_rti :
                        begin
                           state <= sq_rtia ; 
                           rbus_waddr <= {pswmf[15:14], 4'b0110} ; 
                           rbus_d <= rbus_data+16'd2 ; // SP__
                           rbus_we <= 1'b1 ; 
                        end
               //**********************************************************
               //*  RTI - возврат из прерывания - чтение РС возврата
               //**********************************************************
               //*  addr = rbus_data - содержимое стека
               //*  RD+
               sq_rtia :
                        begin
                           nextstate <= sq_rtial;
                           wbm_adr_o <= rbus_data;
                           state <= sq_wbread;
                        end   
               sq_rtial :
                        begin
                           nxmabort <= nxmabort_pend;
                           state <= sq_rtib ; 
                           r7 <= datain ; 
                        end
               //**********************************************************
               //*  RTI - возврат из прерывания - чтение PSW 
               //**********************************************************
               //*  addr = rbus_data - содержимое стека
               //*  RD+
               sq_rtib :
                        begin
                           nextstate <= sq_rtibl;
                           wbm_adr_o <= rbus_data;
                           state <= sq_wbread;
                        end   
               sq_rtibl :
                        begin
                           nxmabort <= nxmabort_pend;
                           state <= sq_ifetch ; 
                           rbus_waddr <= {pswmf[15:14], 4'b0110} ; 
                           rbus_d <= rbus_data+16'd2 ;  // SP++
                           rbus_we <= 1'b1 ; 
                              psw[4:0] <= datain[4:0] ; 
                              if (pswmf[15:14] == 2'b00)  psw[7:5] <= datain[7:5] ; 
                              psw[10:8] <= datain[10:8] ; 
                              if (pswmf[15:14] == 2'b00)  psw[15:11] <= datain[15:11] ; 
                              else                        psw[15:11] <= datain[15:11] | pswmf[15:11] ; 
                        end
               //**********************************************************
               //*  SOB
               //**********************************************************
               sq_sob :
                        begin
                              rbus_waddr <= {pswmf[15:14], pswmf[11], ir[8:6]} ; 
                              rbus_d <= rbus_data-16'd1 ; 
                              rbus_we <= 1'b1 ; 
                              if (rbus_data == 16'b0000000000000001)  state <= sq_ifetch ; 
                              else  begin
                                 r7 <= r7 - ({ir[5:0], 1'b0}) ; 
                                 state <= sq_ifetch ; 
                              end 
                        end
               //**********************************************************
               //*  MFPI/MFPD - чтение кода/данных из предыдущего режима
               //**********************************************************
               sq_mfp :
                        begin
                           rbus_ix <= 3'b110 ;      // SP
                           state <= sq_mfpa ; 
                        end
               //* addr = rbus_data-2
               //* RD +         
               sq_mfpa :
                        begin
                           dest_addr <= rbus_data-16'd2;      // адрес записи - SP-2
                           state <= sq_store_alu_p ;  // следующий этап - сохранение результатов АЛУ
                           sr1_srcd <= sr1_m2 ; 
                           rbus_waddr <= {psw[15:14], 1'b0, 3'b110} ;  // запись SP
                           rbus_d <= rbus_data-16'd2 ;                     // sp-2
                           rbus_we <= 1'b1 ; 
                        end
               //***********************************************************************
               //*  MFPI/MFPD - запсь кода/данных в пространство предыдущего режима
               //***********************************************************************
               //*  addr=rbus_data  - SP
               //*  RD +
               sq_mtp : 
                        begin
                           wbm_adr_o <= rbus_data;
                           nextstate <= sq_mtpl;
                           state <= sq_wbread;
                        end
               sq_mtpl :
                        begin
                           nxmabort <= nxmabort_pend;
                           sr1_srcd <= sr1_p2 ; 
                           rbus_waddr <= {psw[15:14], 1'b0, 3'b110} ; 
                           rbus_d <= rbus_data+16'd2 ; 
                           rbus_we <= 1'b1 ; 
                           state <= sq_mtpa ; 
                        end
               sq_mtpa :
                        begin
                           alus_input <= datain ; 
                           rbus_ix <= ir[2:0] ; 
                           state <= src_mode_processor ; 
                        end
               //**********************************************************
               //*  Загрузка 32-битных операндов EIS-инструкций
               //**********************************************************
               sq_dopr :
                        begin
                           rbus_ix <= ir[8:6] ;    // выбираем номер регистра-операнда
                           state <= sq_dopra ; 
                        end
                        
               sq_dopra :
                        begin
                           // загрузка старшей части операнда
                             // Для случая, когда операнд 1 - PC, и используется индексная адресация, надо сдвинуть значение на слово назад
                           if ((ir[8:6] == 3'b111) && (ir[5:4] == 2'b11)) alus_input <= rbus_data-2 ;
                             // остальные случаи
                           else                   alus_input <= rbus_data ; 
                           rbus_ix <= {ir[8:7], 1'b1} ;        // выставляем номер следующего нечетного регистра
                           
                           if (ir[11:9] == 3'b000) begin
                              // MUL
                              eis_sequencer <= 5'b11111 ; 
                              state <= sq_mul ; 
                           end
                           else if (ir[11:9] == 3'b010) begin
                              // ASH
                              eis_sequencer <= 5'b11111 ; 
                              state <= sq_ash ; 
                           end
                              // XOR
                           else if (ir[11:9] == 3'b100) state <= sq_xor ; 
                              // остальные инструкции
                           else    state <= sq_doprb ; 
                        end
               // Дополнительный шаг - загрузка младшей части операнда
               sq_doprb :
                        begin
                           alut_input <= rbus_data ;  // младшая часть из нечетного регистра
                           
                           // DIV
                           if (ir[11:9] == 3'b001) begin
                              if (ir[6] == 1'b1) begin
                                 // Ошибка - регистр-операнд должен быть четным
                                 state <= sq_ifetch ;  // прекращаем обработку инструкции
                                 psw[3:0] <= 4'b0010 ; // V=1, остальные флаги - 0
                              end
                              
                              else  begin
                                 eis_sequencer <= 5'b10000 ; 
                                 state <= sq_div ;     // переходим непосредственно к делению
                              end 
                           end
                           
                           // ASHC
                           else if (ir[11:9] == 3'b011)  begin
                              eis_sequencer <= 5'b11111 ; 
                              state <= sq_ashc ; 
                           end
                           else    state <= sq_illegalop ; // неподдерживаемые EIS-коды
                        end
                        
               //************************************************************         
               // MUL: умножение. Ожидание секвенсера EIS 
               //************************************************************         
               sq_mul :
                        begin
                           if (eis_sequencer == 5'b00001)  state <= sq_mula ; 
                           eis_sequencer <= eis_sequencer + 5'd1 ; 
                        end
               //************************************************************         
               // MUL: умножение. Запись младшей части результата
               //************************************************************         
               sq_mula :
                        begin
                           if (ir[8:6] != 3'b111)   begin
                              // для регистров-приемников кроме PC
                              rbus_waddr <= {pswmf[15:14], pswmf[11], ir[8:6]} ; 
                              rbus_d <= eis_output ; 
                              rbus_we <= 1'b1 ; 
                           end
                           // для PC
                           else  r7 <= eis_output ; 
                           state <= sq_mulb ; 
                        end
               //************************************************************         
               // MUL: умножение. Запись старшей части результата
               //************************************************************         
               sq_mulb :
                        begin
                           if (ir[8:7] != 2'b11)  begin
                              // кроме PC
                              //                                               !- принудительно выставляем нечетный регистр
                              rbus_waddr <= {pswmf[15:14], pswmf[11], ir[8:7], 1'b1} ; 
                              rbus_d <= eis_output32 ; 
                              rbus_we <= 1'b1 ; 
                           end
                           // для PC 
                           else r7 <= eis_output32 ; 
                           psw[3:0] <= eis_psw ; 
                           state <= sq_ifetch ; 
                        end
               //************************************************************         
               //* DIV: деление. 
               //************************************************************
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
