forth32/dvk-fpga/(commit log)

2021-03-02 Первоначальная загрузка репозитория
    [card-layout.ods]
2021-03-02 Первая работоспособная версия. Пока только ВМ2. Тестируем...
2021-03-02 Готовы все процессорные платы. Вроде пока все работает
2021-03-02 Удаление лишних qip-файлов
2021-03-02 Сделано управление тактовой частотой настройки PLL теперь задаются в конфиге для каждого процессора отдельно
2021-03-03 Добавлен новый файл pll.v взамен старого pll100
2021-03-03 Удаление лишних файлов
2021-03-03 Делители таймеров привязаны с тактовой частоте, задаваемой в конфиге
2021-03-03 Назначение кнопок, выключателей, чветодиодов вынесено в интерфейсный модуль
2021-03-03 Исходники приведены в удобочитаемый вид. Подготовка платы A-ESTF окончена.
2021-03-03 Добавлена плата ALINX AX4010
2021-03-03 Начато добавление платы rz301
2021-03-03 Закончена плата OMDAZZ rz301
2021-03-04 Добавлены описания для плат rz301 и A-ESTF
2021-03-04 Добавлена документация по AX4010
2021-03-05 В документацию к платам внесена таблица органов управления-индикации
2021-03-05 Доработка док
2021-03-05 Начал добавлять плату Qmtech E55
2021-03-06 Полностью готова плата QMTECH E55
2021-03-06 Переделка главной доки
2021-03-06 В главной доке исправлено оглавление
2021-03-06 Первый более-менее запускающийся вариант платы A-E115
2021-03-06 Полностью закончен порт на A-E115
2021-03-06 Очередная доработка документации
    [pinout.ods]
2021-03-06 Окончательная проверка документации
2021-03-07 Подправил комментарии в заголовках интерфейсных модулей. Без этого получится большая путаница, ибо заголовок отображал неправильное имя платы
2021-03-07 Ширина переключателя sw_diskbank увеличена до 7 бит
2021-03-07 На плату QMTECH E55 добавлено подключение блока переключателей конфигурации
2021-03-08 Небольшая косметическая правка дисковых утилит
2021-03-08 Пересборка дисковых утилит
2021-03-14 Первая попытка сделать порт на Tang Primer. Пока работает только ВМ2 и дисковая подсистема.
2021-03-16 TANG-плата дополнена платой интерфейсов. Распиновка проекта приведена в соответствие с этой платой
2021-03-17 Первая попытка подключения блока КСМ
2021-03-17 Добавлены описатели распиновок платы
    [pinout.ods]
2021-03-17 VGA интерфейс заработал. Пока не работает PS/2
2021-03-17 Добавлены новые ip-компоненты
2021-03-17 Клавиатура КСМ заработала
    [pinout.ods]
2021-03-18 Запустился модуль КГД
2021-03-18 Первая попытка запустить ВМ1. Пока не работает. Похоже, местный компилятор не синтезирует конструкции initial.
2021-03-18 Процессор ВМ1 работоспособен
2021-03-18 Заработал LSI-11 (M2)
2021-03-18 Заработал процессор М4
2021-03-19 Подклбчено ПЗУ пользователя с выбираемым имененм файла инициализации Остальные мегафункции ПЗУ также исправлены для выбора имени файла через конфиг
    [config.v, memory_adapter.v]
2021-03-19 Тактовая частота снижена до 60 МГц для устранения отрицательных слаков
2021-03-19 Изменена ширина фильтров сигналов SDSPI. Стабильность работы дисков повысилась.
2021-03-20 Revert "Изменена ширина фильтров сигналов SDSPI. Стабильность работы дисков повысилась."
    This reverts commit a696d96372a9b44ce45350af983b057855cd548d.
    [pll.v, sdspi.v]
2021-03-21 Исправлена обработка ошибок в модуле SDSPI
    [config.v, pll.v, sdspi.v]
2021-03-22 Арбитр SD-карт перенесен в тактовый домен SD-карты. Мультиплексор линий SD больше не дает ложных выбросов. Загрузка со всех дисков заработала без всяких проблем.
    Тактовые частоты, выдаваемые PLL tang-платы приведены в соответствие друг другу, фронты процессора и SD теперь синхронны.
2021-03-23 Тактовые частоты платы Qmtech E55 приведены в соответствие с timing analyzer. Все диски работают четко и стабильно
2021-03-23 Написана документация к tang-плате. Исходники причесаны и отформатированы
2021-03-23 Исправлен Readme.md
2021-03-23 Добавлена картинка внешнего вида платы tang
2021-03-23 Добавлена еще одна картинка платы tang
2021-03-25 SDSPI упрощен - выкинуты сигналы ack. DW переделан под новый интерфейс
2021-03-25 Очистка кода от лишних регистров
2021-03-25 Продолжение очистки схемы
2021-03-25 Новый sdspi - чтение заработало
2021-03-25 Запись заработала. Модуль sdspi переделан на единый буфер!
2021-03-25 Интерфейс sdspi переделан на более логичный набор сигналов
2021-03-25 оптимизация схемы закончена
2021-03-26 Запись почти заработала. Не дописывается 1 слово в конце сектора
2021-03-26 Запись DX заработала полностью
2021-03-26 Начало переделки контроллера MY
2021-03-27 Полностью работоспособный MY с новым вариантом sdspi
2021-03-27 Заработал контроллер RK11
2021-03-27 Окончательная переделка модуля SDSPI. Отдельные буфера чтения-записи заменены общим буфером, выполненным в виде мегафункции двухпортовой RAM. Упрощен протокол SDSPI - выкинута лишняя пара квитирующих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
2021-03-27 TANG заработал - добавлена мегафункция секторного буфера
2021-03-27 в sdspi добавлен счетчик повторов перед ошибкой
2021-03-28 Исправлена схема обработки ошибок карты. Теперь ошибочное состояние корректно завершает работу sdspi. Делается 4 попытки произвести обмен с картой. В случае неудачи поднимается флаг card_error и io_d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
    [sdspi.v]
2021-03-28 Приведение в порядок и форматирование исходников
2021-04-16 Исправление документации по секторному буферу SDSPI
2021-06-23 Добавлены забытые ранее файлы
    [pinout.ods]
2021-06-23 Добавлен контроллер RK611. Начинаю подключать его к проектам плат
2021-06-24 Добавлен rk611 для платы E55. Добавлен монитор 9312.
2021-06-28 Временная оптимизация проекта Полностью работоспособен монитор 9312. Загрузка возможно из всех источников. Исправлен формирователь сигнала reply модуля UART
    [config.v, fdd-my.v, kgd-graphics.v, ksm.v, rk11.v, rk611.v, rx01.v]
2021-06-28 Добавлены файлы монитора m9312
2021-06-29 Код bootrom перенесен в пространство 164000-165776. Схема bootrom теперь является частью процессорного модуля. Исправлены мелкие ошибки в RK611
    [bootrom.v, config.v, mc1201-02.v, rk611.v]
2021-06-30 Модуль bootrom перенесен из topboard на процессорные платы. Все 4 платы корректно работают.
2021-06-30 Форматирование исходников
2021-06-30 Оптимизация временных параметров 1201.02
2021-06-30 Исправлена документация Добавлен диск DM0: в образ initdisk
    [card-layout.ods]
2021-06-30 Доработаны и проверены все платы, кроме TANG
2021-07-02 Проверена плата tang. Вроде все работает.
2021-07-02 Добавлены новые файлы
2021-07-03 Объединены одинаковые SDC-файлы для разных плат. Исправлены мелкие ошибки в назначении выводов AX4010
    [ax4010.v]
2021-07-03 Удалены ненужные файлы
2021-07-03 Обновление документации
2021-07-29 Испрнавлена ошибка в модуле RK611, приводящая к ошибочному формированию сигнала PGE в процессе записи регистров. Ошибка не влияет на RT-11, но прводит к невозможности загрузки RSTS и RSX11M+
2021-07-31 Исправлена ошибка в модуле UART, приводившая к случайной повторной посылке того же байта
    [wbc_uart.v]
2021-07-31 Заменена версия модуля UART на более правильную
2021-08-14 Добавлены файлы процессора pdp2011 и контроллера RH70
2021-08-14 Исправлена работа контроллера DW с учетом таймингов общей шины
    [dw.v, qmtech.v]
2021-08-15 Плата pdp2011 как-то заработала. Монитор запускается, но загрузки с дисков пока нет.
2021-08-17 Заработала загрузка с DX, DW и DB. Не работает DMA, идущий через MMU
2021-08-18 Заработало DMA дисков DK и DM.
2021-08-21 Исправлена работа диска DB - данные искажались при записи Контроллер MY переделан для работы с 22-битным адресом Введена буферизация адреса сектора в контроллере RK11
    [config.v, fdd-my.v, pdp2011.v, qmtech.v, rh70.v, rk11.v, topboard22.v]
2021-08-21 Добавлены индикаторы и кнопки управления для 22-битных плат
2021-08-21 Исправлено поведение индикатора IDLE
    [qmtech.v]
2021-08-21 Тактовая частота памяти поднята в 2 раза. Пока сбоев нет, кроме отсутствия загрузки с DW. Оптимизированы линии коммутации шины между процессором и DMA-устройствами. Лишние коммутаторы пошли в помойку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
2021-08-22 Добавлен режим замедления процессора
2021-08-22 Чистка кода - этап 1
2021-08-22 Чистка кода - этап 2
2021-08-22 Доделана плата A-ESTFv2. Все работает.
2021-08-22 Подготовлена плата AX4010. pdp2011 туда, конечно, не влазит, но изменение структуры проекта требует исправить и ее. Удвоение скорости памяти заработало без вопросов.
    [ax4010.v, config.v, pll.v]
2021-08-22 Доработана плата OMDAZZ. Удвоение частоты памяти на ней я не делал.
2021-08-22 Для платы TANG сделано удвоение частоты памяти. Все работает.
2021-08-22 В плату tang добавлен pdp2011. Работает все, кроме таймера KW11-L.
2021-08-22 Таймер tang заработал
2021-08-24 Приведение в порядок исходников RH-11
2021-08-28 Исправлена ошибка в контроллере MY, приводившая к периодическому зависанию шины
    [aestf.v, ax4010.v, config.v, cpu_control_regs.v, dw.v, fdd-my.v, fpuregs.v, kgd-graphics.v]
2021-08-28 Восстановлена работоспособность RSTS
2021-09-07 Восстановлена нормальная работа дисков DB под RSTS
2021-09-07 Доработан контроллер ИРПР для совместимости с RSTS10
2021-09-08 Восстановлена работа ПЗУ загрузчика-эмулятора пульта на МС1201.02
2021-09-09 Для всех процессорных плат софрмирован правильный блок ПЗУ загрузчика
2021-09-09 Исправлен скрипт подготовки образа ПЗУ загрузчика
2021-09-12 Исправлен блок монитора-загрузчика для платы TANG
    [aestf.v, config.v, dw.v, irpr-centronix.v, mc1201-01.v, pdp2011.v, qmtech.v, tang.v]
2021-09-13 Доработка основной документации
2021-09-13 Написан первоначальный вариант доки по pdp2011
2021-09-14 Подготовлен новый образ стартового диска, с системами RSX-11M[plus] и RSTS/E
2021-09-15 Вычитка документации Добавление скриншотов
    [card-layout.ods]
2021-09-16 Исправление документации
2022-10-24 Начальная загрузка файлов процессора F11
    [card-layout.ods]
2022-10-24 Заготовка для новой процессорной платы KDF11
2022-10-29 ODT заработал. Проблемы с начальным пуском и адресацией модулей ПЗУ.
2022-10-31 Загрузка XXDP с DX0: наконец заработала. Большинство тестов пока или виснут, или сыпят ошибками. Будем разбираться.
2022-11-02 Подготовка конфига для FPGA-платы A-ESTFv2
2022-11-03 Запуск на плате A-ESTF
2022-11-23 Исправленная версия WB-адаптера от VSLAV
    [f11_wb.v]
2022-11-23 Исправлена схема, обеспечивающая протокол обработки прерываний. Тесты JKDB и JKDD заработали
2022-11-24 Собрана первичная схема DMA. Пока работает неправильно - процессор не тормозится сигналом GNT
2022-11-25 Исправлены ошибки в схеме DMA. Теперь все диски работают. RSX11 и RSTS пока не грузятся.
2022-11-25 Включено прерывание от таймера
2022-12-03 Набор последних накопившихся изменений.
2022-12-03 Приделал регистр управления таймером RSX грузится чуть дальше, но все равно вылетает. Проблема PSW осталась.
2022-12-05 Внесены исправления модуля процессора от VSLAV. Теперь вроде как все заработало.
    [config.v, f11_wb.v]
2022-12-05 kdf11.v переименован в kdf11-b.v для уточнения типа платы
2022-12-05 Начало работы по внедрению подсистемы Bootrom/Diagnostic
2022-12-06 Добавлены все файлы подсистемы rom-diagnostic F11 Исправлена ошибка в дркументации
2022-12-10 Продолжение работ по внедрению родного ПЗУ
2022-12-10 В ПЗУ загрузки-диагностики добавлены загрузчики DB и DM взамен бесполезных DL и DD. Теперь можно грузиться со всех устройств.
2022-12-11 В ПЗУ загрузки-диагностии добавлен загрузчик MY Теперь в этом ПЗУ лежит полный набор загрузчиков для всех дисков, кроме DW
2022-12-17 Первая попытка внедрения Unibus Mapping
2022-12-18 Исправлена реализация UMAP, теперь М+ грузится с DM. Проблемы с загрузкой с DB остались.
    [kdf11-b.v]
2023-01-20 Временные патчи для корректной работы DB в RSX-11M
2023-07-19 Исправление мелких опечаток. Добавлен флаг massbus для переключения контроллера RH-70 в режим RH-11 для работы через UMR
    [config.v, kdf11-b.v, rh70.v, topboard22.v]
2023-09-15 Доработка подсистемы DMA для обработки диска DB в вариантах massbus/UMR. заранее сохраненный RSX ткпкрь грузится корректно.
2023-09-21 Добавлены файлы модификации бутромов
2023-09-24 Сделан корректный выбр вектора ИРПС2. Косметическая правка исходников
2023-09-24 Добавлена индикация работы MMU
2023-12-29 Восстановлена работа платы pdp2011
2023-12-29 Выделена общая часть конфигов в отдельный файл
2023-12-30 Приведены в порядок окнфиги некоторых плат
2024-08-30 Подготовлена к компиляции плата A-ESTFv2 - исправлено дерево файлов проекта
2024-08-30 В проект добавлены фалы процессора ВМ3
2024-08-31 Первая попытка сождания схемы платы МС1201.03/04 Убраны ошибки компиляции
2024-08-31 Добавлены файлы ROM -134
2024-08-31 Исправлен модуль теневого ОЗУ для поддержки байтового режима доступа
    [mc1201-04.v]
2024-08-31 Исправлен разбор выходного адреса на сам адрес и SEL
    [mc1201-04.v]
2024-08-31 Исправлен режим пуска процессора
    [mc1201-04.v]
2024-09-28 1201-04 заработал до промпта @. Разработка вернулась на любимую плату Qmtech E55
2024-09-29 Полный запуск ВМ3. Уже грузится система с MY
2024-09-29 Добавлена обрезка памяти до 1М, как в 1201.04
2024-10-01 Упрощен формирователь выбора теневых ОЗУ/ПЗУ
2024-10-04 Исправлен загрузчик DK в оригинальной ROM 134. Теперь загрузка идет с DK0..DK7
    [fdd-my.v]
2024-10-12 Дополнительный патч ПЗУ для починки загрузчиков Теперь работает загрузка с DM, DB, DK, MY. Должна работать и с DW, но там проблемы с драйвером RT-11
2024-10-15 Написана утилита для коррекции контрольной суммы ROM 134
2024-10-21 Исправление процессора ВМ3 от VSAV - теперь extended-монитор грузится нормально
    [config.v, rh70.v, vm3_wb.v]
2024-11-03 Мелкие исправления конфига
2024-11-20 Найдена вторая ошибка в процессоре ВМ4 - залипание битов предыдущего режима в PSW. Великий VSLAV ее исправил, теперь на ВМ4 грузятся все системы.
    [vm3_wb.v]
2024-11-21 Опять ВМ3. Великий VSLAV исправил блок преобразования адреса, теперь XXDP-тест FKTH идет без ошибок. Собственно, теперь ни один тест ошибок не выявляет, что, как показала практика, мало о чем говорит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
    [vm3_wb.v]
2024-12-06 Восстановлена работоспособность порта для AX4010
2024-12-06 Восстановлена работоспособность порта для RZ301
2024-12-07 Восстановлена работоспособность порта для A-ESTFv2
2024-12-12 Восстановлена работоспособность платы tang
2024-12-15 Правка чистоты кода схем для минимизации предупреждений
2025-01-08 Начальная версия документации
2025-01-08 Правка документации
2025-01-10 Добавлено ПЗУ версии 377 от ДВК-4
2025-01-11 Доработка монитора 377 Продолжение правки документации
2025-01-12 Продолжение правки документации Реализовано отключение подсистемы LTC
2025-01-18 ВМ3: выведены сигналы индикации включения MMU и UMR. Унифицировано обозначение индикаторных светодиодов для всх 22-битных плат Документация доработана для отразения всех этих изменений
2025-01-18 Исправлены конфиги и схемы всех плат в соответствие с общим стандартом
    [aestf.v, ax4010.v, config.v, omdazz.v, tang.v]
2025-01-19 Финальный патч ПЗУ 377. Загрузка с DM заработала.
2025-01-25 Мелкая правка внешнего вида исходников
2025-01-25 Правка README
2025-01-25 Дополнительная правка README
2025-01-26 Исправлен сигнал ответа от ПЗУ пользователя на 16-битной плате Теперь бейсик запускается без проблем
    [config.v, topboard16.v]
2025-01-26 Дополнительная правка ПЗУ 055 на предмет загрузки с RK05
2025-01-26 Дополнительная правка ПЗУ 279 на предмет загрузки с RK05
2025-01-27 Дальнейшая доработка документации. Добавлн скриншот RSX
2025-01-27 Чистка документации
2025-02-01 Найдена и исправлена древняя ошибка - неправильный адрес регистра DWERR
    [config.v, dw.v]
2025-02-02 Финальная подготовка к релизу
2025-07-13 Исправлена ошибка, приводящая к невозможности сборки всех 16-битных процессоров на плате AX4010
    [ax4010.v, config.v]
